wifasoi/PrusaMendel/docs/documentation.pdf

## Prusa Mendel iteration 2 Documentation

ThingDoc

November 16, 2011


Prusa Mendel is simplified version of Mendel form RepRap project. RepRap is open source 3D printer.

## Contents

## 1 Bill of Materials

List of things you need to build the machine divided by categories.

### 1.1 Rods and Bars

- 1x Idler

### 1.2 Nuts&bolts

- 3x 608 skate bearing
- 4x M4 nut
- 3x M3 10mm screw
- 2x M4 25mm screw
- 1x M8 hobbed bolt
- 8x M3 15mm screw with HEX head
- 2x M3 10mm screw with hex head
- 1x M3 25mm screw
- 1x M3 grub screw
- 2x M3 25mm screw with HEX head
- 12x M3 nut
- 73x M8 washer
- 74x M8 nut
- 29x M3 washer
- 1x M3 10mm screw with flat head
- 2x M3 40mm screw

### 1.3 Printed

- 1x Extruder body
- 8x Bar clamp
- 4x Y bushing
- 2x Frame vertex
- 1x Y motor bracket
- 1x Small extruder gear

- 2x Rod clamp
- 4x Frame vertex with foot
- 1x Large extruder gear
- 2x Belt clamp
- 1x Extruder Idler
- 1x Z motor mount
- 1x X carriage

## 2 Things Overview

List of things and their descriptions.

### 2.1 Coupling tube

20mm long piece of PVC tube. 5mm inside diameter, 8mm outside diameter.

### 2.2 Frame triangle

Two triangle parts which will later form a frame.

### 2.3 Frame with axes

Frame with all axes mounted

### 2.4 Frame vertex


### 2.5 Frame

Frame for adding all of the other parts There is a triangle on each side of the Prusa RepRap. You will need to make two of these and then connect them together (in the next steps) to form the Prusa frame. Each side is an equilateral triangle with a frame vertex on each corner. You can use either footed or non-footed vertices to build this. (The footed ones look better, but are not critical.) The instructions assume you are using footed vertices.

### 2.6 Y motor bracket


### 2.7 Belt clamp


### 2.8 M8 hobbed bolt

### 2.9 Extruder Idler

Extruder idler

### 2.10 Frame with Y axis

Frame with Y axis mounted

### 2.11 Y bushing

### 2.12 Bar clamp


### 2.13 XZ axis

Assembled XZ axis

### 2.14 Large extruder gear

### 2.15 Frame vertex with foot


### 2.16 X end motor

### 2.17 Extruder body

Extruder body

### 2.18 Small extruder gear

### 2.19 Extruder spring

Spring used for idler on extruder.

### 2.20 Printable Bushing

### 2.21 X carriage


### 2.22 X end idler

### 2.23 Rod clamp


### 2.24 Z motor mount


### 2.25 Endstop holder

### 2.26 Bushing

### 2.27 Idler

Small M8 rod

### 2.28 Pulley

### 2.29 Coupling

### 2.30 Y axis

Assembled Y axis

### 2.31 Bearing guide

Helps to hold belt aligned on the bearing.

### 2.32 Carriage

X-carriage with mounted extruder

### 2.33 Extruder

Extruder

## 3 Assembly Instructions

### 3.1 Assemble Small extruder gear

Things needed:

- 1x M3 nut
- 1x M3 grub screw

Steps:

1. Insert nut into cavity in printed gear.
2. Tighten the grub screw a bit, just to hold in place.

### 3.2 Assemble M8 hobbed bolt

Steps:

1. Use thread cutting bit in electric screwdriver ...

### 3.3 Assemble Large extruder gear

Things needed:

- 1x M8 hobbed bolt

Steps:

1. Insert hobbed bolt into main hole.
2. Add some M8 washers from other side, later with their count you adjust position of hobbed part in filament path.

### 3.4 Assemble Extruder Idler

Things needed:

- 1x 608 skate bearing
- 1x Idler

Steps:

1. Insert piece of M8 rod into bearing.
2. Insert 608 bearing with rod into printed idler part.

### 3.5 Assemble Extruder

Things needed:

- 2x 608 skate bearing
- 1x Extruder body
- 3x M3 10mm screw
- 2x M4 nut
- 1x Small extruder gear
- 1x M3 25mm screw
- 1x NEMA17 stepper motor
- 1x Large extruder gear
- 8x M3 washer
- 1x M8 washer
- 1x Extruder Idler
- 1x M3 nut
- 2x M3 40mm screw
- 2x Extruder spring
- 2x M8 nut

Steps:

1. Take idler and insert nut into small nut-trap inside the hinge.
2. While holding the nut in place, preprare M3x25 bolt with washer and screw it into the hinge just enough to hold the nut.
3. Now take the extruder body and idler. Place idler on the hinge counterpart and com-pleately screw the M3x25 bolt. This will create secured hinge.
4. Place M4 nuts into their nut traps, secure them with piece of tape. We need them in place, since later they would be harder to access.
5. Prepare your NEMA17 stepper motor and three M3x10 screws with washers.
6. Hold motor on place and lightly tighten the screws. We need to adjust motor position later, no need to tighten it hard.
7. Place two skate bearings on ther position, they should snuggly fit in.
8. Insert prepared large gear into the body with mounted bearings.

9. Check if the alignment of hobbed part with the filament path. Adjust it accordingly with adding or removing M8 washers.
10. After adjusting, we need to fix the bolt in. So we place washer at the end of hobbed bolt and with two M8 nuts we will do locknut by tightening them against each other.
11. Check if large gear turns freely.
12. Prepare two M3x40 screws with sandwitch of washer-spring-washer.
13. Insert two M3 nuts into nut traps on top of drive mechanism.


14. Insert prepared screws into the holes on idler. Close the idler and tighten the screws into the trapped nuts. More you tighten those screws, more pressure will be on fillament.
15. Your extruder is done.


### 3.6 Assemble Frame triangle

Things needed:

- 1x Bar clamp
- 1x Frame vertex
- 2x Frame vertex with foot

Steps:

1. Take one of the 370mm threaded rods, and slip an M8 washer onto the middle of it.
2. Take the RP bar clamp (the U-shaped bit with the two holes) and slide the threaded rod through the two holes until the clamp sits next to the washer.
3. Slide another washer onto the rod from the other side.
4. Thread two M8 nuts onto either side of the clamp, until they are next to the washer, but do not tighten them yet.

5. Thread another two nuts on each side of the rod, followed by washers. See the picture for what it should look like.


6. The bar clamp on the threaded rod.
7. Slide the rod through the wider bottom (footed) side of two vertices. Make sure the feet point in the same direction, and the bulge on the non-footed sides of the vertices point outwards.
8. Measure the distance. The distance between the two vertices should be 290mm (along the rod, equivalent is 11-13/32”). Get it approximately right now, we will check this again later. If you have a frame jig, place it between the two vertices and adjust the nuts until you can just barely fit the jig J1 between them.
9. Place another washer and nut on the other side of the vertex. Tighten, but not too much. We’ll need a bit of flexibility here still.
10. Take another 370mm M8 threaded rod and place a nut followed by a washer at each end.
11. Place one end of the threaded rod into the one of the two footed frame vertices. It should be in the same plane as the first threaded rod. Fix it in place with a washer and nut. You should now have two sides of the equilateral triangle.
12. Take the third piece of threaded rod and put a nut and washer on each end. Place it in the other footed vertex and fix it in place with a washer and nut. You should now have a triangle of threaded rods with two footed vertices on two of the corners, nothing in the third corner, and a bar clamp between the two vertices.
13. Take the third vertex (non-footed) and slide it onto the threaded rods in the final corner of the triangle. Measure the lengths of the three sides to make sure they are all 290mm long (along the rod from plastic part to plastic part, equivalent is 11-13/32”). Adjust the nuts to make sure this is so. Use the frame jig J1 if you have one. Once done, place a washer and nut on each of the two rods at the top of the vertex. Tighten all the outer nuts.
14. The finished frame triangle
15. You should now have a sturdy triangle with equal-length sides, two feet on the bottom, and a bar clamp between the feet. Adjust the nuts around the bar clamp (but do not crush the bar clamp together yet) until it’s approximately in the middle of the rod. Leave the nuts there loose. See the photo for what you should have at this point.

16. That’s it, that’s one of the triangles done. Repeat the entire procedure for the second triangle. It is identical to the first.


### 3.7 Assemble Prusa Mendel iteration 2

Things needed:

- 1x Carriage
- 1x Frame with axes

Steps:

1. Assembly info
