wifasoi/PrusaMendel/Stampante3D conversion/Export/Images/image1.png

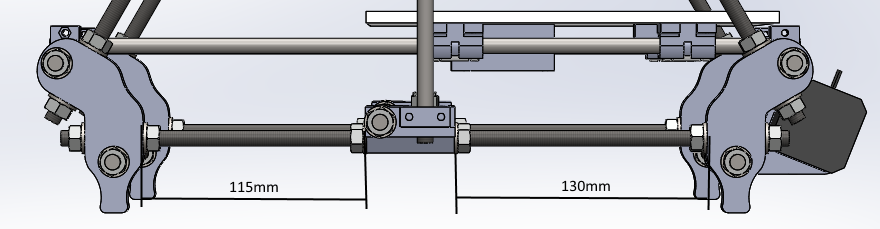
Stampante3D conversion/Export/Images/image1.png
