wifasoi/PrusaMendel/Stampante3D conversion/Export/Images/image2.png

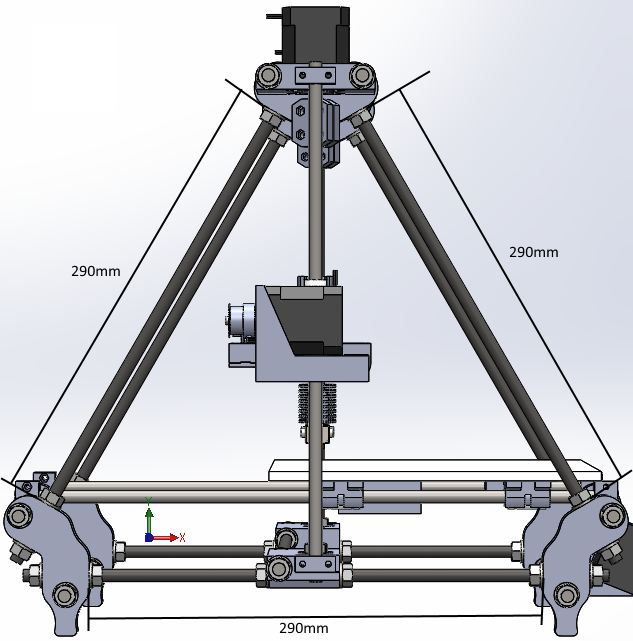
Stampante3D conversion/Export/Images/image2.png
