wifasoi/PrusaMendel/Stampante3D conversion/Export/Images/image3.png

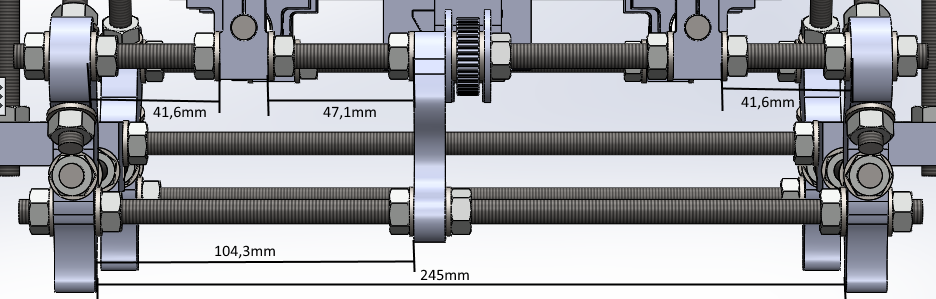
Stampante3D conversion/Export/Images/image3.png
