wifasoi/PrusaMendel/Stampante3D conversion/Export/Images/image4.png

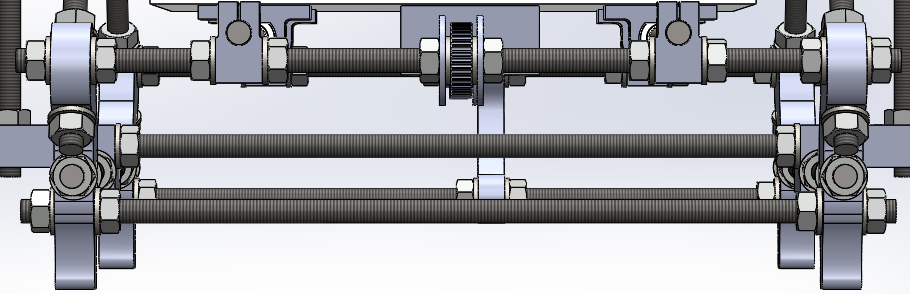
Stampante3D conversion/Export/Images/image4.png
