wifasoi/PrusaMendel/SolidWorks/Vitamins/flat washer, DIN 125.xlsx

flat washer, DIN 125 Data aken from McMaster-Carr catalog |  |  | MMC
 | ID@Sketch1 | OD@Sketch1 | thickness@Boss-Extrude1 | $prp@Size | $prp@Finish | $prp@Class | $prp@Material
M01.0 Zinc Plated Class 4 Steel | 1.1 | 3.2 | 0.35 | 1 | Zinc Plated | 4 | Steel
M01.2 Zinc Plated Class 4 Steel | 1.3 | 3.8 | 0.35 | 1.2 | Zinc Plated | 4 | Steel
M01.4 Zinc Plated Class 4 Steel | 1.5 | 3.8 | 0.35 | 1.4 | Zinc Plated | 4 | Steel
M01.6 Zinc Plated Class 4 Steel | 1.7 | 4 | 0.35 | 1.6 | Zinc Plated | 4 | Steel
M02.0 Zinc Plated Class 4 Steel | 2.2 | 5 | 0.35 | 2 | Zinc Plated | 4 | Steel
M02.5 Zinc Plated Class 4 Steel | 2.7 | 6 | 0.55 | 2.5 | Zinc Plated | 4 | Steel
M03.0 Zinc Plated Class 4 Steel | 3.2 | 7 | 0.55 | 3 | Zinc Plated | 4 | Steel
M03.5 Zinc Plated Class 4 Steel | 3.7 | 8 | 0.55 | 3.5 | Zinc Plated | 4 | Steel
M04.0 Zinc Plated Class 4 Steel | 4.3 | 9 | 0.9 | 4 | Zinc Plated | 4 | Steel
M05.0 Zinc Plated Class 4 Steel | 5.3 | 10 | 1.1 | 5 | Zinc Plated | 4 | Steel
M06.0 Zinc Plated Class 4 Steel | 6.4 | 12 | 1.8 | 6 | Zinc Plated | 4 | Steel
M07.0 Zinc Plated Class 4 Steel | 7.4 | 14 | 1.8 | 7 | Zinc Plated | 4 | Steel
M08.0 Zinc Plated Class 4 Steel | 8.4 | 16 | 1.8 | 8 | Zinc Plated | 4 | Steel
M10.0 Zinc Plated Class 4 Steel | 10.5 | 20 | 2.2 | 10 | Zinc Plated | 4 | Steel
M12.0 Zinc Plated Class 4 Steel | 13 | 24 | 2.7 | 12 | Zinc Plated | 4 | Steel
M14.0 Zinc Plated Class 4 Steel | 15 | 28 | 2.7 | 14 | Zinc Plated | 4 | Steel
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
M05.0 18-8 Stainless Steel | 5.3 | 10 | 1.1 | 5 |  |  | 18-8 Stainless Steel
M06.0 18-8 Stainless Steel | 6.4 | 12 | 1.8 | 6 |  |  | 18-8 Stainless Steel
M07.0 18-8 Stainless Steel | 7.4 | 14 | 1.8 | 7 |  |  | 18-8 Stainless Steel
M08.0 18-8 Stainless Steel | 8.4 | 16 | 1.8 | 8 |  |  | 18-8 Stainless Steel
M10.0 18-8 Stainless Steel | 10.5 | 20 | 2.2 | 10 |  |  | 18-8 Stainless Steel
M12.0 18-8 Stainless Steel | 13 | 24 | 2.7 | 12 |  |  | 18-8 Stainless Steel
M14.0 18-8 Stainless Steel | 15 | 28 | 2.7 | 14 |  |  | 18-8 Stainless Steel
M16.0 18-8 Stainless Steel | 17 | 30 | 3.3 | 16 |  |  | 18-8 Stainless Steel
M18.0 18-8 Stainless Steel | 19 | 34 | 3.3 | 18 |  |  | 18-8 Stainless Steel
M20.0 18-8 Stainless Steel | 21 | 37 | 3.3 | 20 |  |  | 18-8 Stainless Steel
M24.0 18-8 Stainless Steel | 25 | 44 | 4.3 | 24 |  |  | 18-8 Stainless Steel
M30.0 18-8 Stainless Steel | 31 | 56 | 4.3 | 30 |  |  | 18-8 Stainless Steel
M36.0 18-8 Stainless Steel | 37 | 66 | 5.6 | 36 |  |  | 18-8 Stainless Steel
M39.0 18-8 Stainless Steel | 40 | 72 | 6.6 | 39 |  |  | 18-8 Stainless Steel
M42.0 18-8 Stainless Steel | 43 | 78 | 8 | 42 |  |  | 18-8 Stainless Steel
