wifasoi/PrusaMendel/SolidWorks/Vitamins/hex nut, DIN 934.xlsx

hex nut, DIN 934 from McMaster-Carr
 | Size@Sketch1 | Width@Sketch1 | Thickness@Boss-Extrude1 | $prp@Size | $prp@Pitch | $prp@Finish | $prp@Class | $prp@Material
M01.6x0.35 | 1.6 | 3.2 | 1.3 | M1.6 | 0.35 | Zinc Plated | 6 | Steel
M02.0x0.4 | 2 | 4 | 1.6 | M2 | 0.4 | Zinc Plated | 6 | Steel
M02.5x0.45 | 2.5 | 5 | 2 | M2.5 | 0.45 | Zinc Plated | 6 | Steel
M02.6x0.45 | 2.6 | 6 | 2 | M2.6 | 0.45 | Zinc Plated | 6 | Steel
M03x0.5 | 3 | 5.5 | 2.4 | M3 | 0.5 | Zinc Plated | 6 | Steel
M04x0.6 | 3.5 | 6 | 2.8 | M3.5 | 0.6 | Zinc Plated | 6 | Steel
M04x0.7 | 4 | 7 | 3.2 | M4 | 0.7 | Zinc Plated | 6 | Steel
M05x0.8 | 5 | 8 | 4 | M5 | 0.8 | Zinc Plated | 6 | Steel
M06x1 | 6 | 10 | 5 | M6 | 1 | Zinc Plated | 6 | Steel
M07x1 | 7 | 11 | 5.5 | M7 | 1 | Zinc Plated | 6 | Steel
M08x1.25 | 8 | 13 | 6.5 | M8 | 1.25 | Zinc Plated | 6 | Steel
M10x1.5 | 10 | 17 | 8 | M10 | 1.5 | Zinc Plated | 6 | Steel
M12x1.75 | 12 | 19 | 10 | M12 | 1.75 | Zinc Plated | 6 | Steel
M14x2 | 14 | 22 | 11 | M14 | 2 | Zinc Plated | 6 | Steel
M16x2 | 16 | 24 | 13 | M16 | 2 | Zinc Plated | 6 | Steel
M18x2.5 | 18 | 27 | 15 | M18 | 2.5 | Zinc Plated | 6 | Steel
M20x2.5 | 20 | 30 | 16 | M20 | 2.5 | Zinc Plated | 6 | Steel
M24x3 | 24 | 36 | 19 | M24 | 3 | Zinc Plated | 6 | Steel
M30x3.5 | 30 | 46 | 24 | M30 | 3.5 | Zinc Plated | 6 | Steel
M36x4 | 36 | 55 | 29 | M36 | 4 | Zinc Plated | 6 | Steel
