wifasoi/PrusaMendel/Stampante3D conversion/organized/Miscelenea parts/microswitch/Renderings/MicroSwitch_asm.JPG

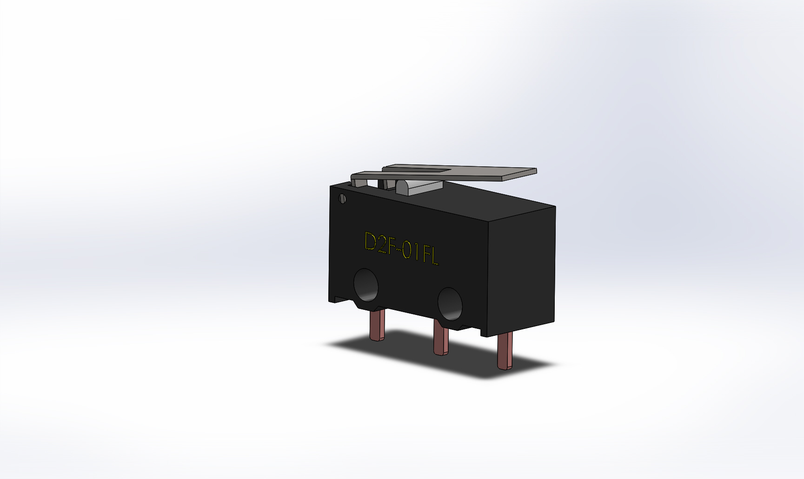
Stampante3D conversion/organized/Miscelenea parts/microswitch/Renderings/MicroSwitch_asm.JPG
