wifasoi/PrusaMendel/Stampante3D conversion/organized/Extruder/Extruder.SLDASM

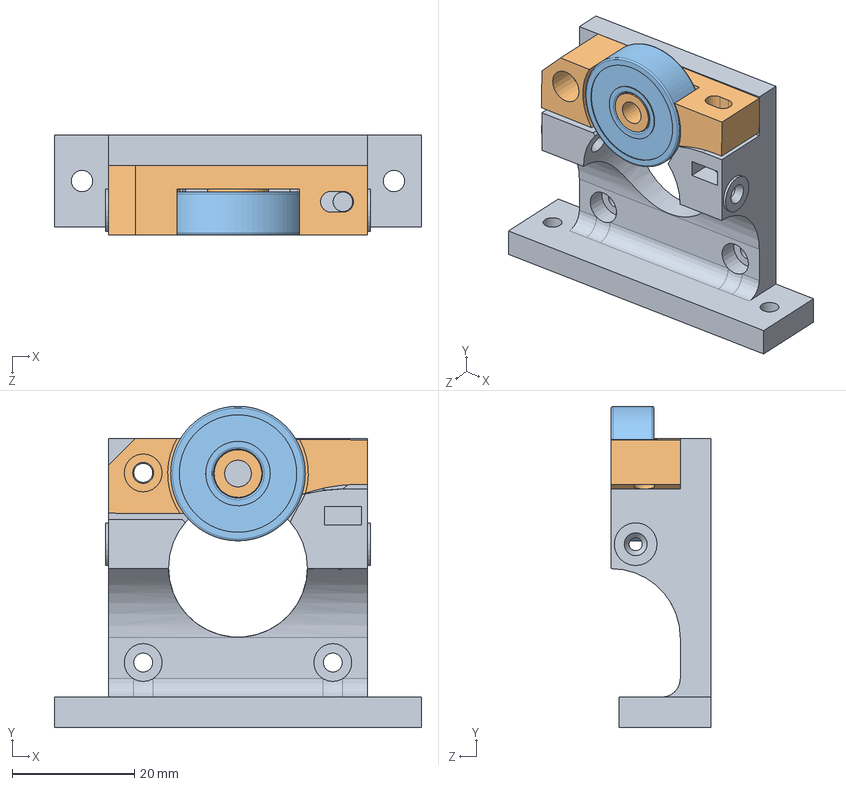
[picture p35: CAD file, 2015-09-14]
Stampante3D conversion/organized/Extruder/Extruder.SLDASM
60.0 x 52.5 x 16.3 mm
Cold-end-Base
Cold-end-Tensioner
608 SKF
