wifasoi/PrusaMendel/Stampante3D conversion/organized/Miscelenea parts/microswitch/MicroSwitch_asm.SLDASM

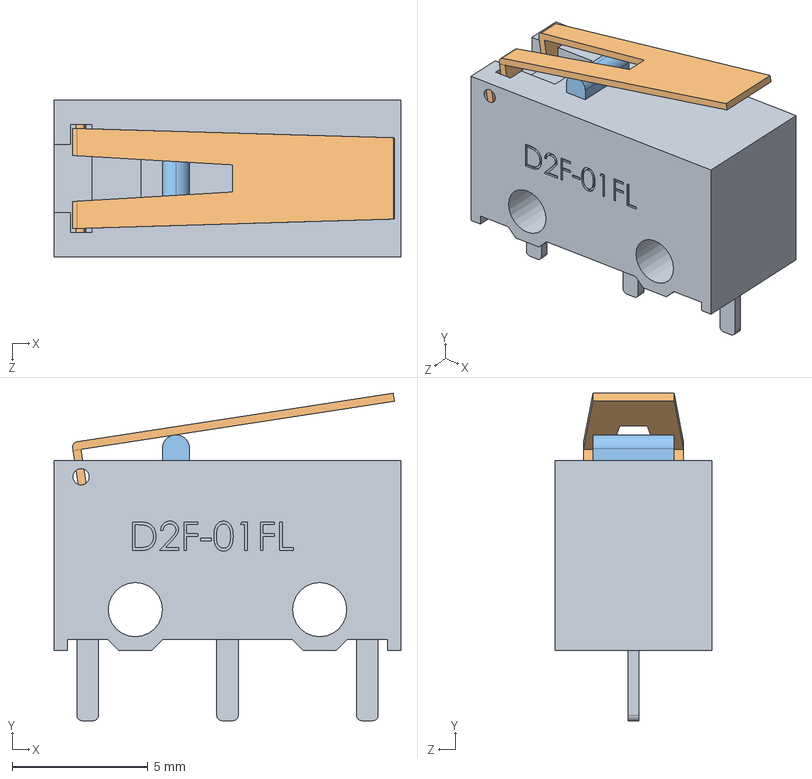
[picture p36: CAD file, 2015-07-27]
Stampante3D conversion/organized/Miscelenea parts/microswitch/MicroSwitch_asm.SLDASM
12.8 x 12.1 x 5.80 mm
MicroSwitchBody
MicroSwichLever
MicroSwichKnob
