wifasoi/PrusaMendel/Stampante3D conversion/organized/Prusa 2 assembled.SLDASM

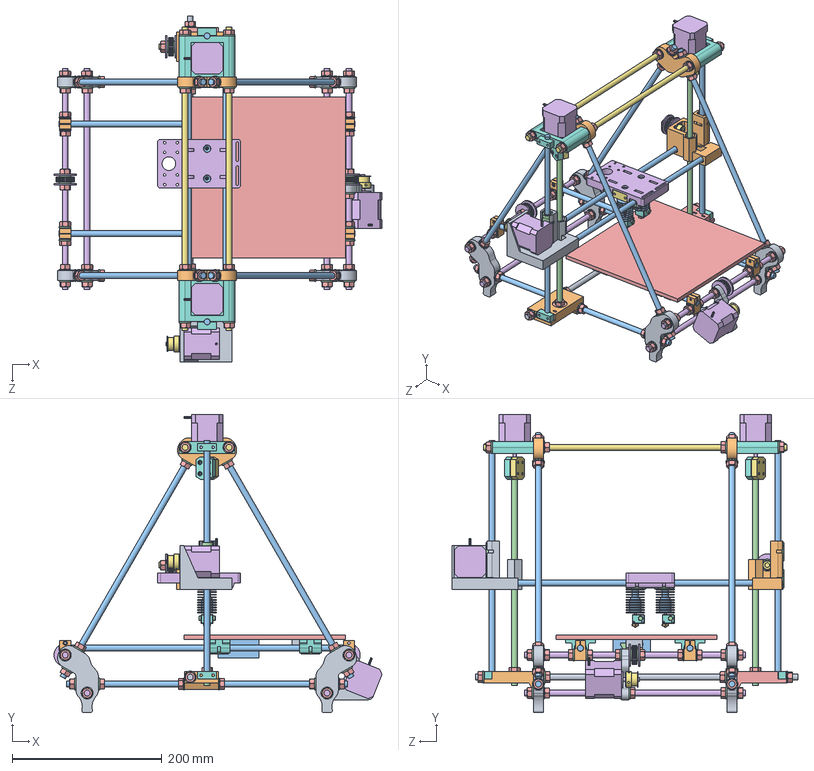
[picture p37: CAD file, 2016-06-02]
Stampante3D conversion/organized/Prusa 2 assembled.SLDASM
437.5 x 398.2 x 461.3 mm
Frame-feet x 4
Frame-vertex x 2
threaded rod, frame triangle x 6
flat washer, DIN 125 x 74
hex nut, DIN 934 x 79
threaded rod, frame horizontal x 4
threaded rod, Z frame horizontal x 2
Z-Motor-clamp x 2
Y-Motor-clamp
wifa_clamp x 4
smooth rod, Y axis x 2
Linear Bearing, LM8UU x 12
Y Carriage Plate
stepper motor, NEMA 17 x 4
Coupling x 2
Coupling-hex_recess x 2
X-motor
X-idle
smooth rod, X axis x 2
Spring x 2
Bearing, 608-2RS x 5
M8 fender washer x 6
GT2 pulley 6mm x 2
lm8uu-mount x 4
Belt_mount-Bottom
Belt_mount-Top
Belt_tensioner-Base
Belt_tensioner-Slider-Bot
Belt_tensioner-Slider-Top
X-head_carriage
X-head_carriage-Hot_end-Clamp x 2
E3D Heat Block x 2
E3D Heatbreak x 2
E3D Nozzle x 2
E3D Heatsink x 2
cartridge heater x 2
thermistor x 2
Bearing cover x 3
Socket Head Cap Screw DIN 912, ISO 4762
Z-bar-clamp x 4
threaded rod, Z lower horizontal
Middle_clamp-Left
smooth rod, Z axis x 2
threaded rod, Z screw x 2
Middle_clamp-Right
