wifasoi/PrusaMendel/Stampante3D conversion/organized/X axis/X-carriage/X-carriage.SLDASM

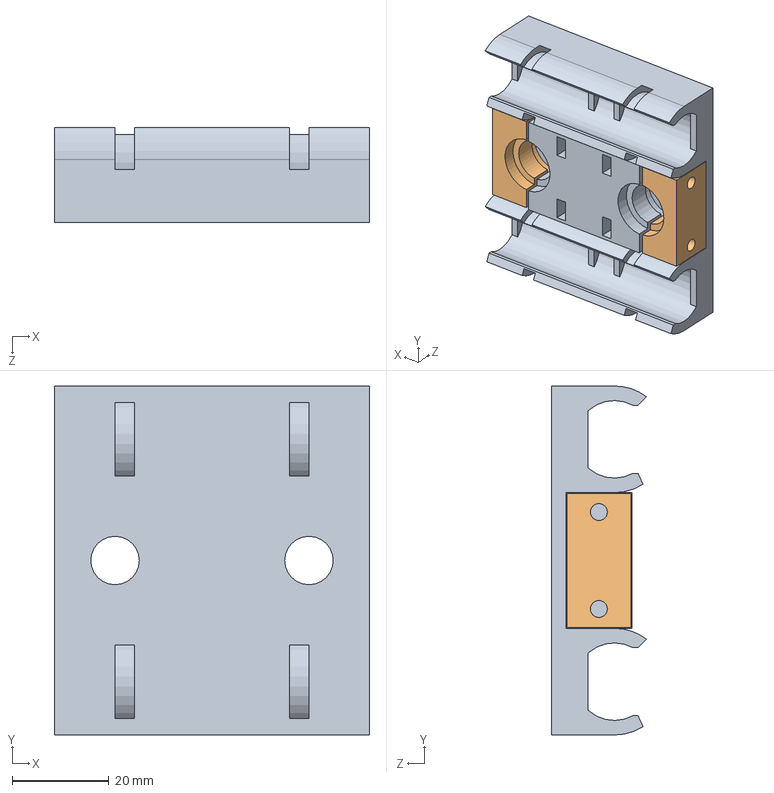
[picture p38: CAD file, 2016-06-02]
Stampante3D conversion/organized/X axis/X-carriage/X-carriage.SLDASM
65.0 x 72.0 x 19.6 mm
X-head_carriage
X-head_carriage-Hot_end-Clamp x 2
