wifasoi/PrusaMendel/Stampante3D conversion/organized/Y axis/Belt mount/Belt mount/Belt_mount.SLDASM

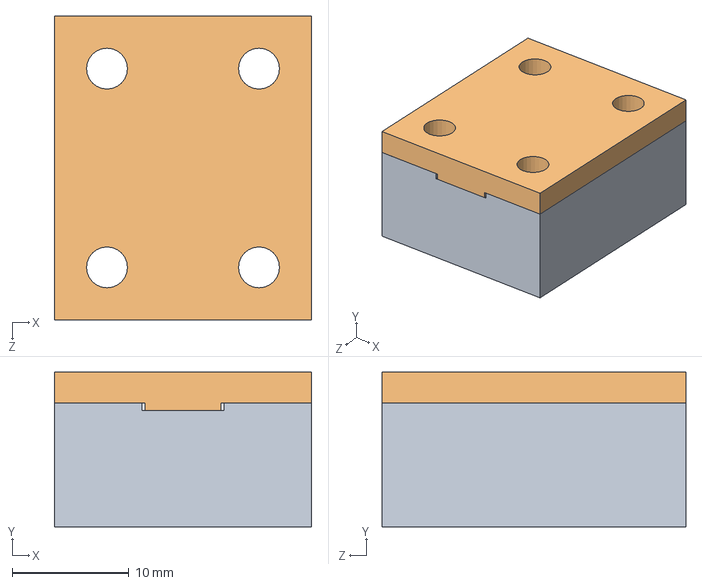
[picture p39: CAD file, 2015-09-13]
Stampante3D conversion/organized/Y axis/Belt mount/Belt mount/Belt_mount.SLDASM
22.0 x 13.2 x 26.0 mm
Belt_mount-Bottom
Belt_mount-Top
