wifasoi/PrusaMendel/Stampante3D conversion/organized/Y axis/Belt mount/Belt tensioner/Belt-tensioner.SLDASM

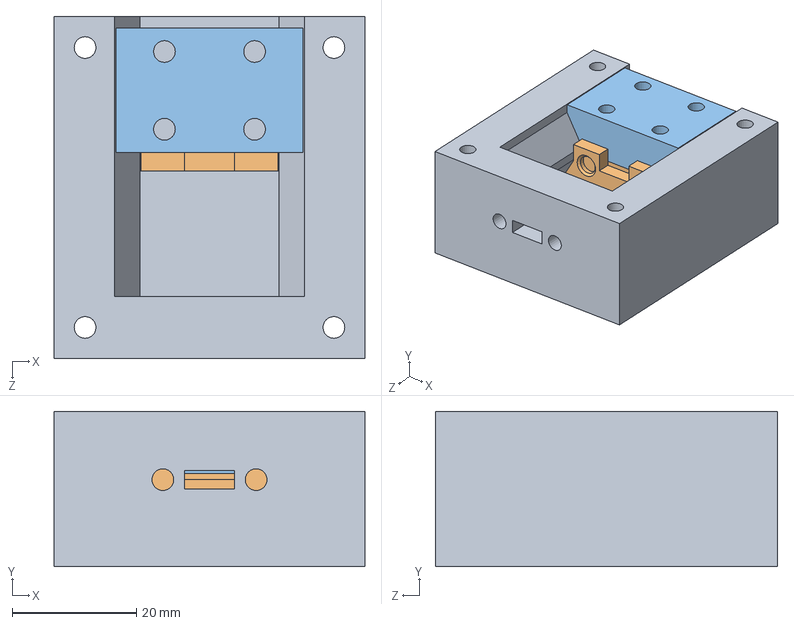
[picture p40: CAD file, 2015-09-05]
Stampante3D conversion/organized/Y axis/Belt mount/Belt tensioner/Belt-tensioner.SLDASM
50.0 x 25.0 x 55.0 mm
Belt_tensioner-Base
Belt_tensioner-Slider-Bot
Belt_tensioner-Slider-Top
