wifasoi/PrusaMendel/SolidWorks/Prusa 2 Frame.SLDASM

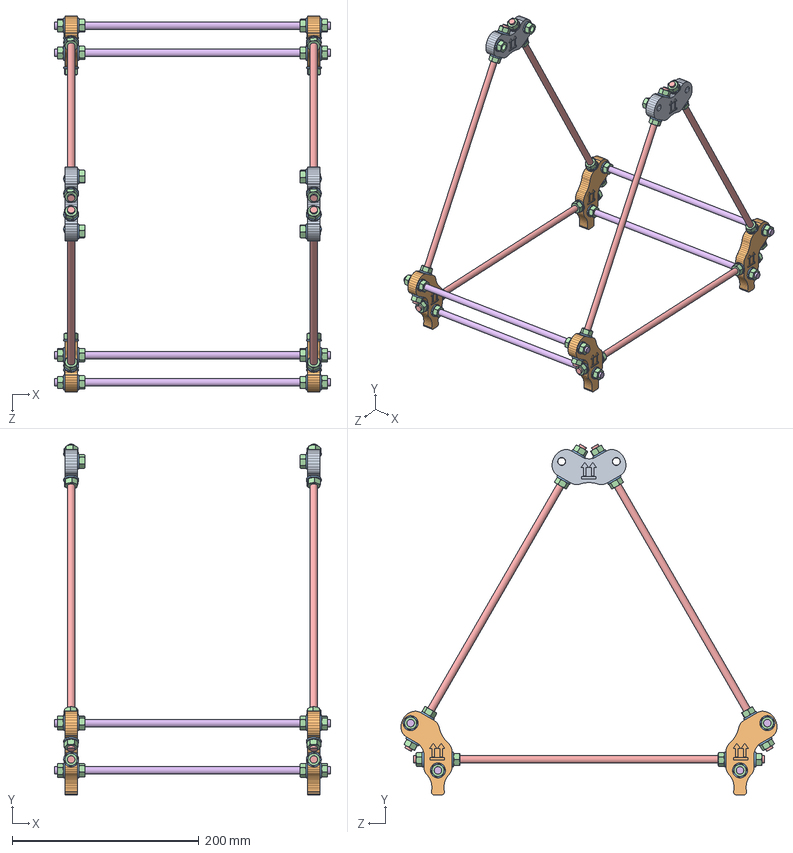
[picture p41: CAD file, 2015-07-08]
SolidWorks/Prusa 2 Frame.SLDASM
295.8 x 375.9 x 402.9 mm
frame-vertex x 2
frame-vertex-foot x 4
flat washer, DIN 125 x 44
hex nut, DIN 934 x 44
threaded rod, frame triangle x 6
threaded rod, frame horizontal x 4
