wifasoi/PrusaMendel/SolidWorks/Prusa 2 Y Carriage - LM8UU.SLDASM

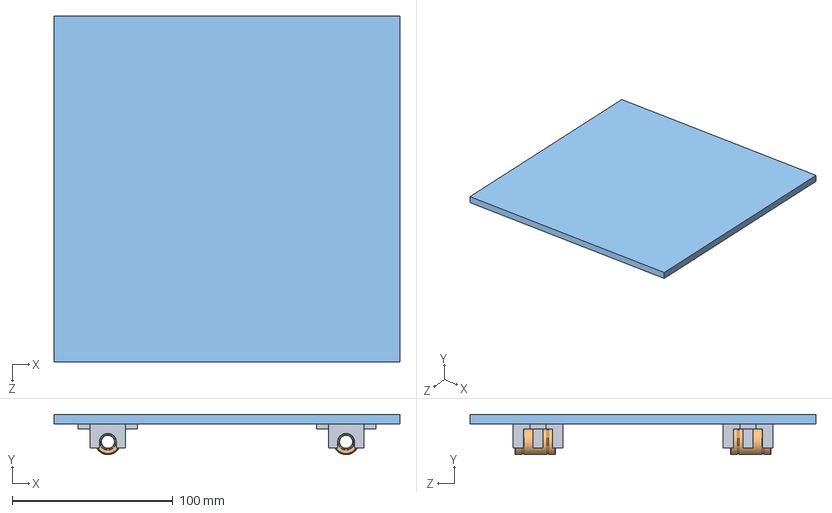
[picture p42: CAD file, 2015-07-08]
SolidWorks/Prusa 2 Y Carriage - LM8UU.SLDASM
215.0 x 25.0 x 215.0 mm
y-bushing lm8uu x 4
Linear Bearing, LM8UU x 4
Y Carriage Plate
