wifasoi/PrusaMendel/SolidWorks/Prusa 2 Idler pulley.sldasm

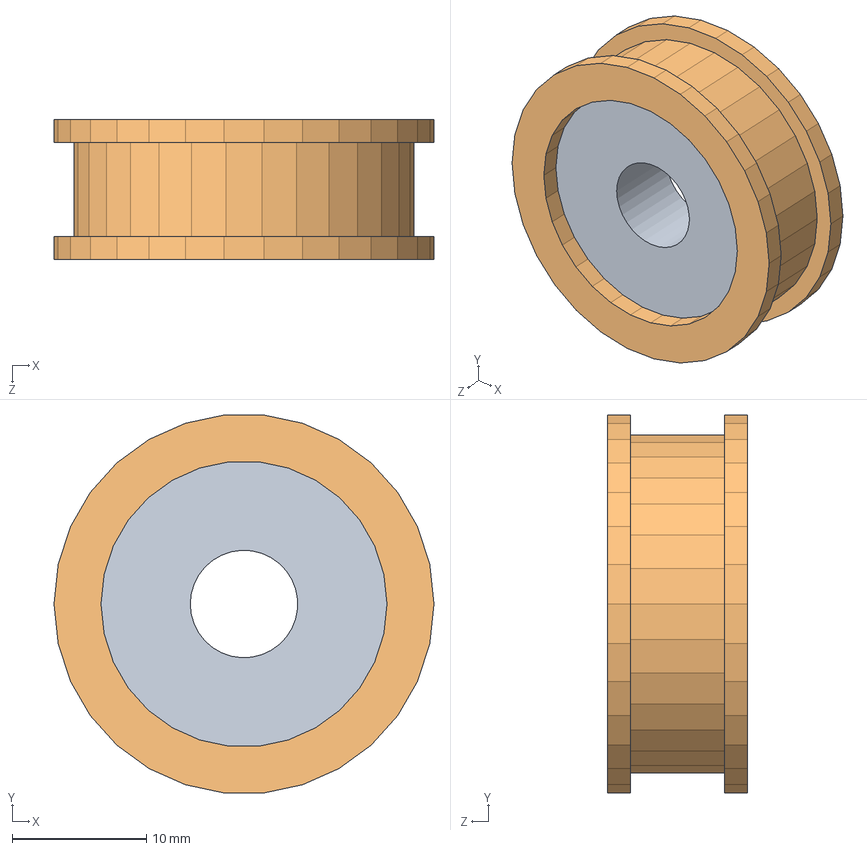
[picture p43: CAD file, 2015-07-08]
SolidWorks/Prusa 2 Idler pulley.sldasm
28.3 x 28.1 x 10.4 mm
Bearing, 608-2RS
bearing-guide
