wifasoi/PrusaMendel/SolidWorks/Prusa 2 X Carriage - LM8UU.SLDASM

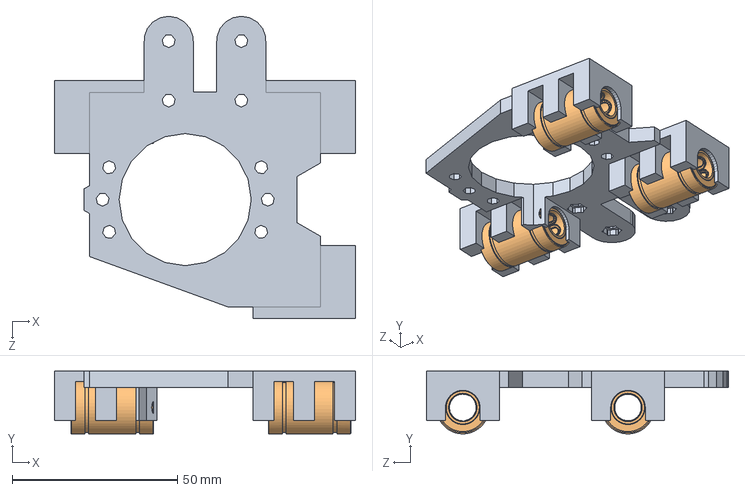
[picture p44: CAD file, 2015-07-08]
SolidWorks/Prusa 2 X Carriage - LM8UU.SLDASM
91.1 x 19.0 x 91.6 mm
x-carriage lm8uu
Linear Bearing, LM8UU x 3
