wifasoi/PrusaMendel/SolidWorks/Prusa 2 Y Axis.SLDASM

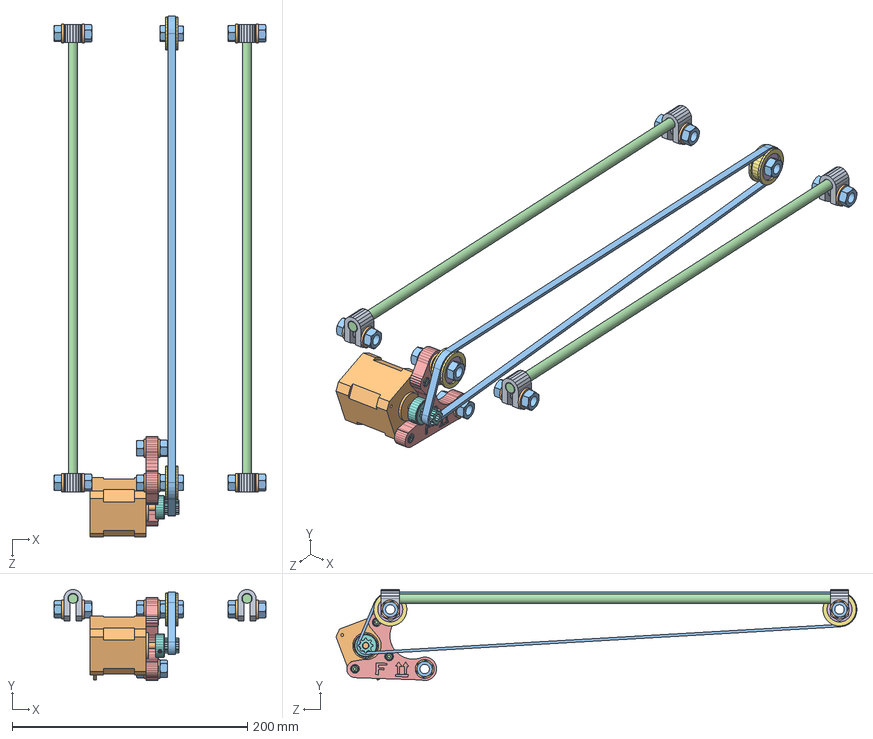
[picture p45: CAD file, 2015-07-08]
SolidWorks/Prusa 2 Y Axis.SLDASM
180.2 x 77.5 x 443.2 mm
bar-clamp x 4
flat washer, DIN 125 x 15
hex nut, DIN 934 x 16
smooth rod, Y axis x 2
ybrac-t
Bearing, 608-2RS x 2
bearing-guide x 2
pulley
set screw, cup point, M4x6
stepper motor, NEMA 17
Belt, Y Axis, T5
Socket Head Cap Screw DIN 912, ISO 4762 x 3
