wifasoi/PrusaMendel/SolidWorks/Prusa 2 Z Axis.SLDASM

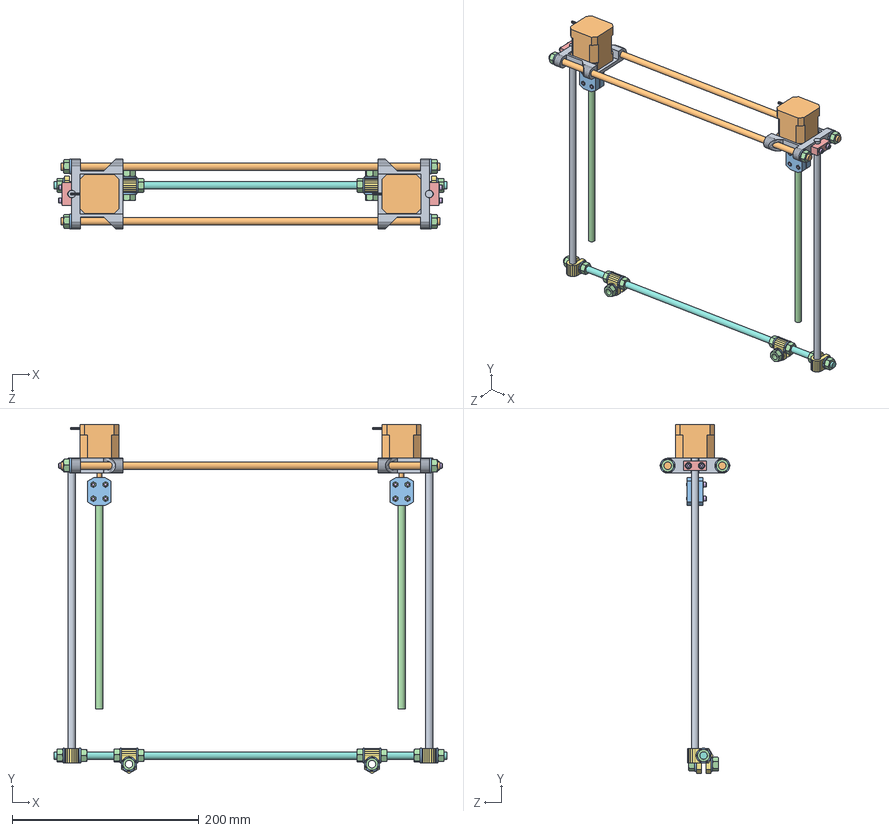
[picture p46: CAD file, 2015-07-08]
SolidWorks/Prusa 2 Z Axis.SLDASM
420.4 x 373.4 x 74.5 mm
z-motor-mount x 2
threaded rod, Z frame horizontal x 2
flat washer, DIN 125 x 28
hex nut, DIN 934 x 28
rod-clamp x 2
Socket Head Cap Screw DIN 912, ISO 4762 x 12
bar-clamp x 4
threaded rod, Z lower horizontal
smooth rod, Z axis x 2
stepper motor, NEMA 17 x 2
coupling x 2
threaded rod, Z screw x 2
