wifasoi/PrusaMendel/SolidWorks/Prusa 2 Pulley.sldasm

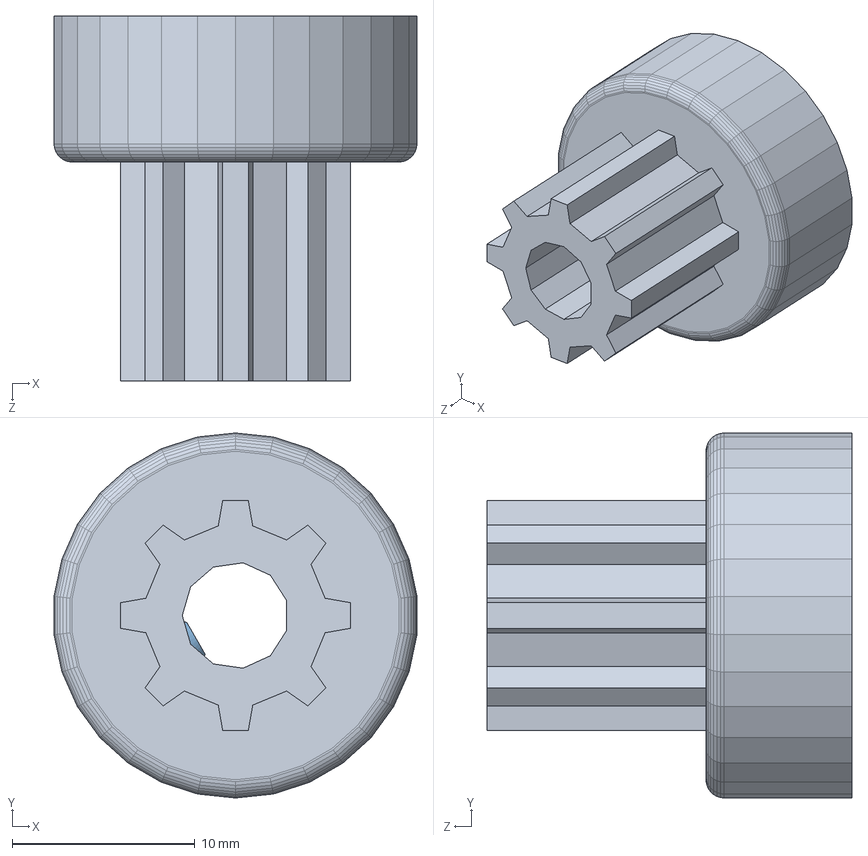
[picture p47: CAD file, 2015-07-08]
SolidWorks/Prusa 2 Pulley.sldasm
19.9 x 20.0 x 20.0 mm
pulley
hex nut, DIN 934
set screw, cup point, M4x6
