wifasoi/PrusaMendel/SolidWorks/Prusa 2 X Axis LM8UU.SLDASM

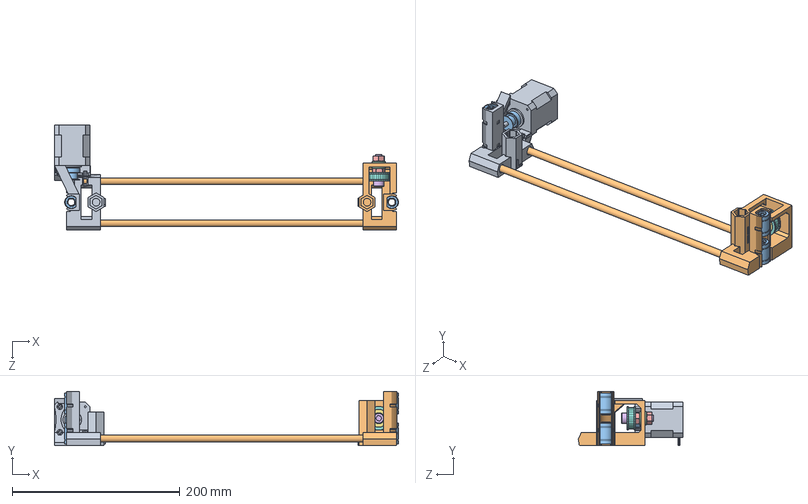
[picture p48: CAD file, 2015-07-08]
SolidWorks/Prusa 2 X Axis LM8UU.SLDASM
410.3 x 65.0 x 124.7 mm
x-end-motor lm8uu
x-end-idler lm8uu
Linear Bearing, LM8UU x 4
flat washer, DIN 125 x 2
hex nut, DIN 934 x 2
Socket Head Cap Screw DIN 912, ISO 4762
Bearing, 608-2RS
bearing-guide
stepper motor, NEMA 17
smooth rod, X axis x 2
my_pulley
