wifasoi/PrusaMendel/SolidWorks/Prusa 2.SLDASM

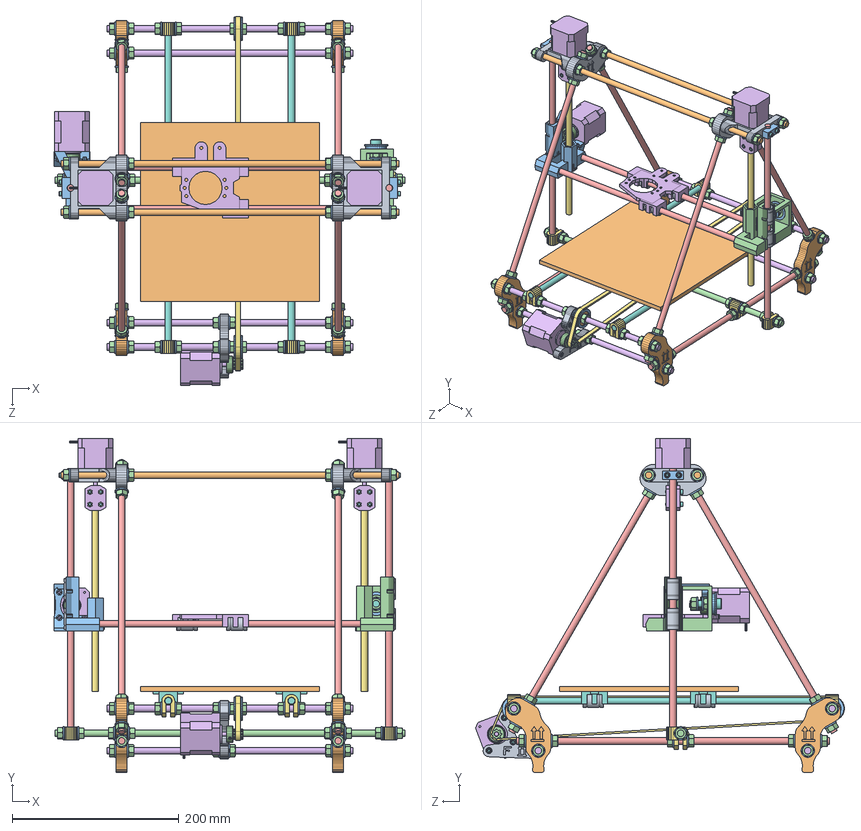
[picture p49: CAD file, 2015-07-08]
SolidWorks/Prusa 2.SLDASM
421.4 x 401.3 x 443.2 mm
frame-vertex x 2
frame-vertex-foot x 4
flat washer, DIN 125 x 89
hex nut, DIN 934 x 91
threaded rod, frame triangle x 6
threaded rod, frame horizontal x 4
bar-clamp x 8
smooth rod, Y axis x 2
ybrac-t
Bearing, 608-2RS x 3
bearing-guide x 3
pulley x 2
set screw, cup point, M4x6 x 2
stepper motor, NEMA 17 x 4
Belt, Y Axis, T5
Socket Head Cap Screw DIN 912, ISO 4762 x 16
z-motor-mount x 2
threaded rod, Z frame horizontal x 2
rod-clamp x 2
threaded rod, Z lower horizontal
smooth rod, Z axis x 2
coupling x 2
threaded rod, Z screw x 2
y-bushing lm8uu x 4
Linear Bearing, LM8UU x 11
Y Carriage Plate
x-end-motor lm8uu
x-end-idler lm8uu
smooth rod, X axis x 2
x-carriage lm8uu
