wifasoi/PrusaMendel/metric-prusa-lm8uu/sanguinololu-holder.stl

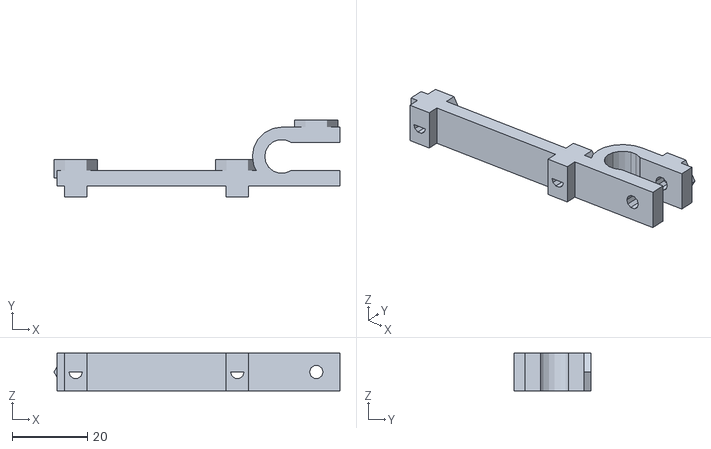
[picture p50: CAD file, 2011-11-21]
metric-prusa-lm8uu/sanguinololu-holder.stl
76.1 x 20.5 x 10.0
