wifasoi/PrusaMendel/SolidWorks/Imported/frame-vertex-foot.stl.SLDPRT

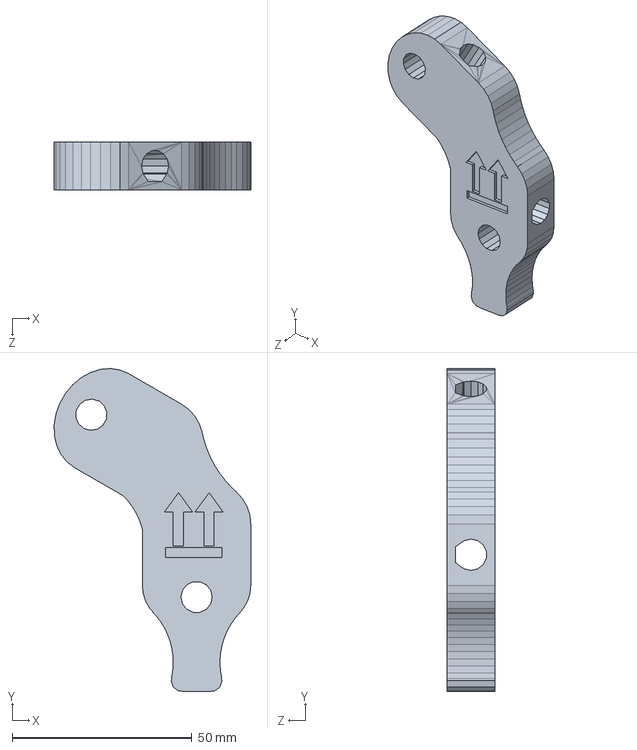
[picture p52: CAD file, 2012-01-01]
SolidWorks/Imported/frame-vertex-foot.stl.SLDPRT
54.7 x 89.8 x 13.2 mm
