wifasoi/PrusaMendel/SolidWorks/wifa_clamp.SLDPRT

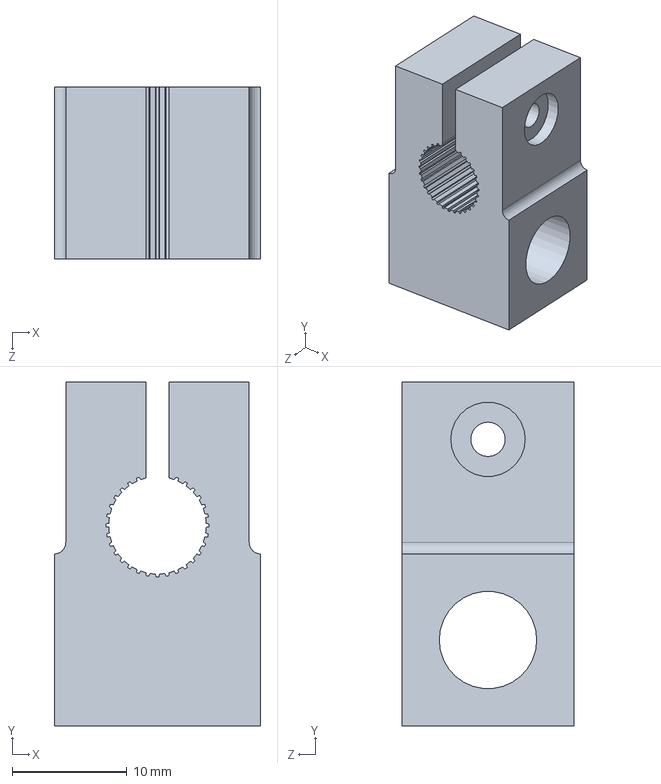
[picture p53: CAD file, 2015-07-08]
SolidWorks/wifa_clamp.SLDPRT
18.0 x 30.0 x 15.0 mm
