wifasoi/PrusaMendel/source/this-way-up.dxf

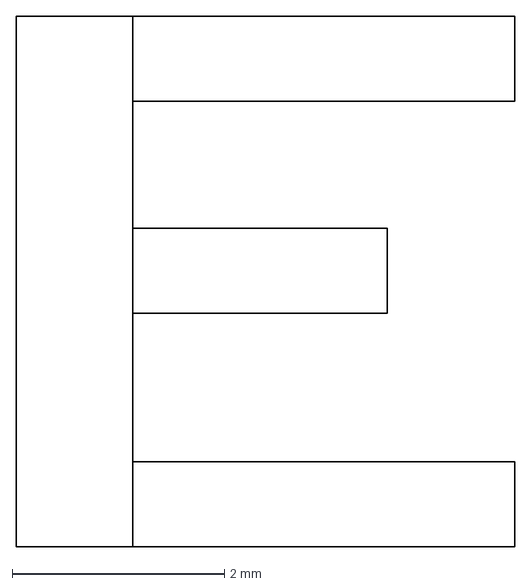
[picture p54: CAD file, 2011-11-21]
source/this-way-up.dxf
4.70 x 5.00 mm
