wifasoi/PrusaMendel/Stampante3D conversion/Export/Steps/Frame-vertex.STEP

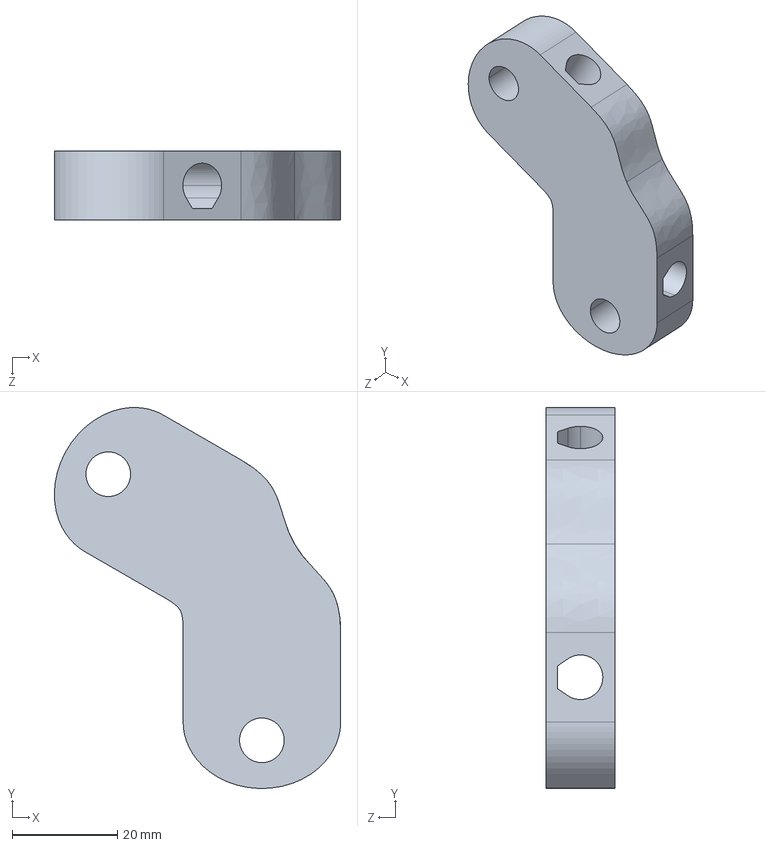
[picture p55: CAD file, 2016-06-02]
Stampante3D conversion/Export/Steps/Frame-vertex.STEP
54.5 x 72.5 x 13.2 mm
