wifasoi/PrusaMendel/Stampante3D conversion/organized/Frame/Frame-vertex.SLDPRT

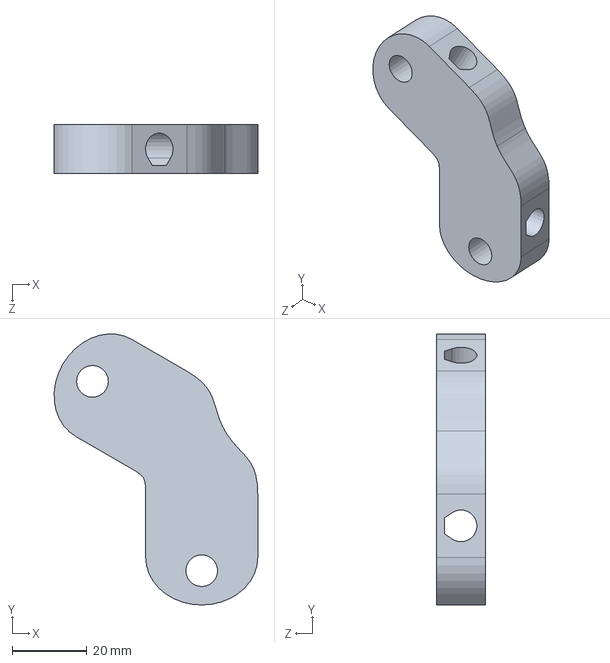
[picture p56: CAD file, 2015-09-05]
Stampante3D conversion/organized/Frame/Frame-vertex.SLDPRT
54.5 x 72.5 x 13.2 mm
