wifasoi/PrusaMendel/Stampante3D conversion/organized/Miscelenea plastic parts/Coupling/Coupling.SLDPRT

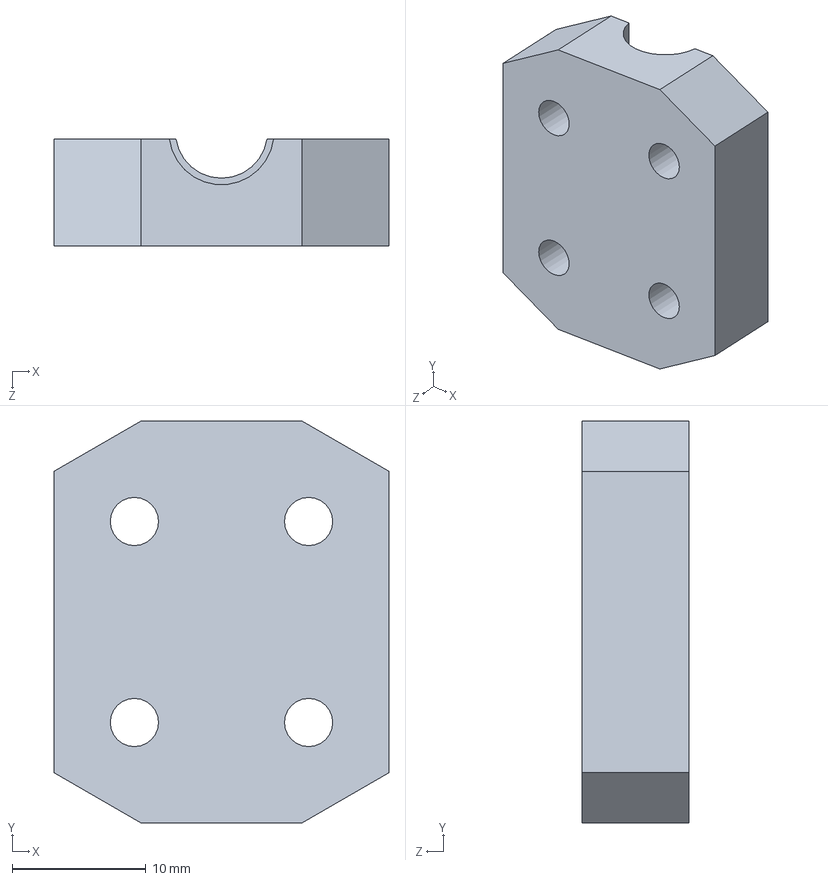
[picture p57: CAD file, 2015-07-25]
Stampante3D conversion/organized/Miscelenea plastic parts/Coupling/Coupling.SLDPRT
25.0 x 30.0 x 8.00 mm
