wifasoi/PrusaMendel/Stampante3D conversion/organized/Miscelenea plastic parts/Middle_clamp-Right.SLDPRT

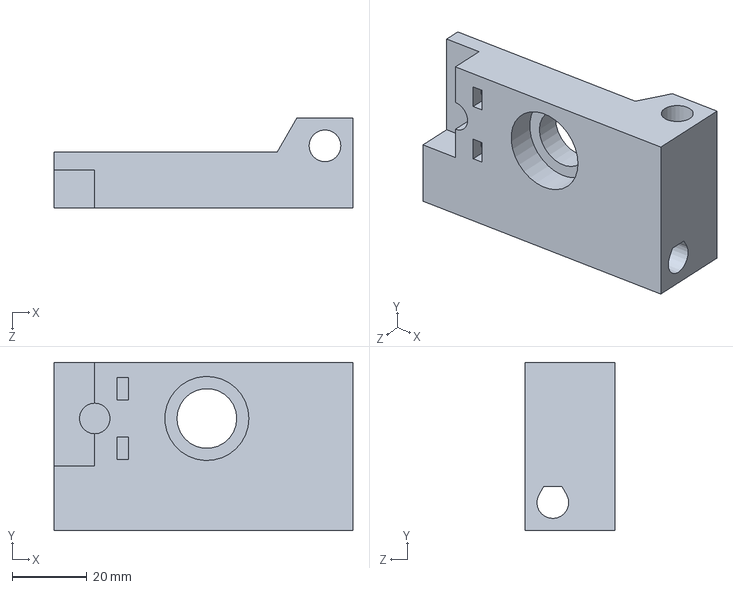
[picture p58: CAD file, 2015-09-09]
Stampante3D conversion/organized/Miscelenea plastic parts/Middle_clamp-Right.SLDPRT
80.0 x 45.0 x 24.2 mm
