wifasoi/PrusaMendel/Stampante3D conversion/organized/X axis/Common/X-common.SLDPRT

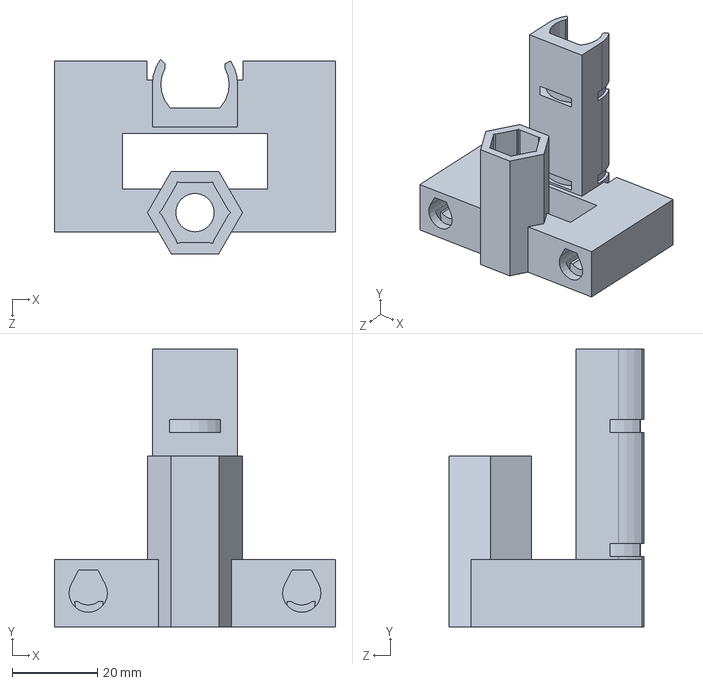
[picture p59: CAD file, 2015-07-25]
Stampante3D conversion/organized/X axis/Common/X-common.SLDPRT
65.8 x 65.0 x 45.6 mm
