wifasoi/PrusaMendel/Stampante3D conversion/organized/X axis/Common/x-lm8uu-clamp/x-lm8uu-clamp.SLDPRT

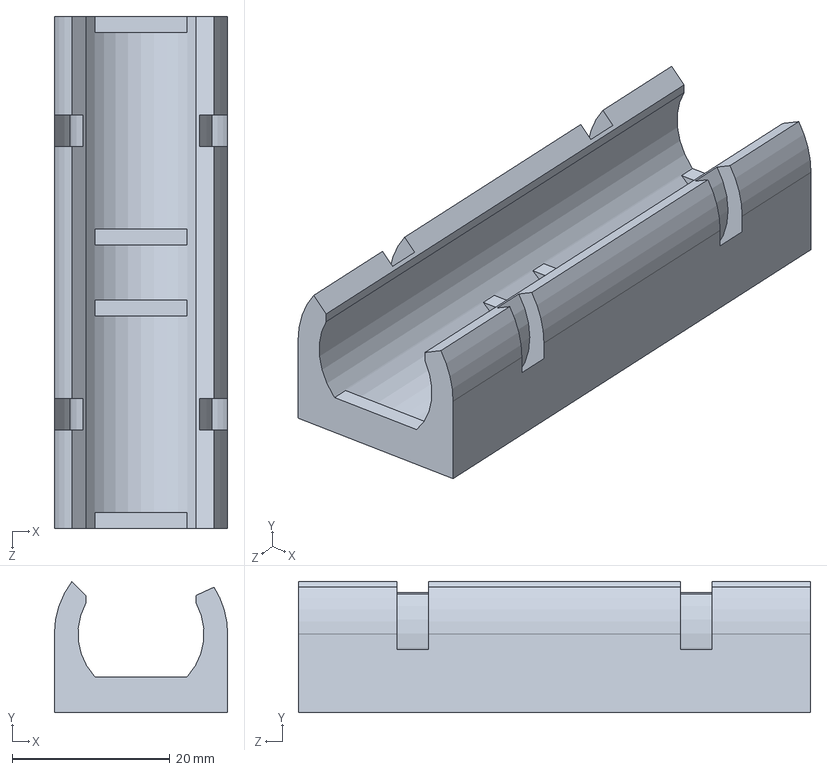
[picture p60: CAD file, 2015-09-06]
Stampante3D conversion/organized/X axis/Common/x-lm8uu-clamp/x-lm8uu-clamp.SLDPRT
22.0 x 16.6 x 65.0 mm
