wifasoi/PrusaMendel/Stampante3D conversion/organized/X axis/X-idle.SLDPRT

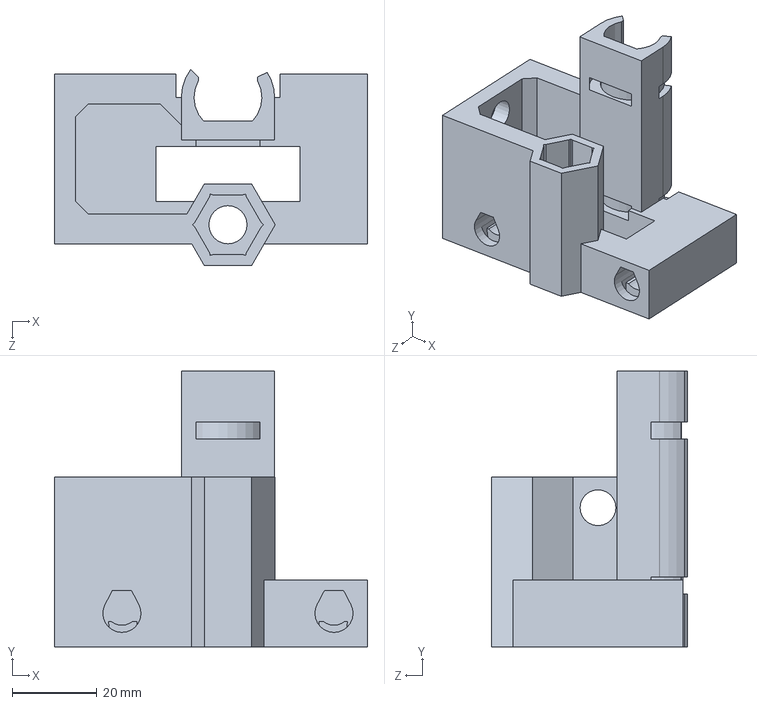
[picture p61: CAD file, 2015-09-09]
Stampante3D conversion/organized/X axis/X-idle.SLDPRT
73.8 x 65.0 x 46.3 mm
