wifasoi/PrusaMendel/Stampante3D conversion/organized/Y axis/Belt mount/Belt tensioner/Belt_tensioner-Slider-Top.SLDPRT

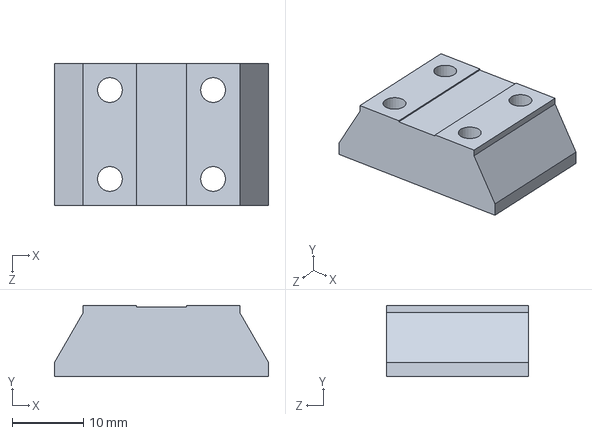
[picture p62: CAD file, 2015-09-05]
Stampante3D conversion/organized/Y axis/Belt mount/Belt tensioner/Belt_tensioner-Slider-Top.SLDPRT
30.1 x 10.0 x 20.0 mm
