wifasoi/PrusaMendel/Stampante3D conversion/organized/Y axis/Belt mount/Belt_mount-tensioner.SLDPRT

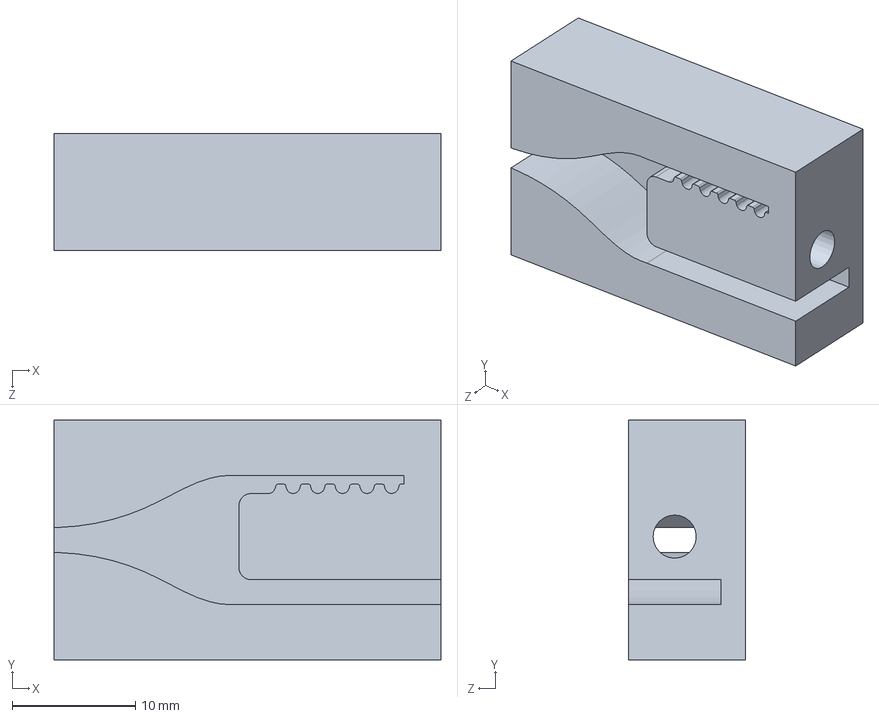
[picture p63: CAD file, 2015-09-02]
Stampante3D conversion/organized/Y axis/Belt mount/Belt_mount-tensioner.SLDPRT
31.4 x 19.4 x 9.50 mm
