wifasoi/PrusaMendel/Stampante3D conversion/organized/Y axis/Y-Motor-clamp.SLDPRT

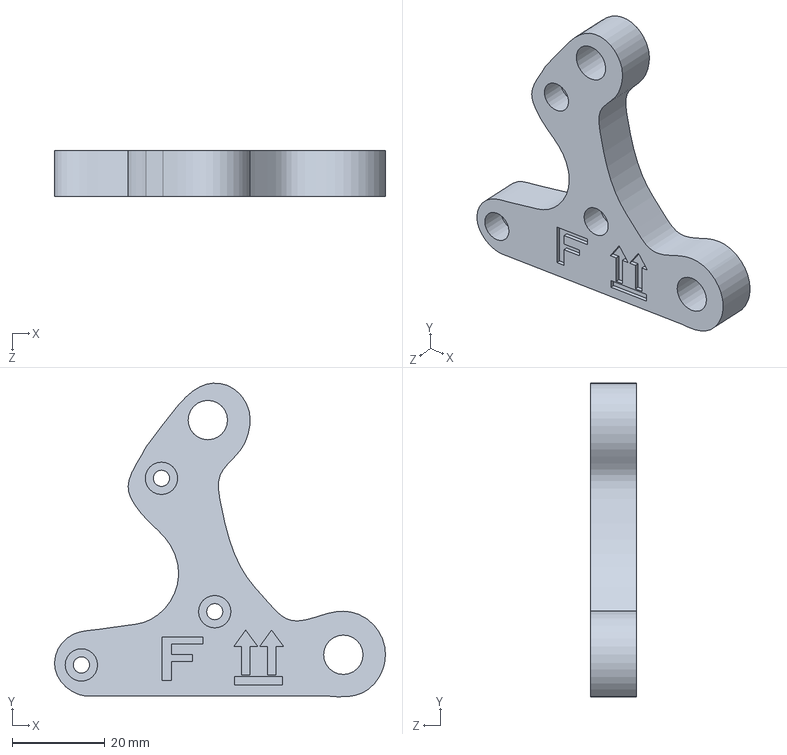
[picture p64: CAD file, 2015-09-13]
Stampante3D conversion/organized/Y axis/Y-Motor-clamp.SLDPRT
71.5 x 67.7 x 10.0 mm
