wifasoi/PrusaMendel/Stampante3D conversion/organized/Z axis/Z-bar-clamp.SLDPRT

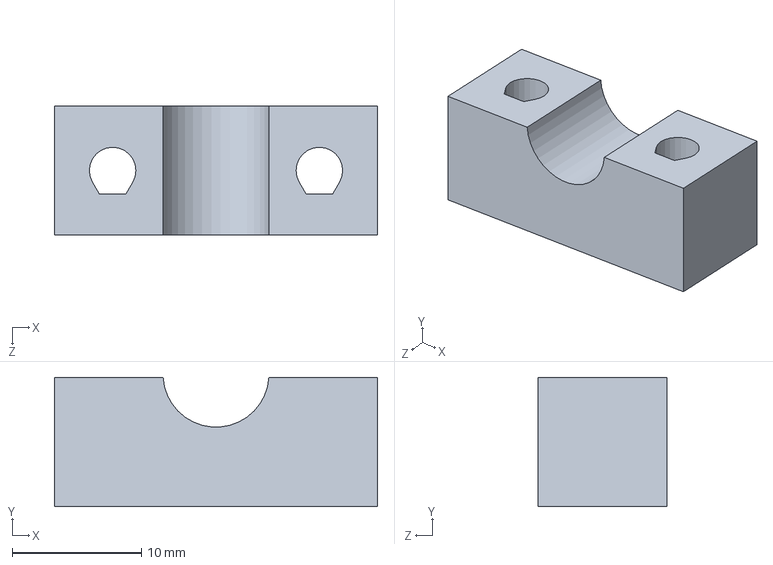
[picture p65: CAD file, 2015-09-09]
Stampante3D conversion/organized/Z axis/Z-bar-clamp.SLDPRT
25.0 x 10.0 x 10.0 mm
