wifasoi/PrusaMendel/metric-prusa-lm8uu/mendel-plate-4.stl

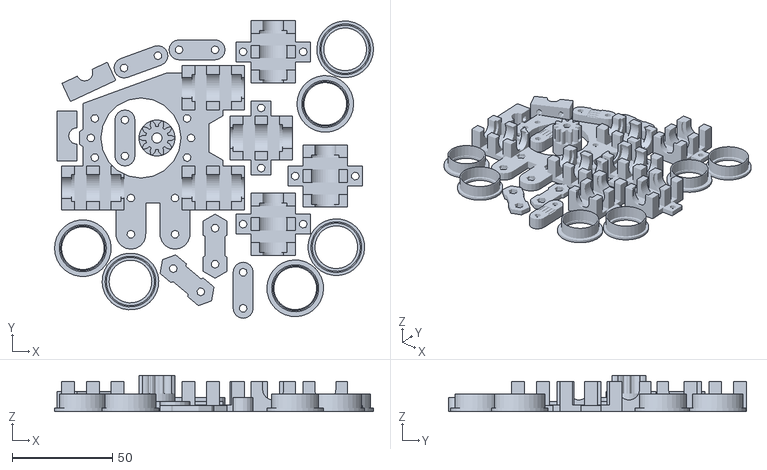
[picture p66: CAD file, 2011-11-21]
metric-prusa-lm8uu/mendel-plate-4.stl
159.2 x 148.6 x 18.0
