wifasoi/PrusaMendel/metric-prusa/mendel-plate-2.stl

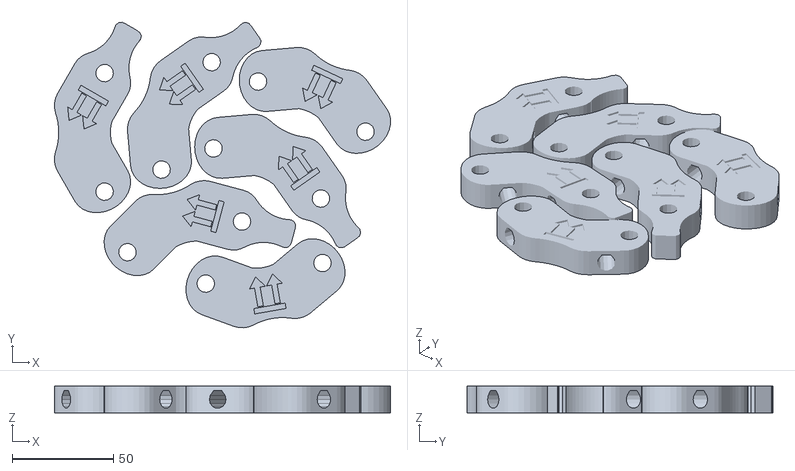
[picture p67: CAD file, 2011-11-21]
metric-prusa/mendel-plate-2.stl
165.8 x 150.8 x 13.2
