wifasoi/PrusaMendel/SolidWorks/bearing-guide.SLDPRT

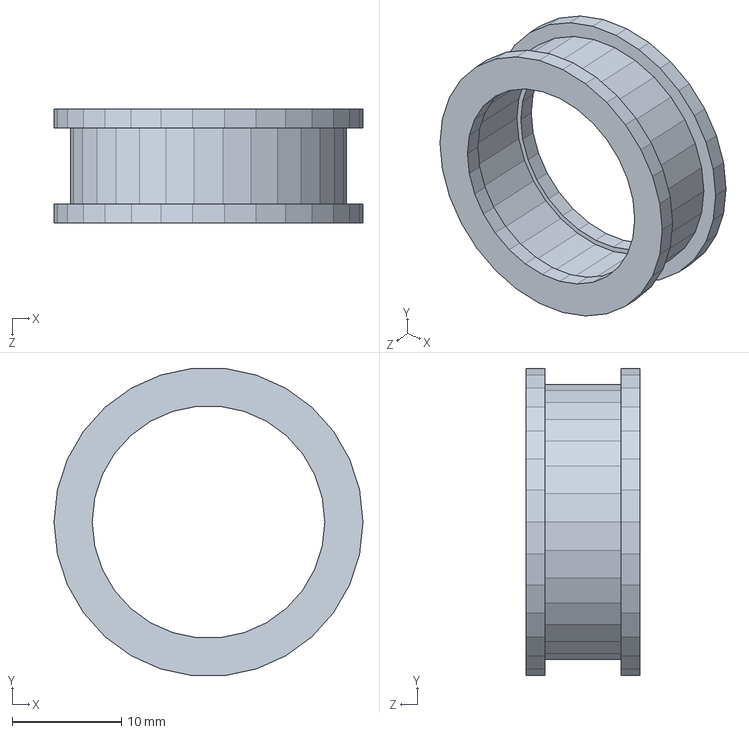
[picture p68: CAD file, 2015-07-08]
SolidWorks/bearing-guide.SLDPRT
28.3 x 28.1 x 10.4 mm
