wifasoi/PrusaMendel/SolidWorks/Imported/x-end-motor lm8uu.stl.SLDPRT

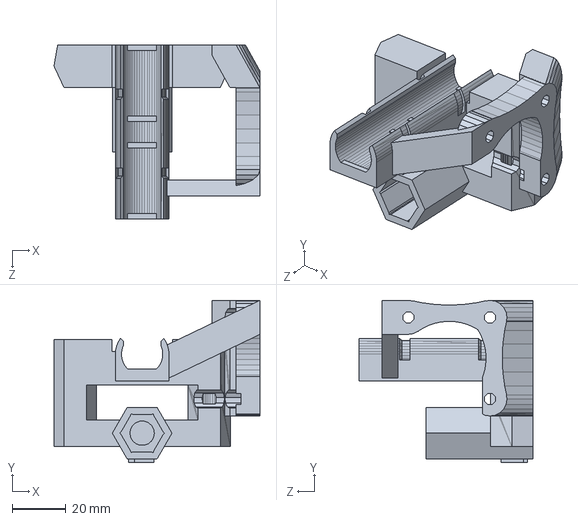
[picture p69: CAD file, 2012-01-01]
SolidWorks/Imported/x-end-motor lm8uu.stl.SLDPRT
76.9 x 60.6 x 65.0 mm
