wifasoi/PrusaMendel/SolidWorks/Vitamins/Belt, Y Axis, T5.SLDPRT

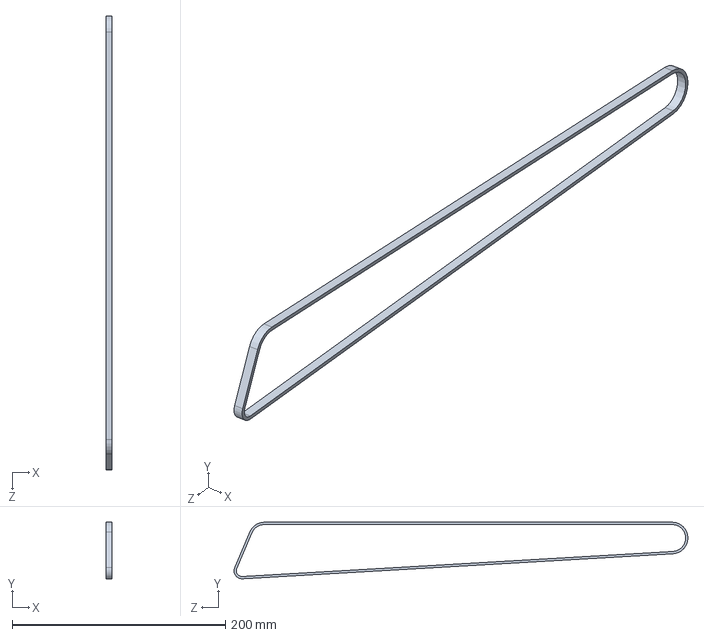
[picture p70: CAD file, 2015-07-08]
SolidWorks/Vitamins/Belt, Y Axis, T5.SLDPRT
6.00 x 53.1 x 425.5 mm
