wifasoi/PrusaMendel/Stampante3D conversion/Export/Steps/Belt_mount-Top.STEP

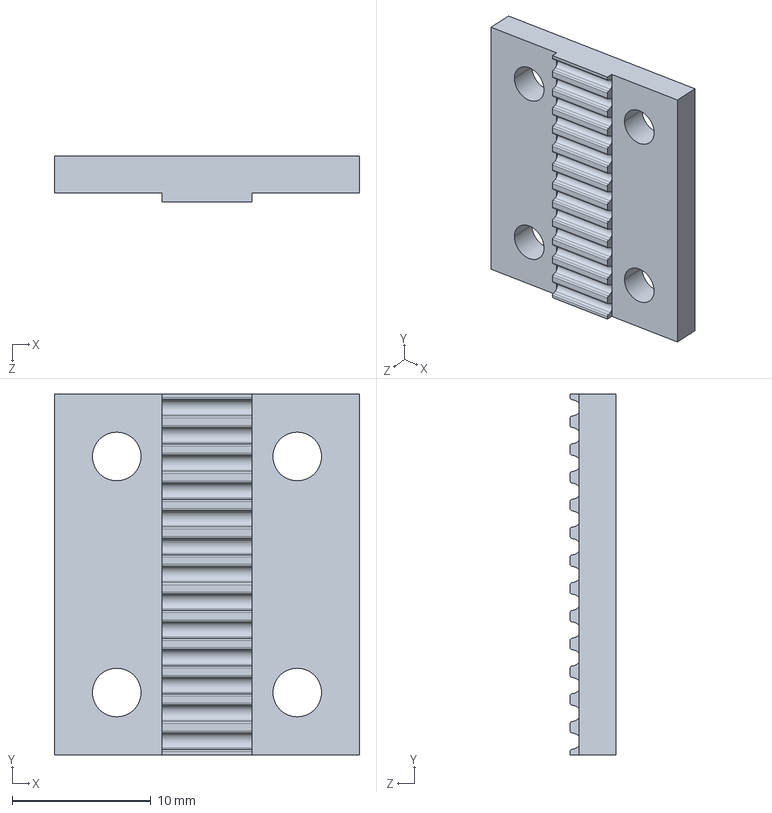
[picture p71: CAD file, 2016-06-02]
Stampante3D conversion/Export/Steps/Belt_mount-Top.STEP
22.0 x 26.0 x 3.30 mm
