wifasoi/PrusaMendel/Stampante3D conversion/organized/Extruder/Cold-end-Tensioner.SLDPRT

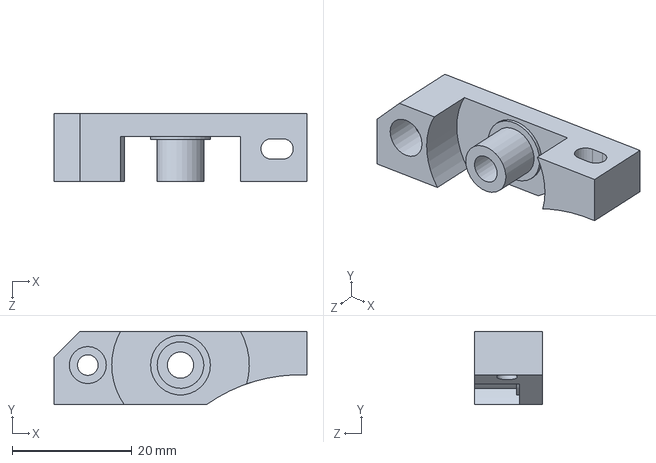
[picture p72: CAD file, 2015-09-14]
Stampante3D conversion/organized/Extruder/Cold-end-Tensioner.SLDPRT
42.3 x 12.3 x 11.3 mm
