wifasoi/PrusaMendel/Stampante3D conversion/organized/Miscelenea parts/microswitch/MicroSwitchBody.SLDPRT

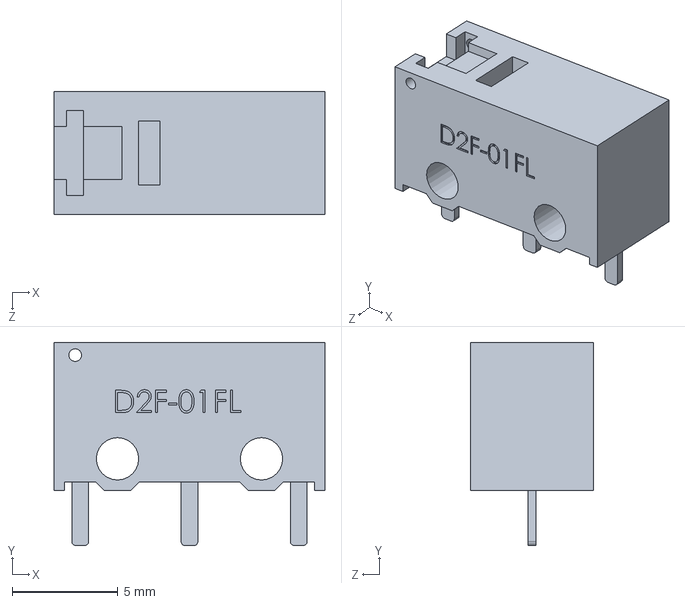
[picture p73: CAD file, 2015-07-27]
Stampante3D conversion/organized/Miscelenea parts/microswitch/MicroSwitchBody.SLDPRT
12.8 x 9.60 x 5.80 mm
