wifasoi/PrusaMendel/Stampante3D conversion/organized/Miscelenea parts/smooth rod, Y axis.sldprt

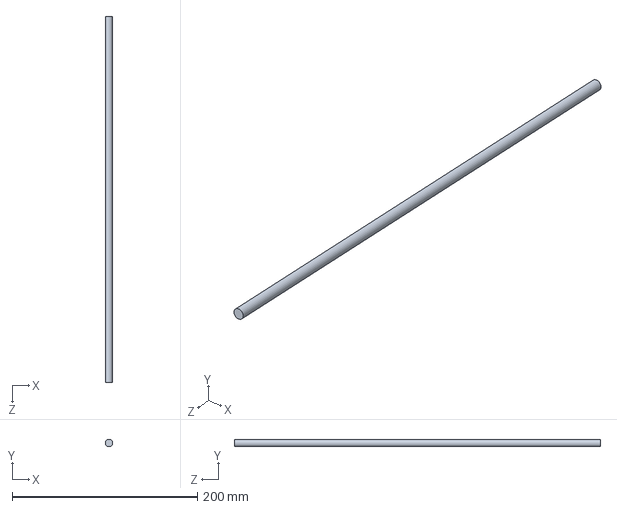
[picture p74: CAD file, 2015-09-10]
Stampante3D conversion/organized/Miscelenea parts/smooth rod, Y axis.sldprt
8.00 x 8.00 x 395.0 mm
