wifasoi/PrusaMendel/Stampante3D conversion/organized/Miscelenea plastic parts/Bearing cover.SLDPRT

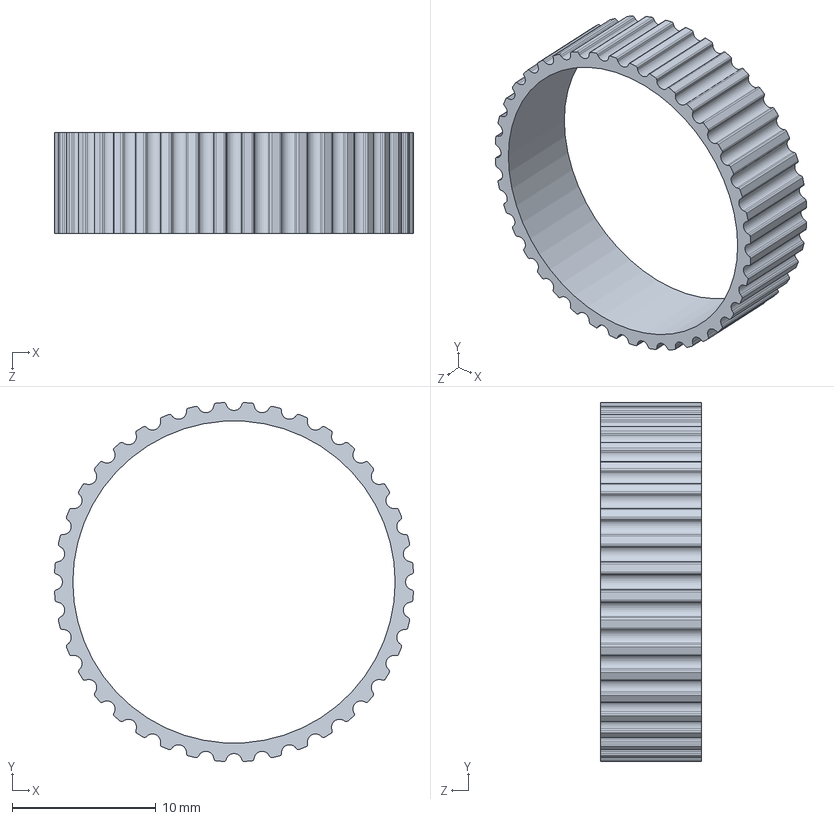
[picture p75: CAD file, 2015-09-09]
Stampante3D conversion/organized/Miscelenea plastic parts/Bearing cover.SLDPRT
24.9 x 24.9 x 7.00 mm
