wifasoi/PrusaMendel/Stampante3D conversion/organized/Miscelenea plastic parts/Coupling/Coupling-hex_recess.SLDPRT

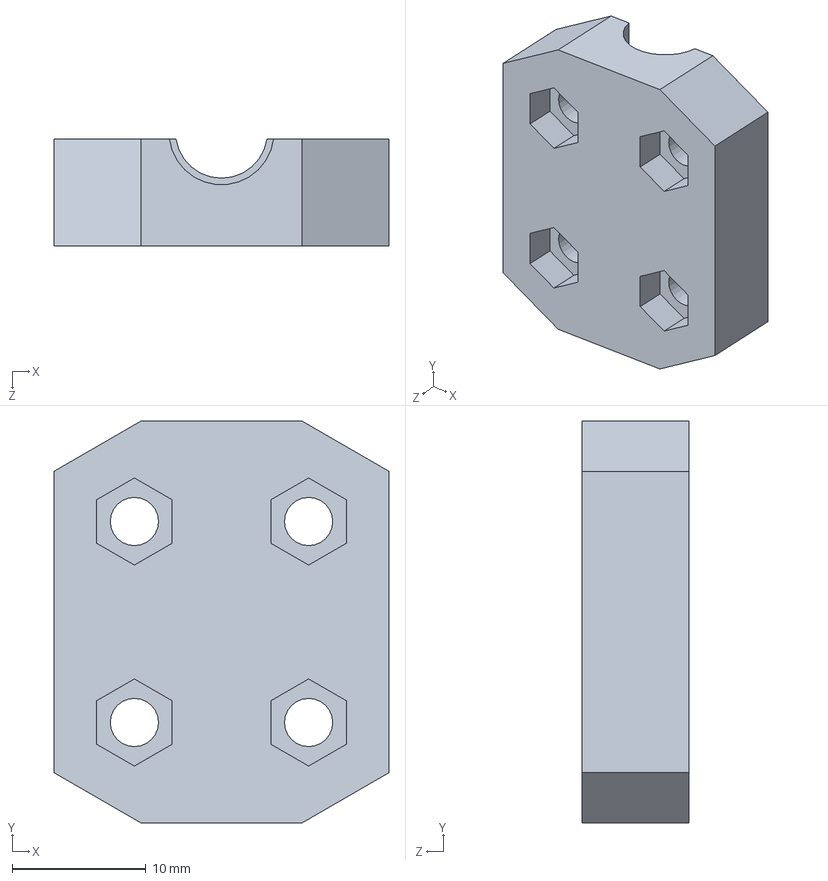
[picture p76: CAD file, 2015-07-25]
Stampante3D conversion/organized/Miscelenea plastic parts/Coupling/Coupling-hex_recess.SLDPRT
25.0 x 30.0 x 8.00 mm
