wifasoi/PrusaMendel/Stampante3D conversion/organized/mittelab.dxf

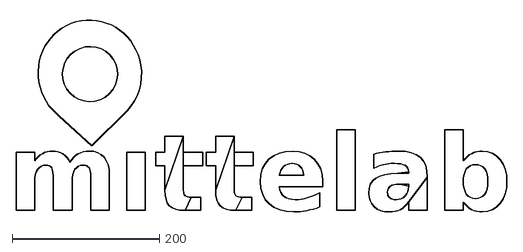
[picture p77: CAD file, 2015-09-05]
Stampante3D conversion/organized/mittelab.dxf
666.6 x 266.1
