wifasoi/PrusaMendel/Stampante3D conversion/organized/X axis/Common/X-hex-shaft.SLDPRT

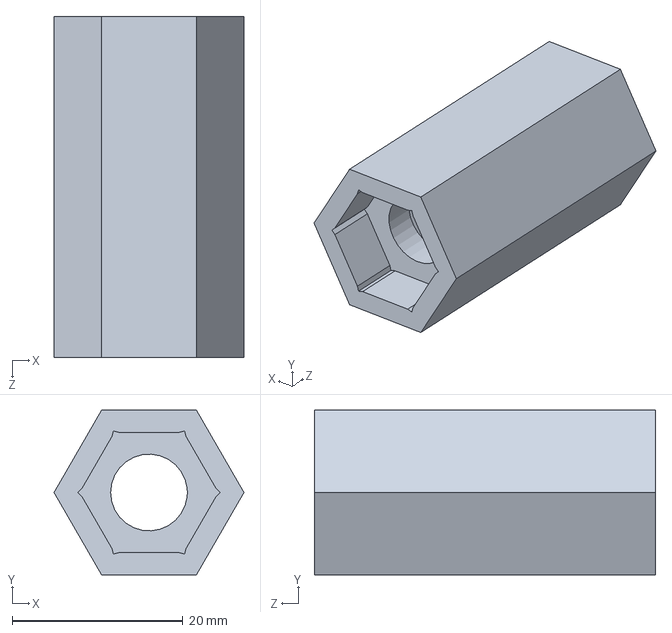
[picture p78: CAD file, 2015-07-13]
Stampante3D conversion/organized/X axis/Common/X-hex-shaft.SLDPRT
22.3 x 19.3 x 40.0 mm
