wifasoi/PrusaMendel/Stampante3D conversion/organized/X axis/Common/x-lm8uu-clamp/ziptie-ring.SLDPRT

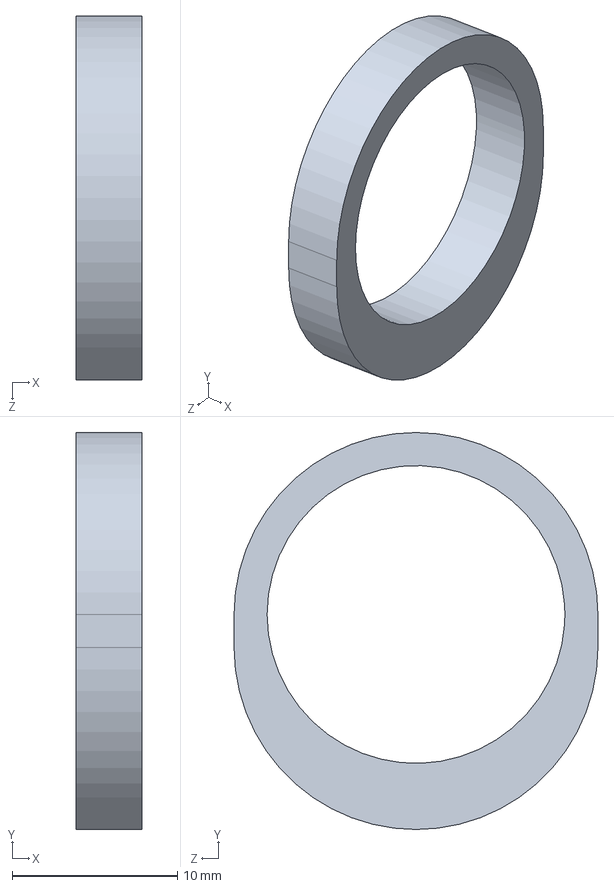
[picture p79: CAD file, 2015-08-06]
Stampante3D conversion/organized/X axis/Common/x-lm8uu-clamp/ziptie-ring.SLDPRT
4.00 x 24.0 x 22.0 mm
