wifasoi/PrusaMendel/Stampante3D conversion/organized/X axis/X-carriage/X-head_carriage.SLDPRT

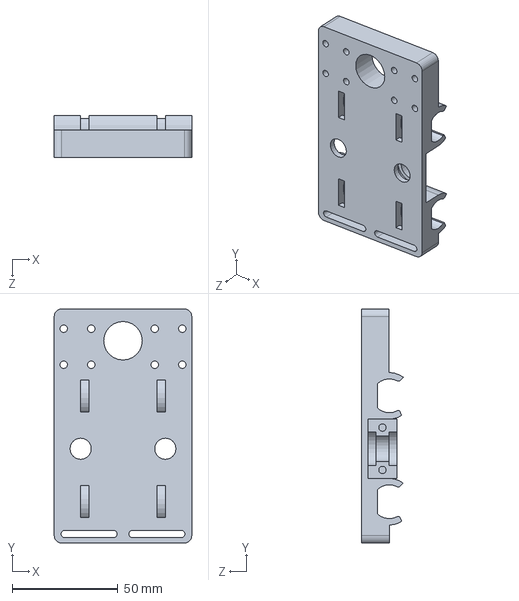
[picture p80: CAD file, 2016-06-02]
Stampante3D conversion/organized/X axis/X-carriage/X-head_carriage.SLDPRT
65.0 x 110.5 x 19.6 mm
