wifasoi/PrusaMendel/Stampante3D conversion/organized/X axis/X-motor.SLDPRT

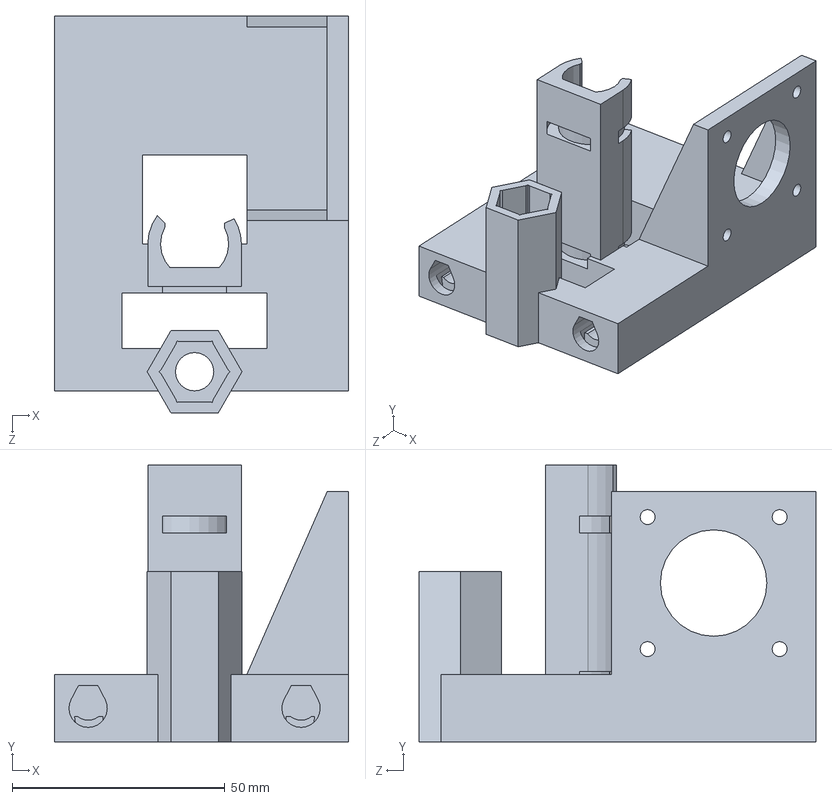
[picture p81: CAD file, 2015-09-09]
Stampante3D conversion/organized/X axis/X-motor.SLDPRT
69.0 x 65.0 x 93.1 mm
