wifasoi/PrusaMendel/Stampante3D conversion/organized/Y axis/lm8uu-mount.SLDPRT

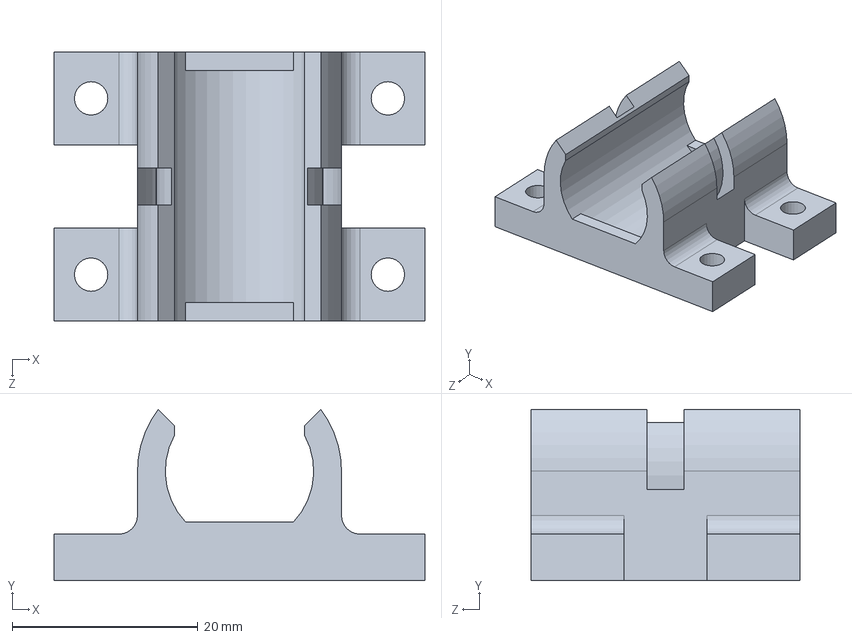
[picture p82: CAD file, 2015-08-06]
Stampante3D conversion/organized/Y axis/lm8uu-mount.SLDPRT
40.0 x 18.4 x 29.0 mm
