wifasoi/PrusaMendel/Stampante3D conversion/organized/Z axis/Z-Motor-clamp.SLDPRT

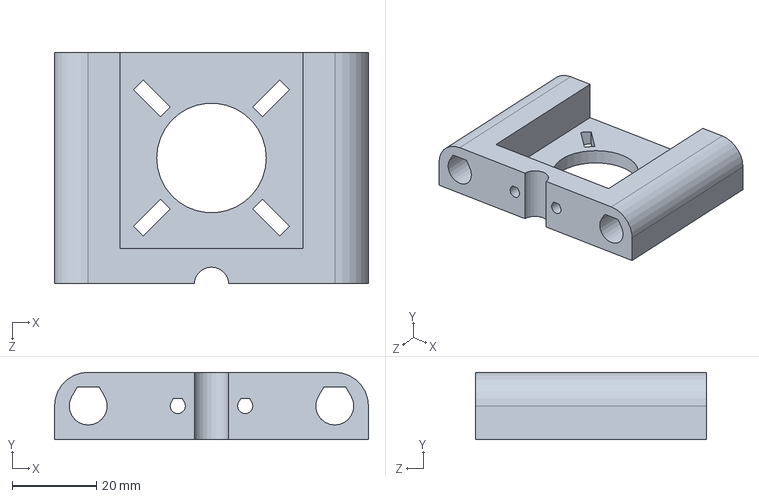
[picture p83: CAD file, 2015-09-09]
Stampante3D conversion/organized/Z axis/Z-Motor-clamp.SLDPRT
74.5 x 16.0 x 54.8 mm
