wifasoi/PrusaMendel/metric-prusa-lm8uu/bearing-guide.stl

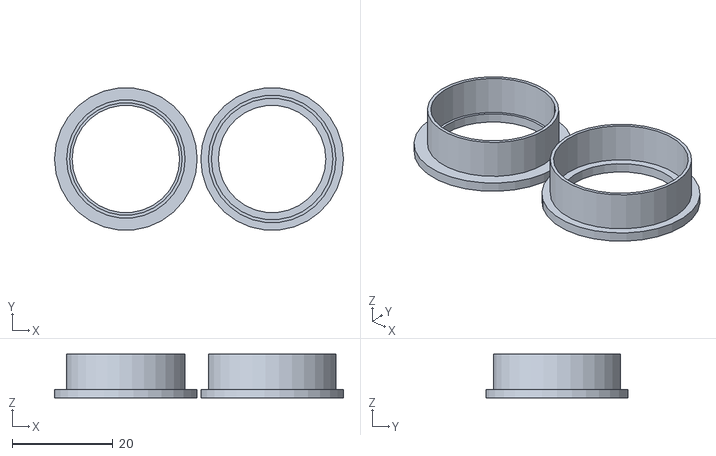
[picture p84: CAD file, 2011-11-21]
metric-prusa-lm8uu/bearing-guide.stl
57.3 x 28.1 x 8.70
