wifasoi/PrusaMendel/metric-prusa/mendel-plate-1.stl

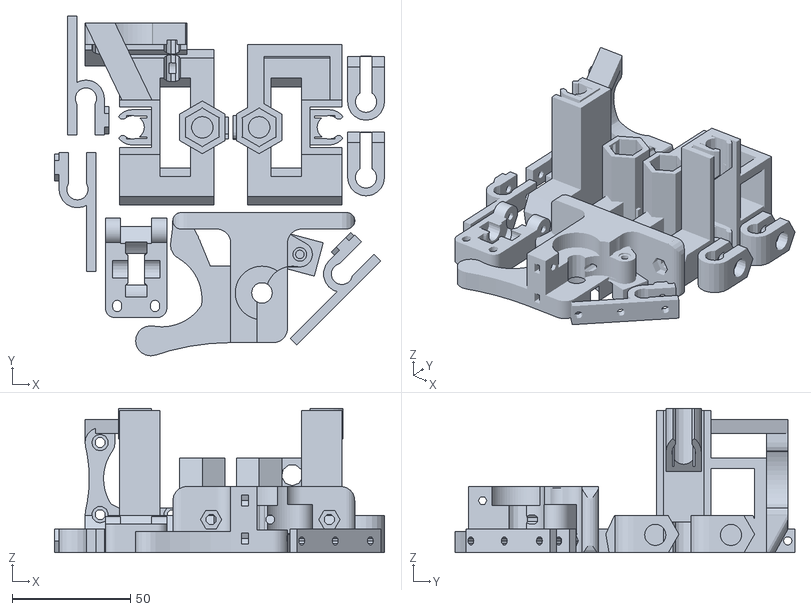
[picture p85: CAD file, 2011-11-21]
metric-prusa/mendel-plate-1.stl
139.5 x 143.6 x 61.0
