wifasoi/PrusaMendel/SolidWorks/Vitamins/stepper motor, NEMA 17.STEP

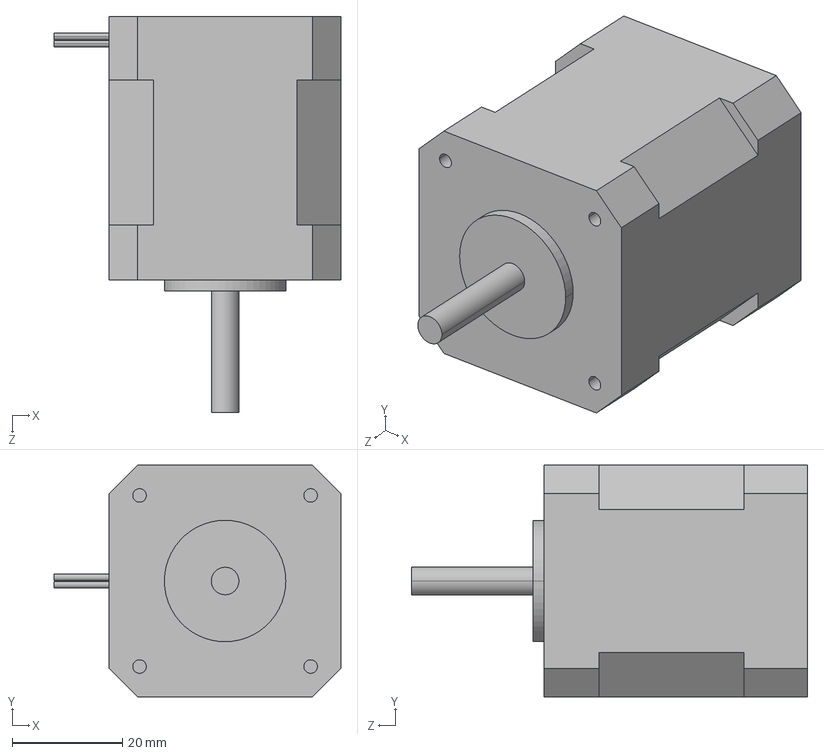
[picture p86: CAD file, 2012-01-01]
SolidWorks/Vitamins/stepper motor, NEMA 17.STEP
52.0 x 42.0 x 71.8 mm
