wifasoi/PrusaMendel/Stampante3D conversion/Export/Steps/X-head_carriage-Hot_end-Clamp.STEP

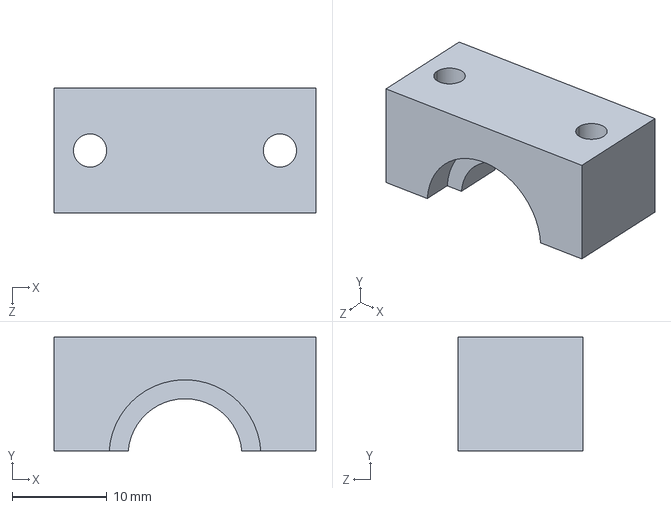
[picture p87: CAD file, 2016-06-02]
Stampante3D conversion/Export/Steps/X-head_carriage-Hot_end-Clamp.STEP
27.6 x 12.0 x 13.2 mm
