wifasoi/PrusaMendel/Stampante3D conversion/organized/Extruder/Cold-end-Base.SLDPRT

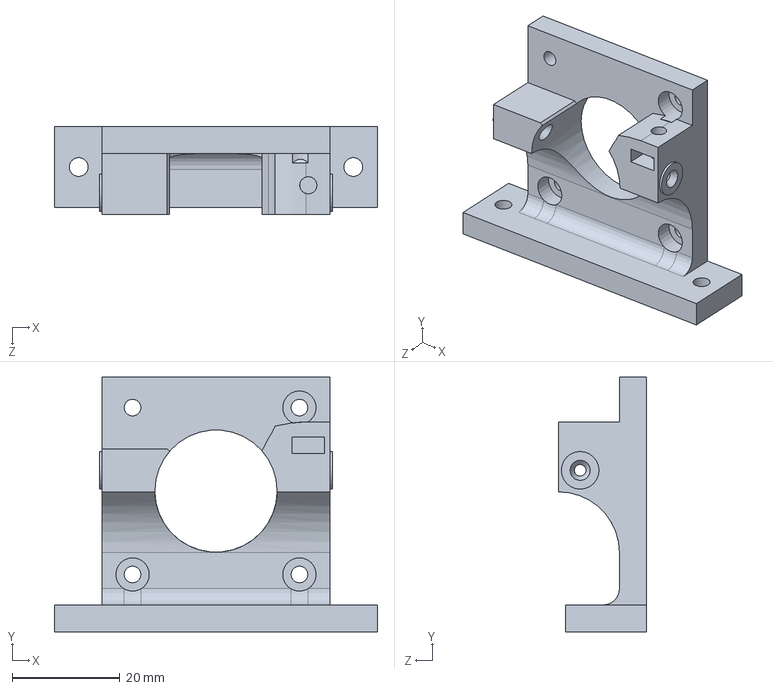
[picture p88: CAD file, 2015-09-14]
Stampante3D conversion/organized/Extruder/Cold-end-Base.SLDPRT
60.0 x 47.3 x 16.3 mm
