wifasoi/PrusaMendel/Stampante3D conversion/organized/Miscelenea parts/microswitch/MicroSwichLever.SLDPRT

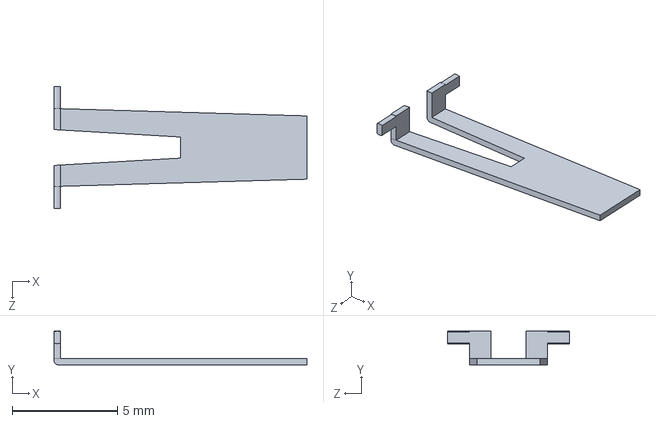
[picture p89: CAD file, 2015-07-27]
Stampante3D conversion/organized/Miscelenea parts/microswitch/MicroSwichLever.SLDPRT
12.0 x 1.60 x 5.80 mm
