wifasoi/PrusaMendel/Stampante3D conversion/organized/Miscelenea plastic parts/wifa_clamp.SLDPRT

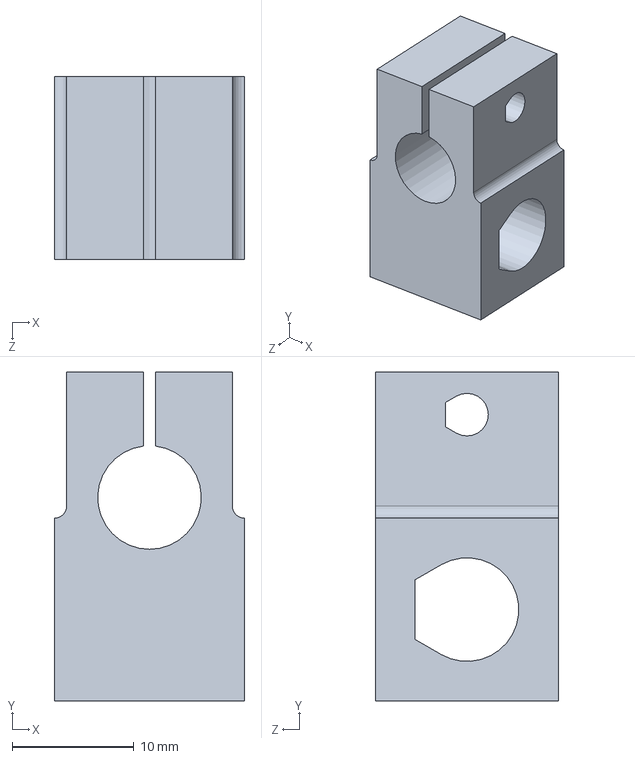
[picture p90: CAD file, 2015-09-09]
Stampante3D conversion/organized/Miscelenea plastic parts/wifa_clamp.SLDPRT
15.6 x 27.0 x 15.0 mm
