wifasoi/PrusaMendel/Stampante3D conversion/organized/X axis/Common/X-rod_mount.SLDPRT

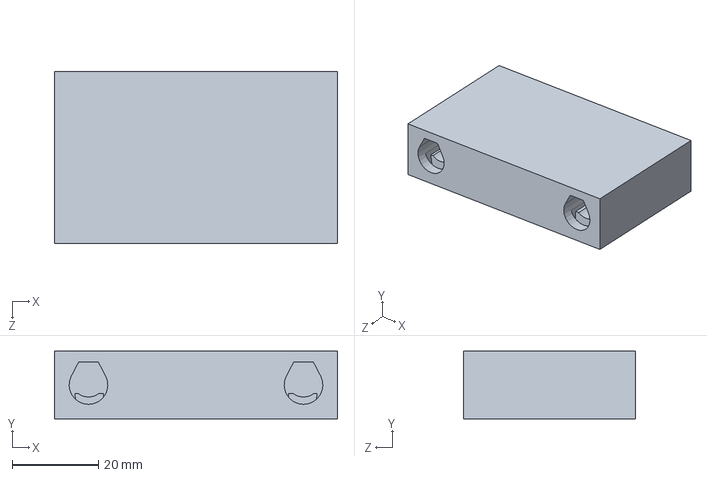
[picture p91: CAD file, 2015-07-13]
Stampante3D conversion/organized/X axis/Common/X-rod_mount.SLDPRT
65.8 x 15.8 x 40.0 mm
