wifasoi/PrusaMendel/Stampante3D conversion/organized/Y axis/Belt mount/Belt mount/Belt_mount-Bottom.SLDPRT

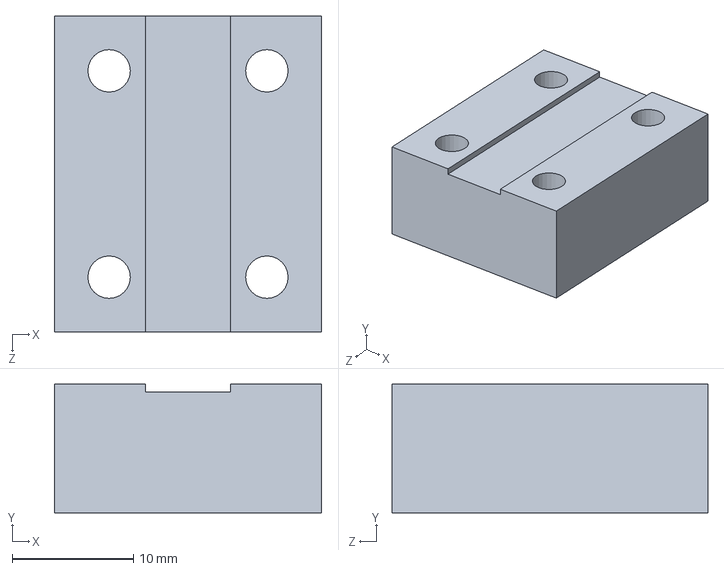
[picture p92: CAD file, 2015-09-02]
Stampante3D conversion/organized/Y axis/Belt mount/Belt mount/Belt_mount-Bottom.SLDPRT
22.0 x 10.6 x 26.0 mm
