wifasoi/PrusaMendel/Stampante3D conversion/organized/Y axis/Belt mount/Belt tensioner/Belt_tensioner-Base.SLDPRT

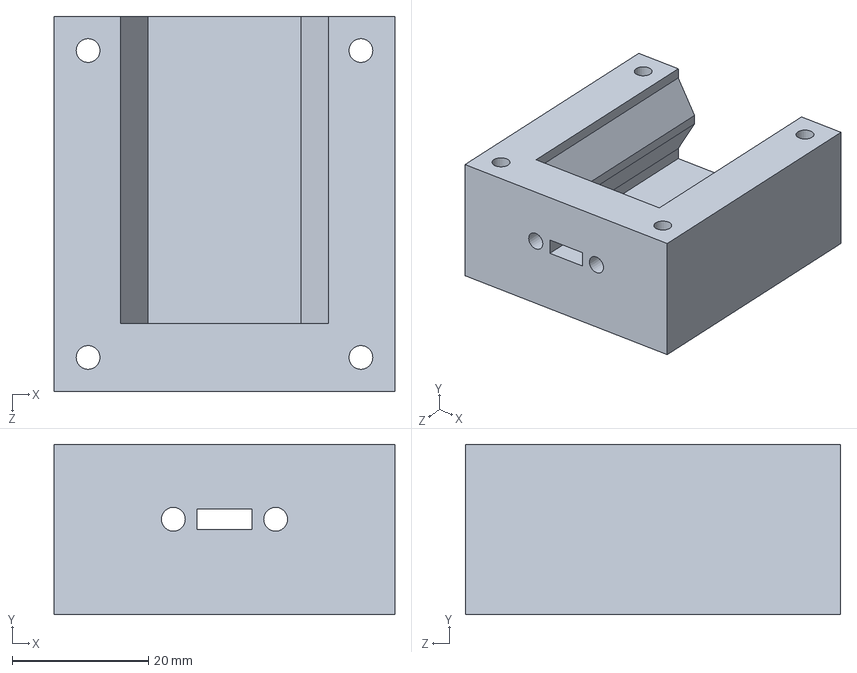
[picture p93: CAD file, 2015-09-02]
Stampante3D conversion/organized/Y axis/Belt mount/Belt tensioner/Belt_tensioner-Base.SLDPRT
50.0 x 25.0 x 55.0 mm
