wifasoi/PrusaMendel/STEP/printable-bushing-lm8uu.stp

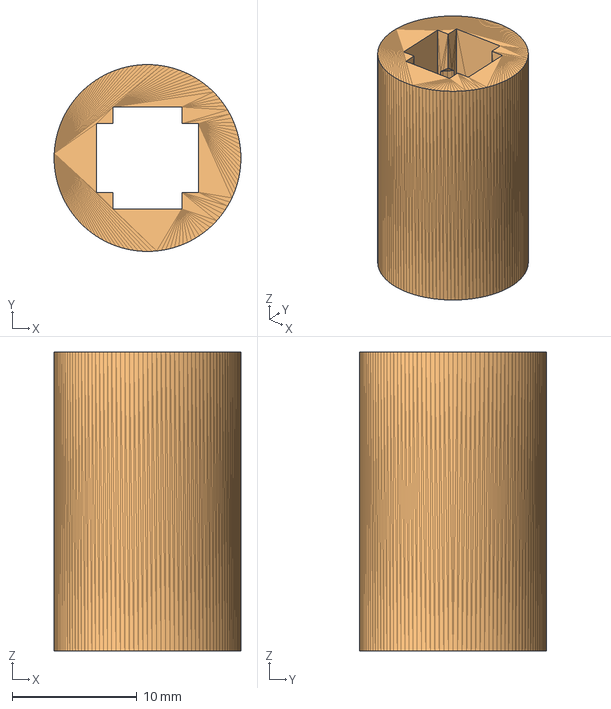
[picture p94: CAD file, 2011-11-22]
STEP/printable-bushing-lm8uu.stp
15.0 x 15.0 x 24.0 mm
