wifasoi/PrusaMendel/metric-prusa-lm8uu/x-carriage.stl

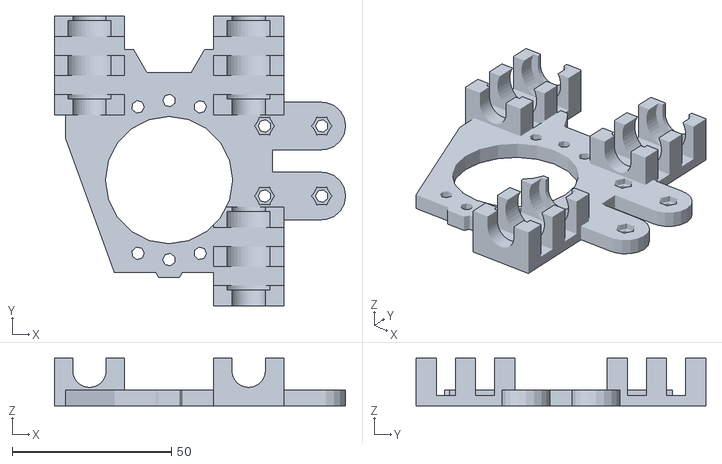
[picture p95: CAD file, 2011-11-21]
metric-prusa-lm8uu/x-carriage.stl
91.6 x 91.1 x 15.0
