wifasoi/PrusaMendel/SolidWorks/Imported/wade frame.stl.SLDPRT

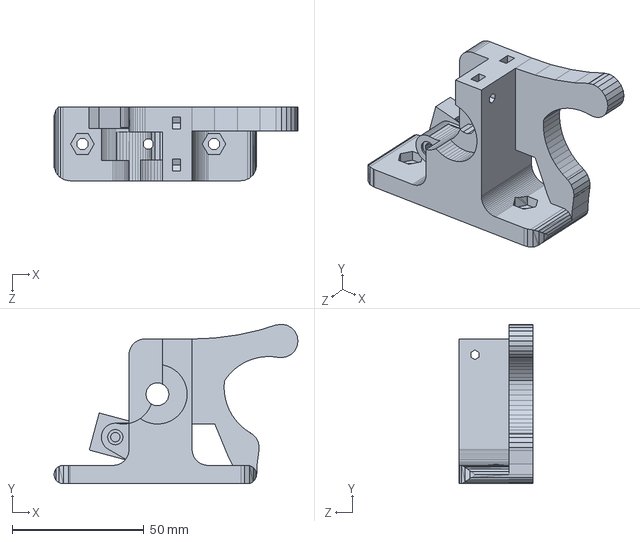
[picture p96: CAD file, 2011-11-22]
SolidWorks/Imported/wade frame.stl.SLDPRT
92.7 x 60.6 x 28.0 mm
