wifasoi/PrusaMendel/SolidWorks/Vitamins/LM8UU.STEP

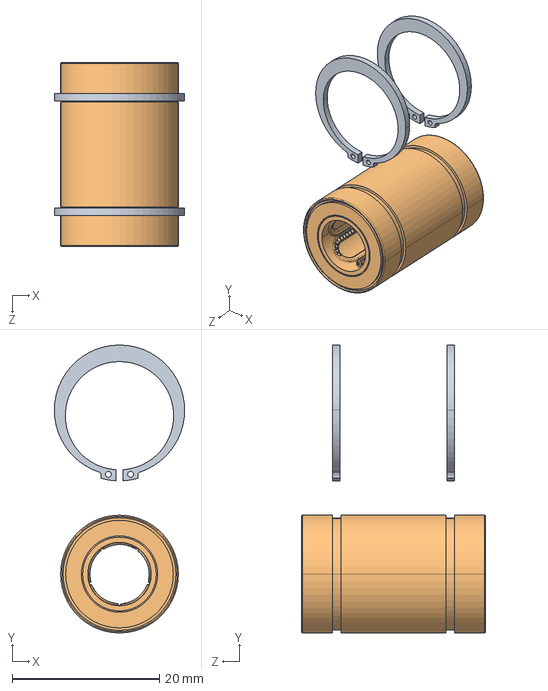
[picture p97: CAD file, 2012-01-01]
SolidWorks/Vitamins/LM8UU.STEP
17.7 x 39.1 x 25.0 mm
