wifasoi/PrusaMendel/Stampante3D conversion/Export/Steps/Z-Motor-clamp.STEP

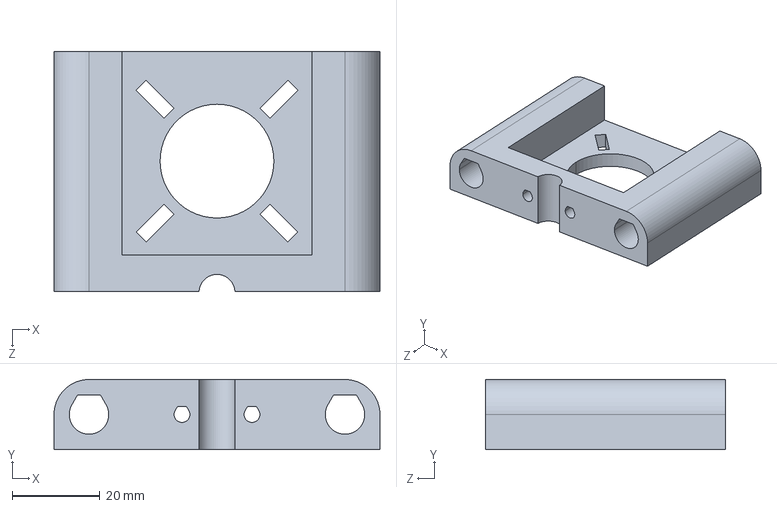
[picture p98: CAD file, 2016-06-02]
Stampante3D conversion/Export/Steps/Z-Motor-clamp.STEP
74.5 x 16.0 x 54.8 mm
