wifasoi/PrusaMendel/Stampante3D conversion/organized/Miscelenea parts/extruder/E3D Heat Block.SLDPRT

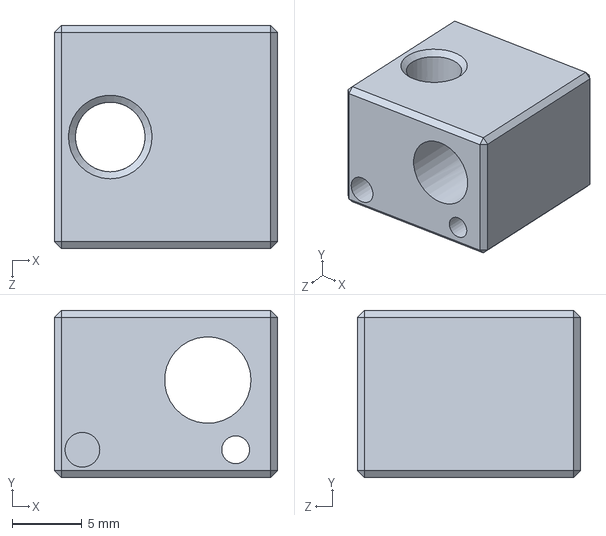
[picture p99: CAD file, 2015-09-02]
Stampante3D conversion/organized/Miscelenea parts/extruder/E3D Heat Block.SLDPRT
16.0 x 12.0 x 16.0 mm
