wifasoi/PrusaMendel/Stampante3D conversion/organized/Miscelenea parts/microswitch/MicroSwichKnob.SLDPRT

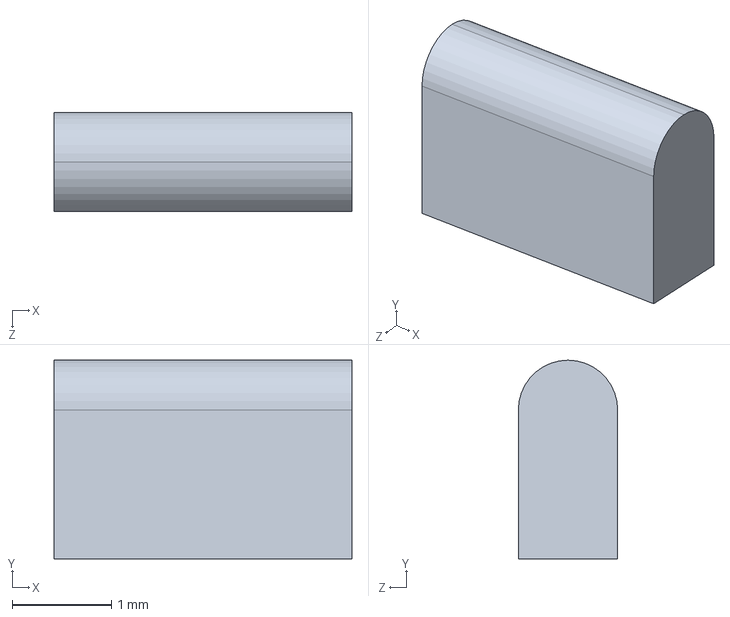
[picture p100: CAD file, 2015-07-27]
Stampante3D conversion/organized/Miscelenea parts/microswitch/MicroSwichKnob.SLDPRT
3.00 x 2.00 x 1.00 mm
