wifasoi/PrusaMendel/Stampante3D conversion/organized/Miscelenea parts/threaded rod, frame horizontal.SLDPRT

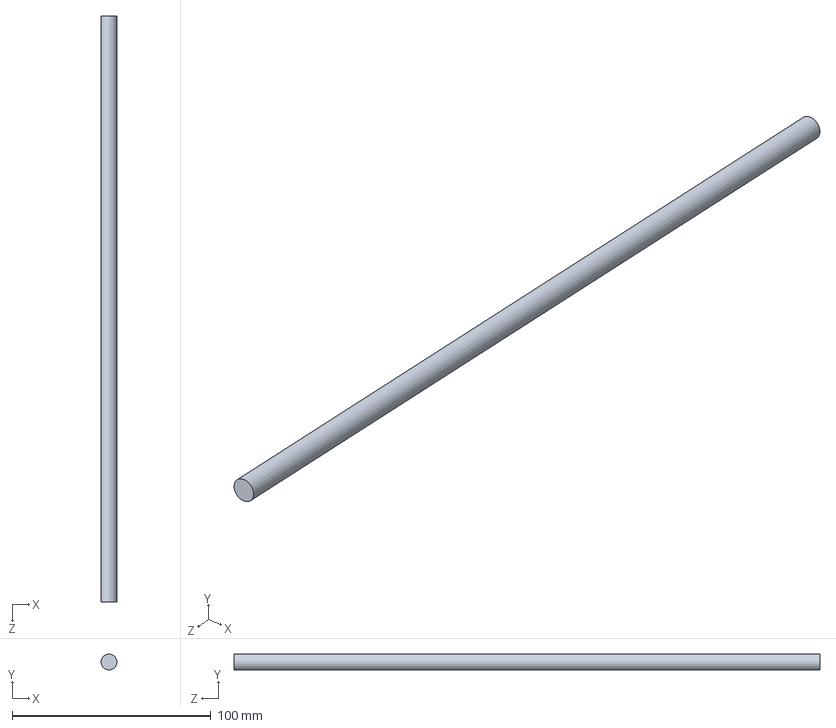
[picture p101: CAD file, 2015-09-10]
Stampante3D conversion/organized/Miscelenea parts/threaded rod, frame horizontal.SLDPRT
8.00 x 8.00 x 295.0 mm
