wifasoi/PrusaMendel/Stampante3D conversion/organized/Y axis/Belt mount/Belt tensioner/Belt_tensioner-Slider-Bot.SLDPRT

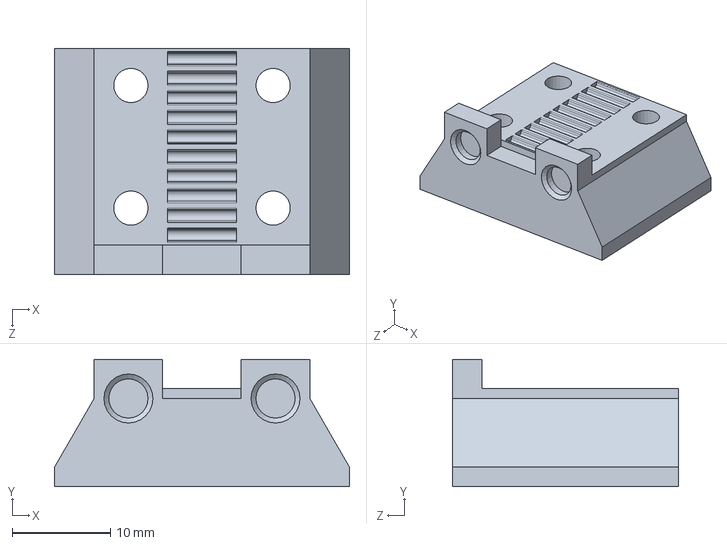
[picture p102: CAD file, 2015-09-02]
Stampante3D conversion/organized/Y axis/Belt mount/Belt tensioner/Belt_tensioner-Slider-Bot.SLDPRT
30.1 x 13.0 x 23.0 mm
