wifasoi/PrusaMendel/metric-prusa-lm8uu/mendel-plate-2.stl

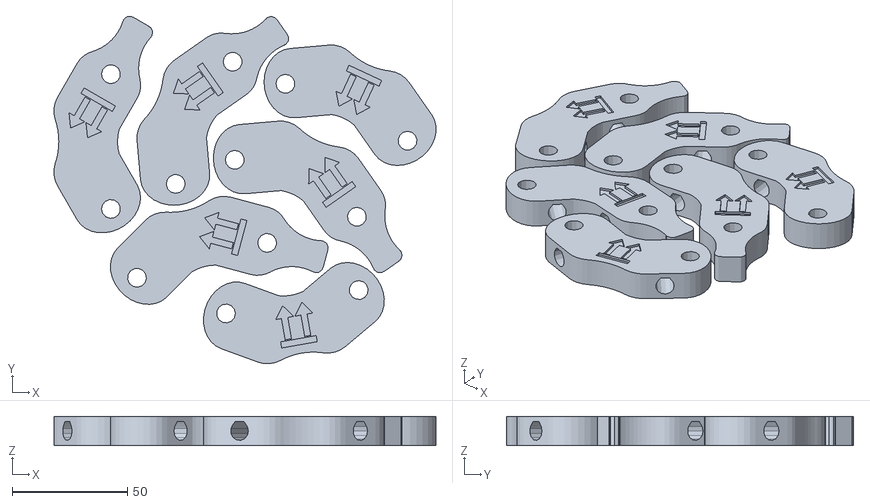
[picture p103: CAD file, 2011-11-21]
metric-prusa-lm8uu/mendel-plate-2.stl
165.8 x 150.8 x 12.7
