wifasoi/PrusaMendel/metric-prusa/belt-clamp.stl

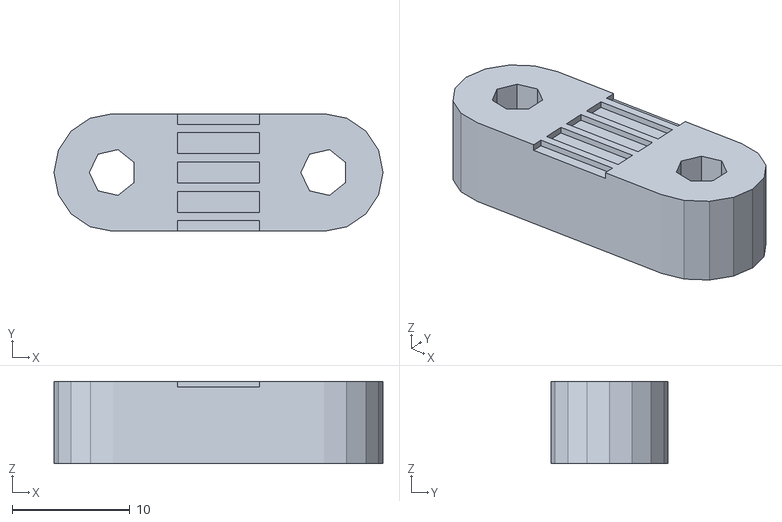
[picture p104: CAD file, 2011-11-21]
metric-prusa/belt-clamp.stl
28.0 x 10.0 x 7.00
