wifasoi/PrusaMendel/SolidWorks/Imported/endstop-holder.stl.SLDPRT

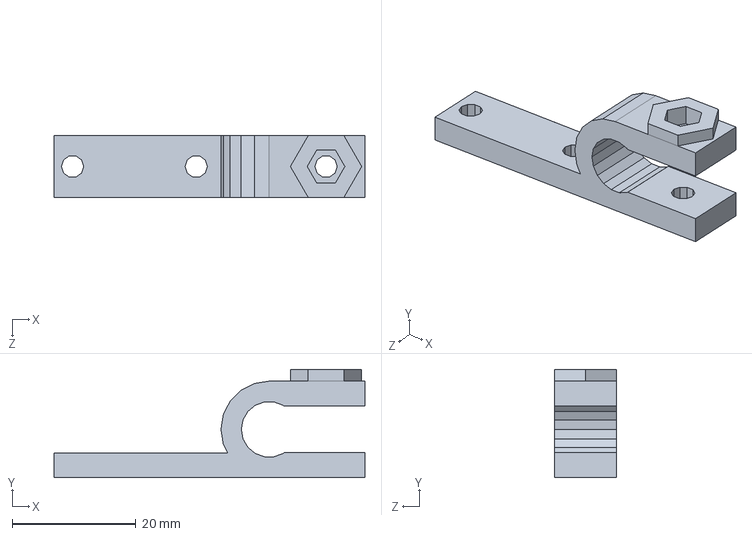
[picture p105: CAD file, 2011-11-22]
SolidWorks/Imported/endstop-holder.stl.SLDPRT
50.3 x 17.5 x 10.0 mm
