wifasoi/PrusaMendel/Stampante3D conversion/organized/Miscelenea parts/smooth rod, X axis.sldprt

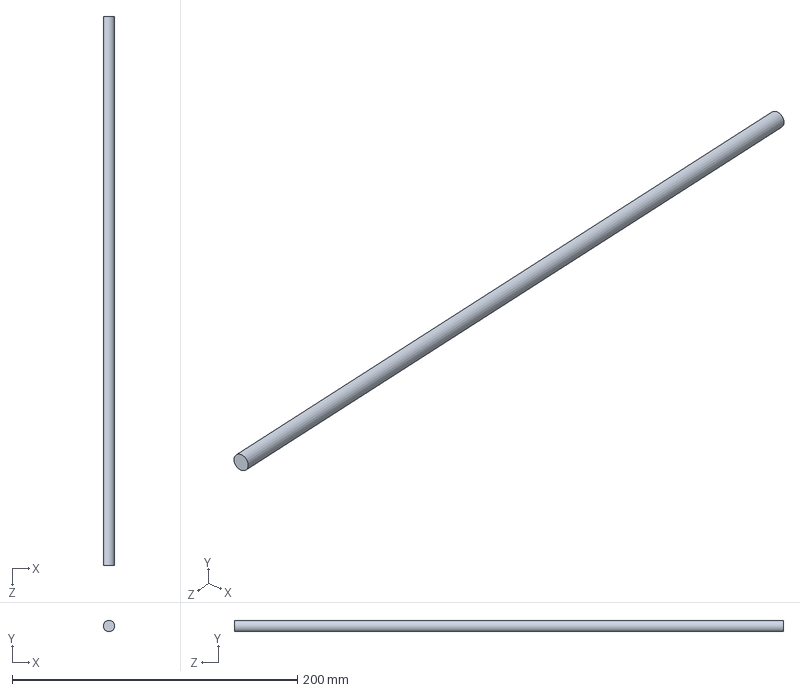
[picture p106: CAD file, 2015-09-10]
Stampante3D conversion/organized/Miscelenea parts/smooth rod, X axis.sldprt
8.00 x 8.00 x 385.0 mm
