wifasoi/PrusaMendel/Stampante3D conversion/organized/Miscelenea plastic parts/Z-axis-Microswitch_holder.SLDPRT

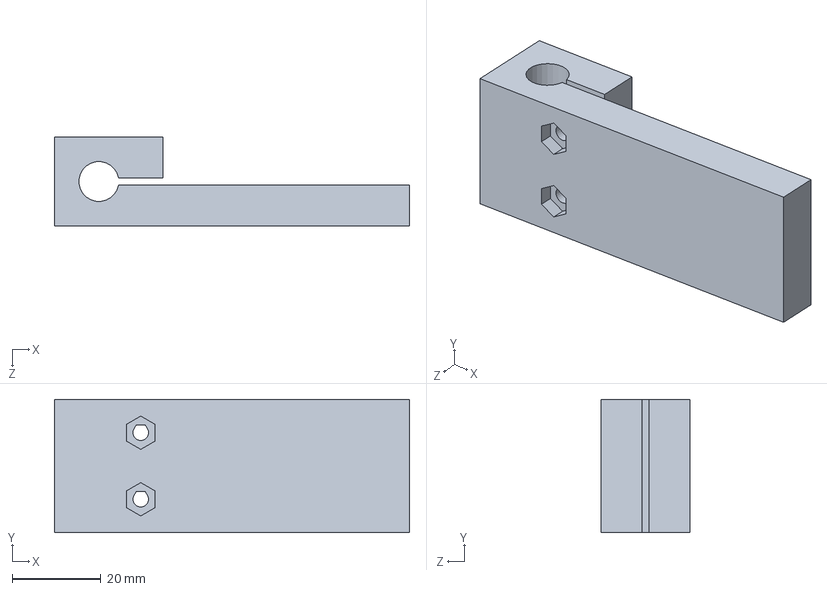
[picture p107: CAD file, 2015-08-07]
Stampante3D conversion/organized/Miscelenea plastic parts/Z-axis-Microswitch_holder.SLDPRT
80.0 x 30.0 x 20.0 mm
