wifasoi/PrusaMendel/metric-prusa/wade-big.stl

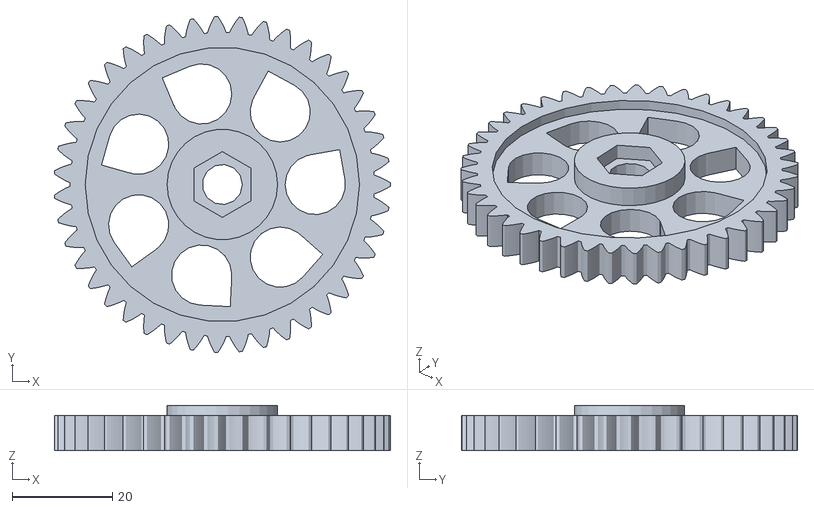
[picture p108: CAD file, 2011-11-21]
metric-prusa/wade-big.stl
66.9 x 67.0 x 9.00
