wifasoi/PrusaMendel/SolidWorks/Imported/coupling.stl.SLDPRT

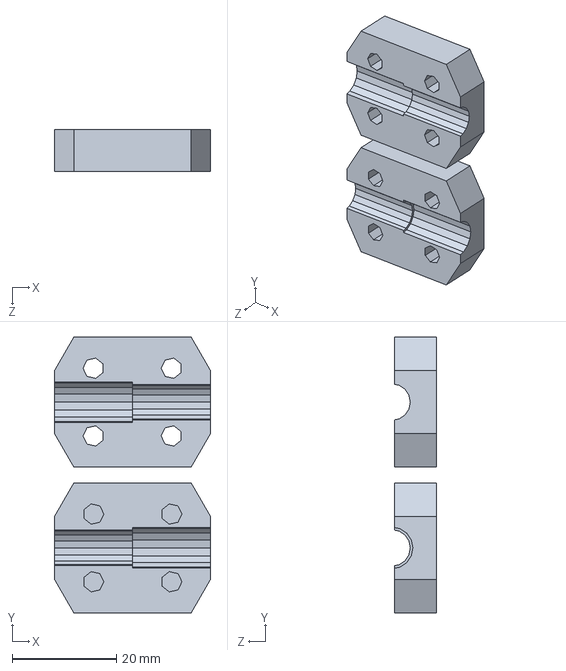
[picture p109: CAD file, 2011-11-22]
SolidWorks/Imported/coupling.stl.SLDPRT
30.0 x 53.0 x 8.00 mm
