wifasoi/PrusaMendel/Stampante3D conversion/organized/Miscelenea parts/extruder/E3D Heatbreak.SLDPRT

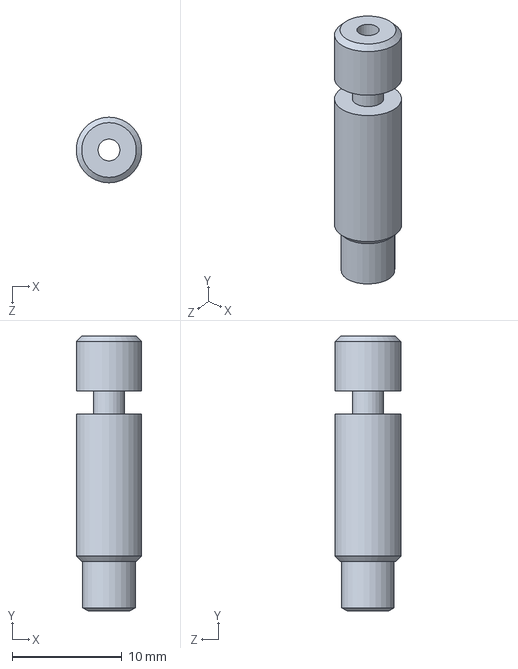
[picture p110: CAD file, 2015-09-02]
Stampante3D conversion/organized/Miscelenea parts/extruder/E3D Heatbreak.SLDPRT
5.97 x 25.1 x 6.00 mm
