wifasoi/PrusaMendel/Stampante3D conversion/organized/Miscelenea parts/smooth rod, Z axis.sldprt

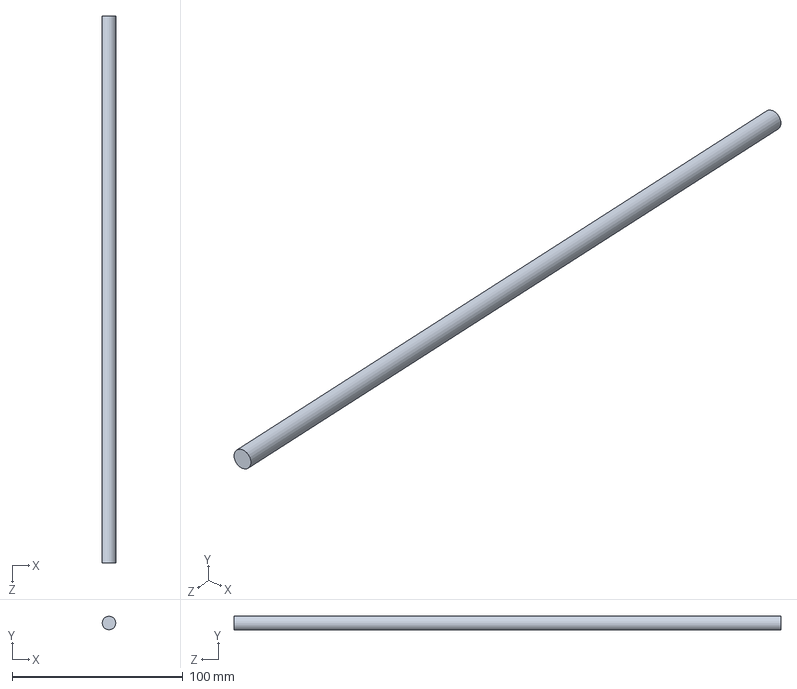
[picture p111: CAD file, 2015-09-10]
Stampante3D conversion/organized/Miscelenea parts/smooth rod, Z axis.sldprt
8.00 x 8.00 x 320.0 mm
