wifasoi/PrusaMendel/Stampante3D conversion/organized/Miscelenea plastic parts/middle_frame_clamp.SLDPRT

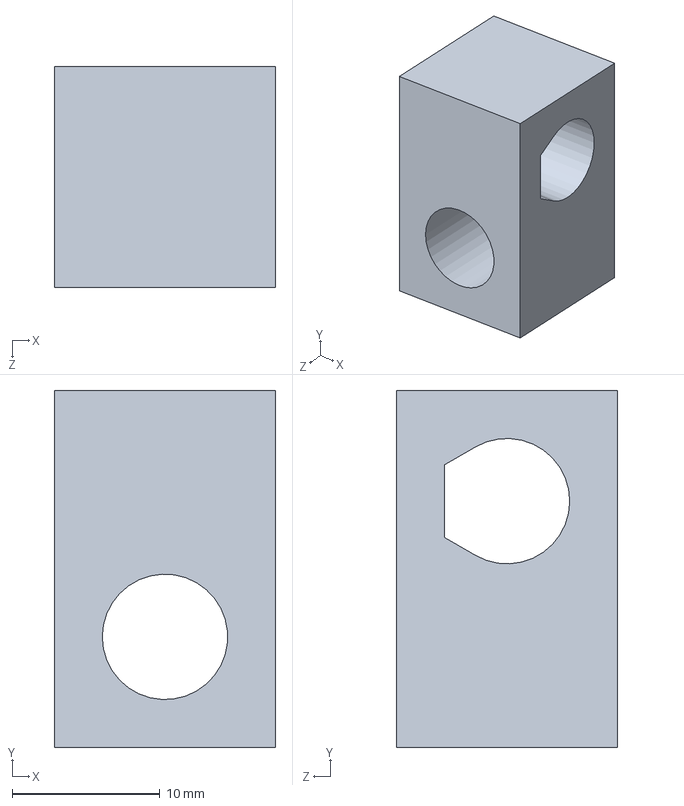
[picture p112: CAD file, 2015-07-27]
Stampante3D conversion/organized/Miscelenea plastic parts/middle_frame_clamp.SLDPRT
15.0 x 24.2 x 15.0 mm
