wifasoi/PrusaMendel/STEP/wade-small.stp

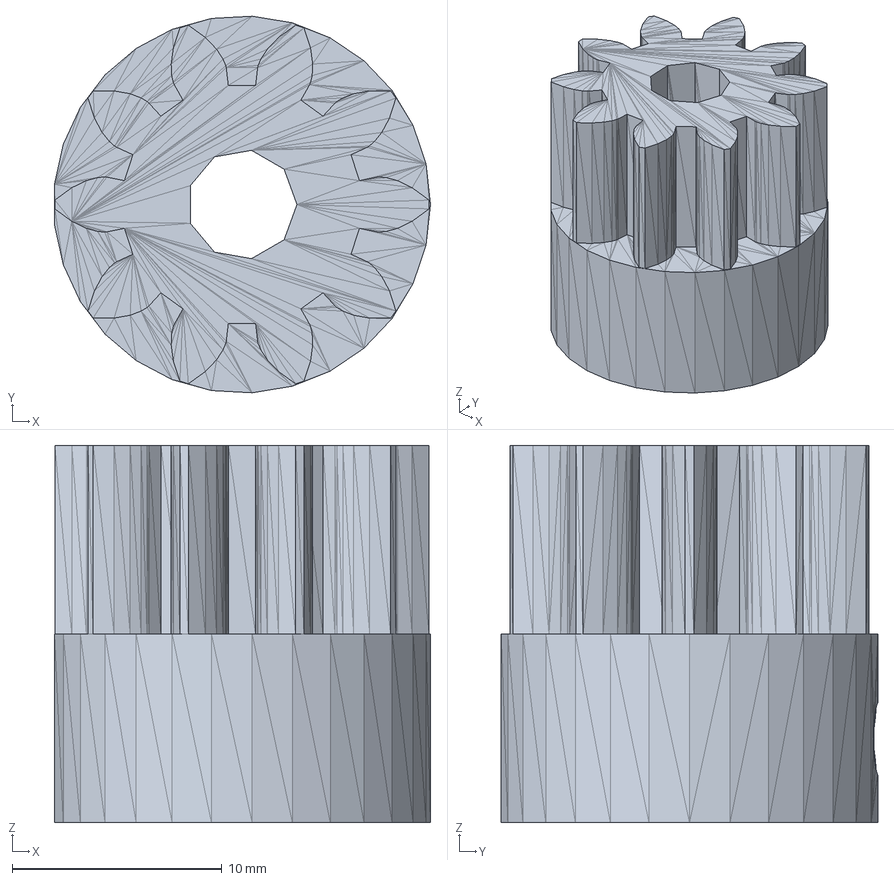
[picture p113: CAD file, 2011-11-22]
STEP/wade-small.stp
17.9 x 18.0 x 18.0 mm
