wifasoi/PrusaMendel/metric-prusa-lm8uu/z-motor-mount.stl

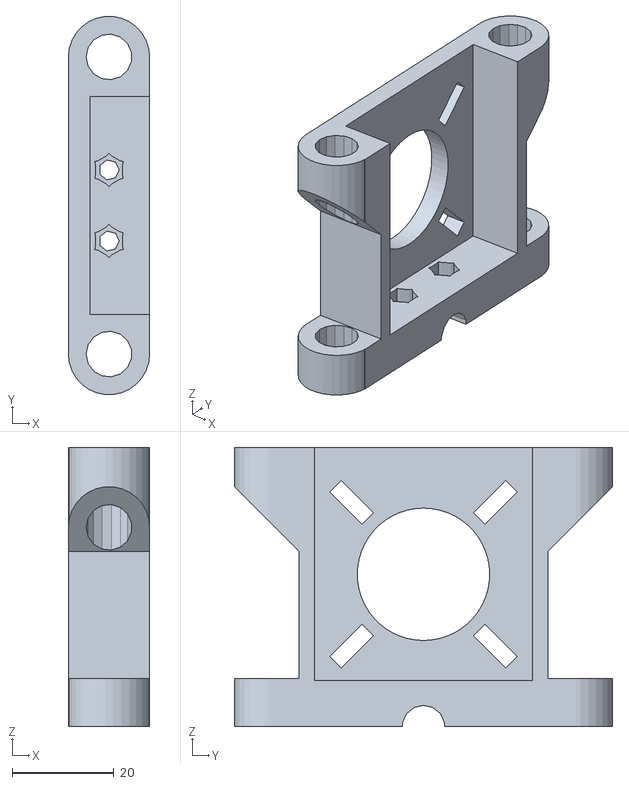
[picture p114: CAD file, 2011-11-21]
metric-prusa-lm8uu/z-motor-mount.stl
16.0 x 74.4 x 55.0
