wifasoi/PrusaMendel/metric-prusa/printable-bushing-lm8uu.stl

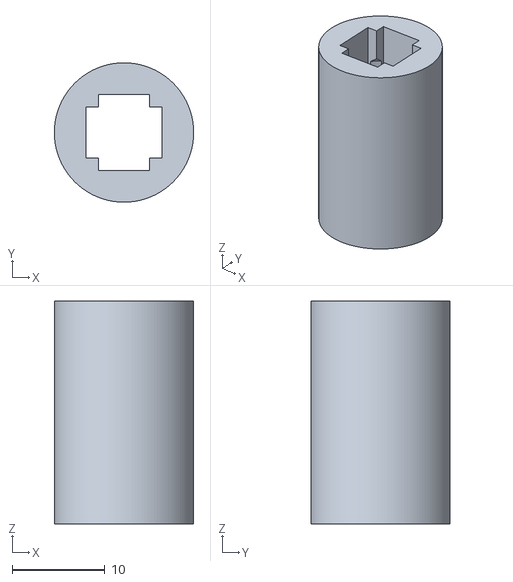
[picture p115: CAD file, 2011-11-21]
metric-prusa/printable-bushing-lm8uu.stl
15.0 x 15.0 x 24.0
