wifasoi/PrusaMendel/Stampante3D conversion/organized/Miscelenea parts/extruder/cartridge heater.SLDPRT

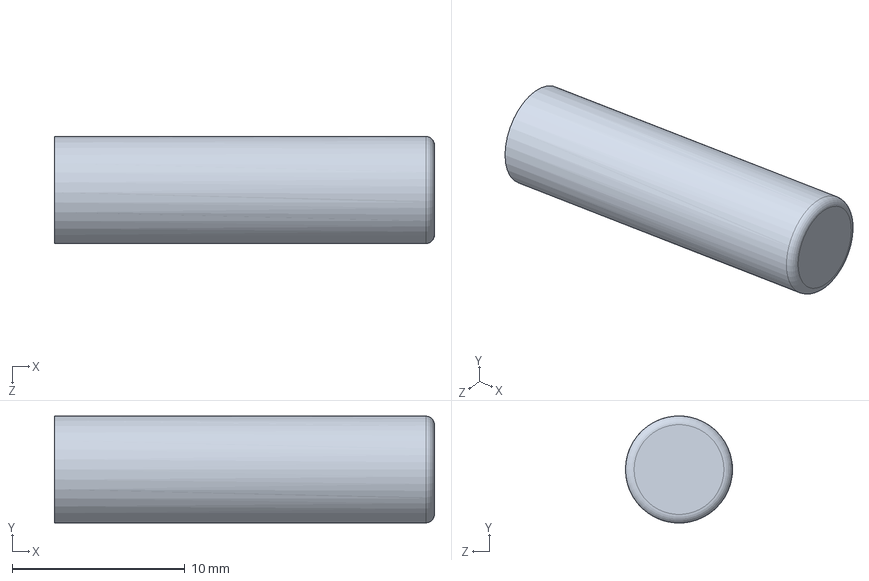
[picture p116: CAD file, 2015-09-02]
Stampante3D conversion/organized/Miscelenea parts/extruder/cartridge heater.SLDPRT
22.0 x 6.19 x 6.20 mm
