wifasoi/PrusaMendel/Stampante3D conversion/organized/Miscelenea parts/threaded rod, Z lower horizontal.SLDPRT

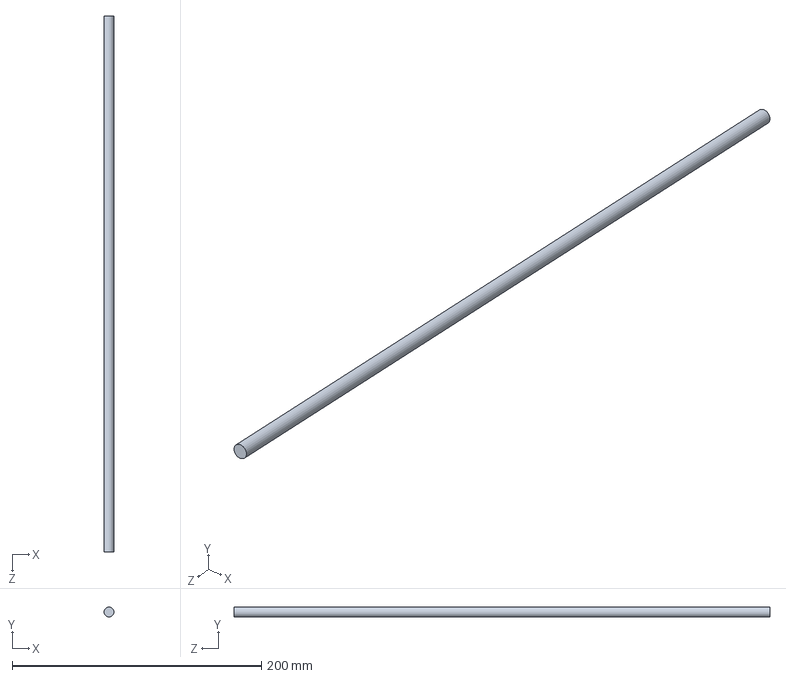
[picture p117: CAD file, 2015-09-10]
Stampante3D conversion/organized/Miscelenea parts/threaded rod, Z lower horizontal.SLDPRT
8.00 x 8.00 x 430.0 mm
