wifasoi/PrusaMendel/Stampante3D conversion/organized/Miscelenea plastic parts/lm8uu-bearing_mount.SLDPRT

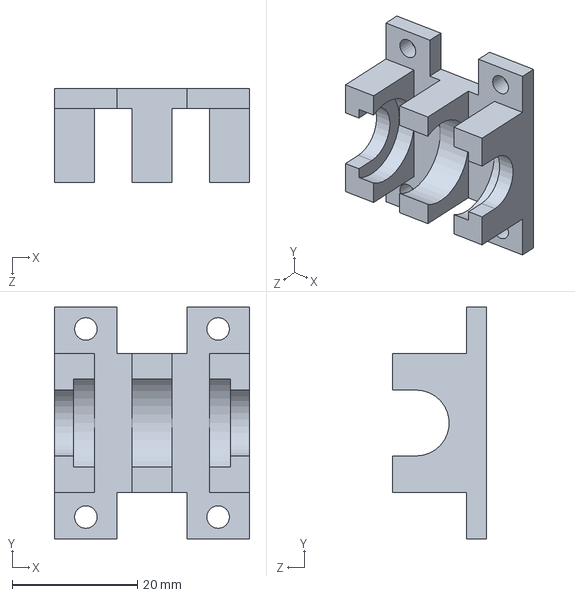
[picture p118: CAD file, 2015-07-19]
Stampante3D conversion/organized/Miscelenea plastic parts/lm8uu-bearing_mount.SLDPRT
31.1 x 37.0 x 15.0 mm
