wifasoi/PrusaMendel/STEP/x-carriage.stp

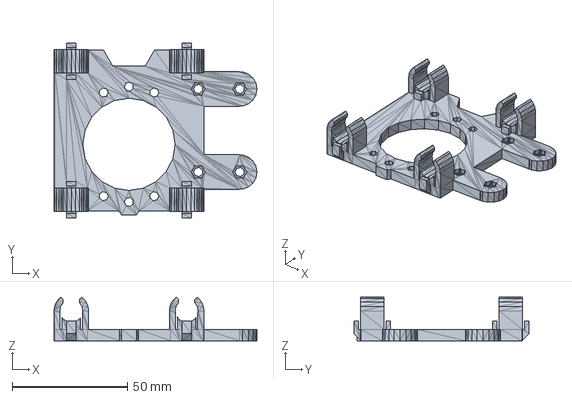
[picture p119: CAD file, 2011-11-22]
STEP/x-carriage.stp
88.0 x 76.0 x 18.9 mm
