wifasoi/PrusaMendel/SolidWorks/Imported/x-end-idler.stl.SLDPRT

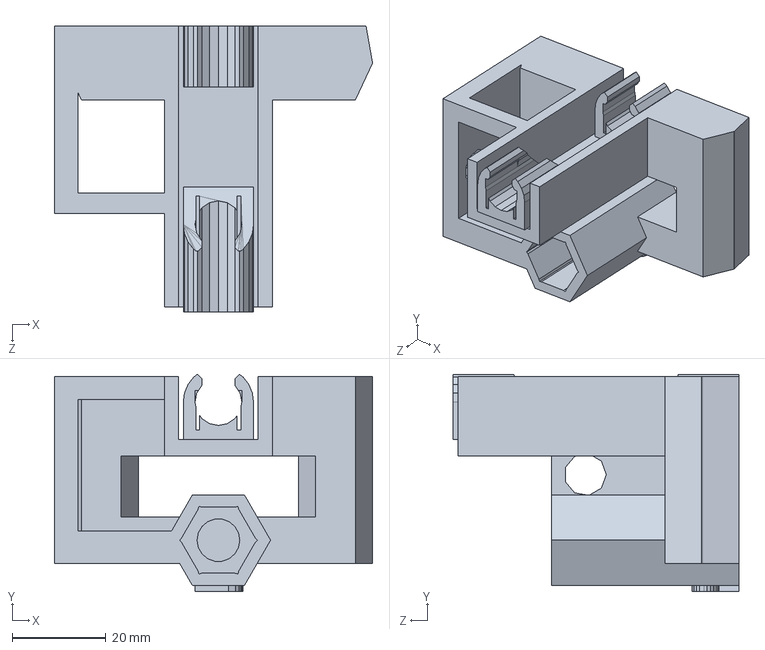
[picture p120: CAD file, 2011-11-22]
SolidWorks/Imported/x-end-idler.stl.SLDPRT
67.9 x 46.4 x 61.0 mm
