wifasoi/PrusaMendel/Stampante3D conversion/organized/Miscelenea parts/extruder/thermistor.SLDPRT

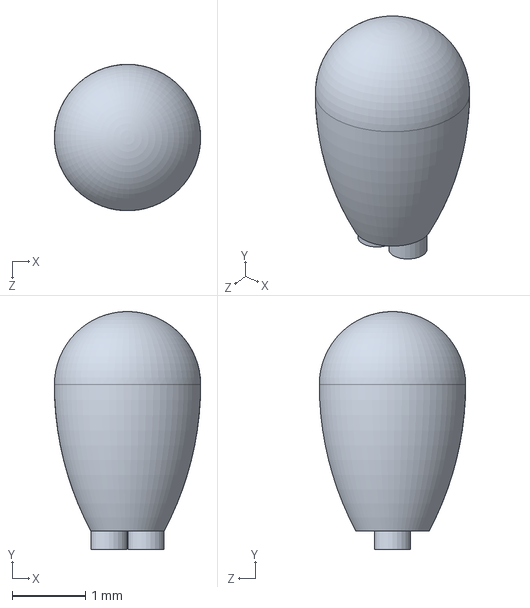
[picture p121: CAD file, 2015-09-02]
Stampante3D conversion/organized/Miscelenea parts/extruder/thermistor.SLDPRT
2.00 x 3.25 x 2.00 mm
