wifasoi/PrusaMendel/Stampante3D conversion/organized/Miscelenea parts/threaded rod, frame triangle.SLDPRT

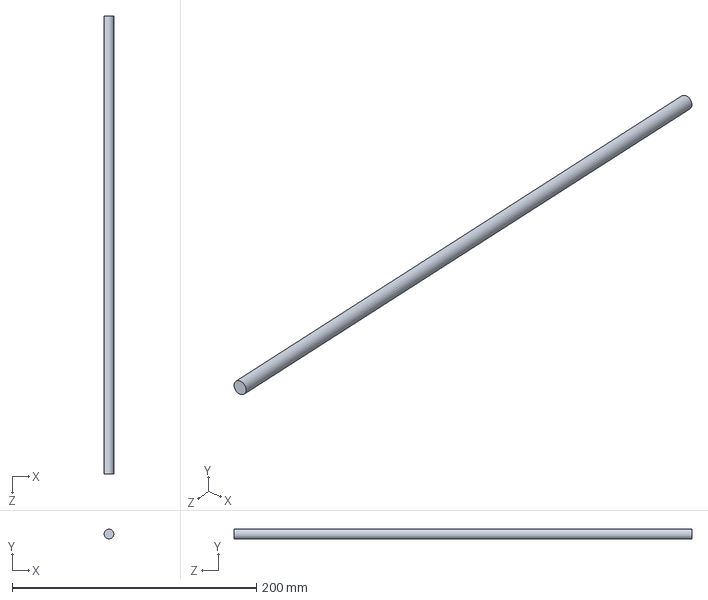
[picture p122: CAD file, 2015-09-10]
Stampante3D conversion/organized/Miscelenea parts/threaded rod, frame triangle.SLDPRT
8.00 x 8.00 x 375.0 mm
