wifasoi/PrusaMendel/STEP/printable-bushing.stp

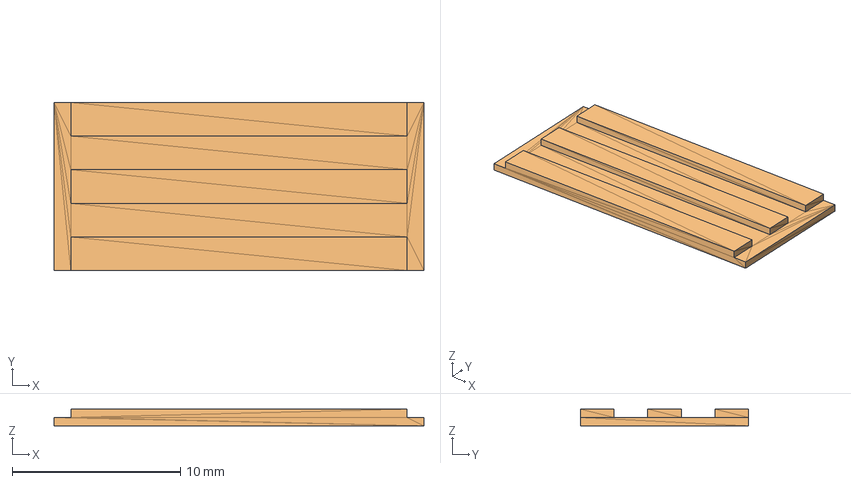
[picture p123: CAD file, 2011-11-22]
STEP/printable-bushing.stp
22.0 x 10.0 x 1.00 mm
