wifasoi/PrusaMendel/metric-prusa-lm8uu/wade.stl

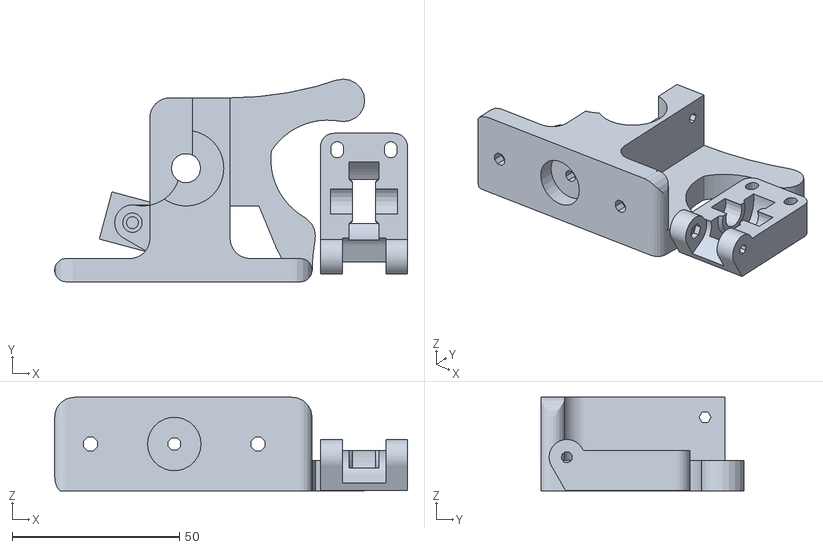
[picture p124: CAD file, 2011-11-21]
metric-prusa-lm8uu/wade.stl
105.5 x 60.6 x 28.0
