wifasoi/PrusaMendel/Stampante3D conversion/organized/Miscelenea parts/extruder/E3D Nozzle.SLDPRT

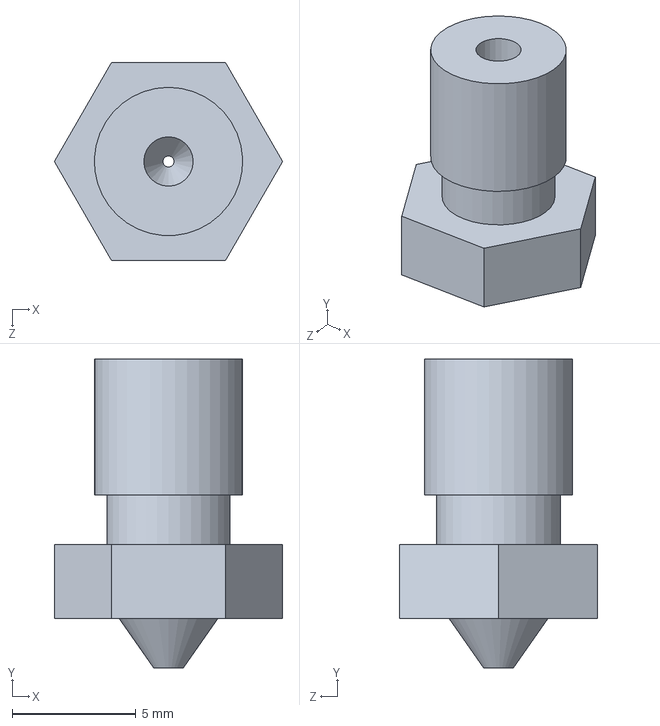
[picture p125: CAD file, 2015-09-02]
Stampante3D conversion/organized/Miscelenea parts/extruder/E3D Nozzle.SLDPRT
9.24 x 12.5 x 8.00 mm
