wifasoi/PrusaMendel/STEP/y-bushing lm8uu.stp

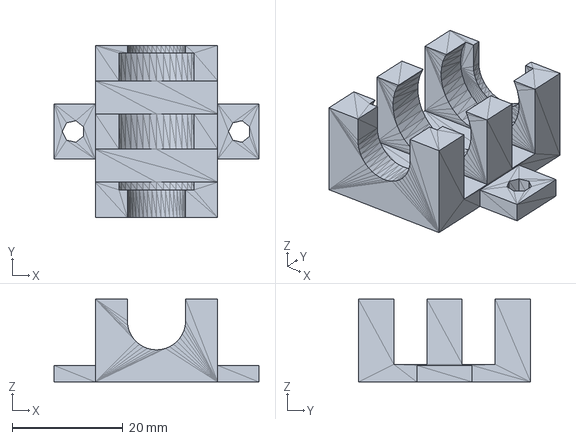
[picture p126: CAD file, 2011-11-22]
STEP/y-bushing lm8uu.stp
37.0 x 31.1 x 15.0 mm
