wifasoi/PrusaMendel/metric-prusa/x-end-motor.stl

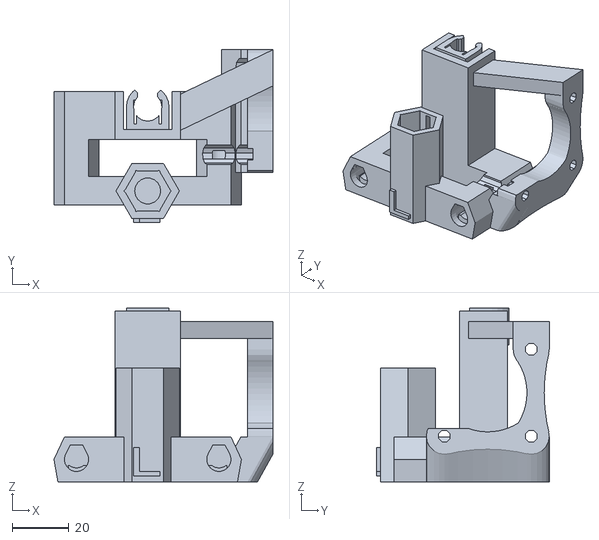
[picture p127: CAD file, 2011-11-21]
metric-prusa/x-end-motor.stl
76.9 x 60.6 x 61.0
