wifasoi/PrusaMendel/Stampante3D conversion/organized/Miscelenea parts/GT2 tooth.SLDPRT

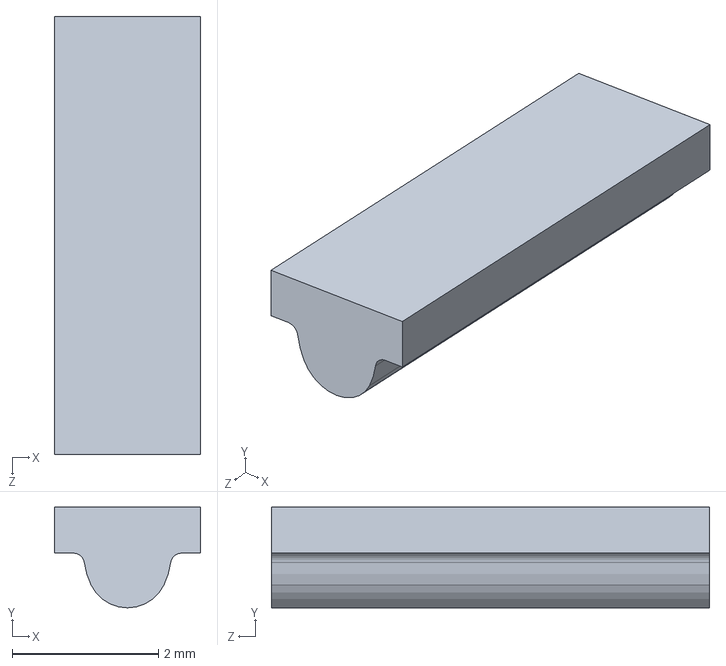
[picture p128: CAD file, 2015-09-02]
Stampante3D conversion/organized/Miscelenea parts/GT2 tooth.SLDPRT
2.00 x 1.38 x 6.00 mm
