wifasoi/PrusaMendel/STEP/ybrac-t.stp

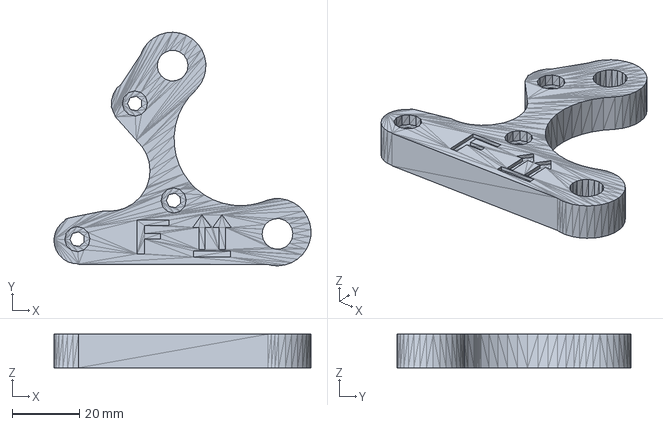
[picture p129: CAD file, 2011-11-22]
STEP/ybrac-t.stp
76.4 x 69.4 x 10.0 mm
