wifasoi/PrusaMendel/Stampante3D conversion/organized/Miscelenea parts/608 SKF.SLDPRT

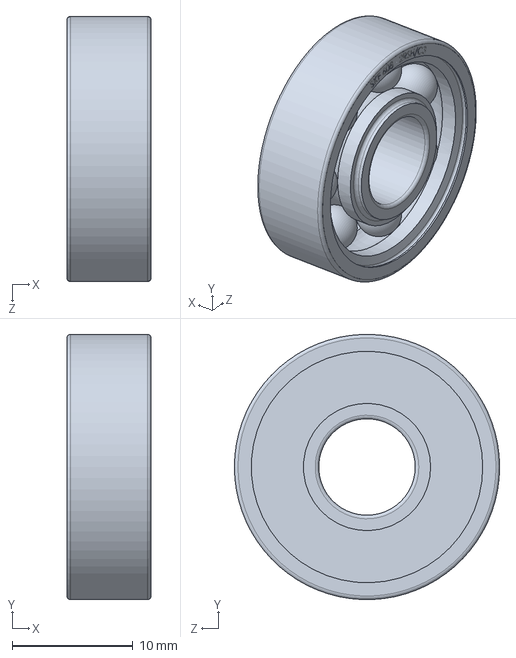
[picture p130: CAD file, 2015-07-27]
Stampante3D conversion/organized/Miscelenea parts/608 SKF.SLDPRT
7.00 x 22.0 x 22.0 mm
