wifasoi/PrusaMendel/Stampante3D conversion/organized/Miscelenea parts/extruder/E3D Heatsink.SLDPRT

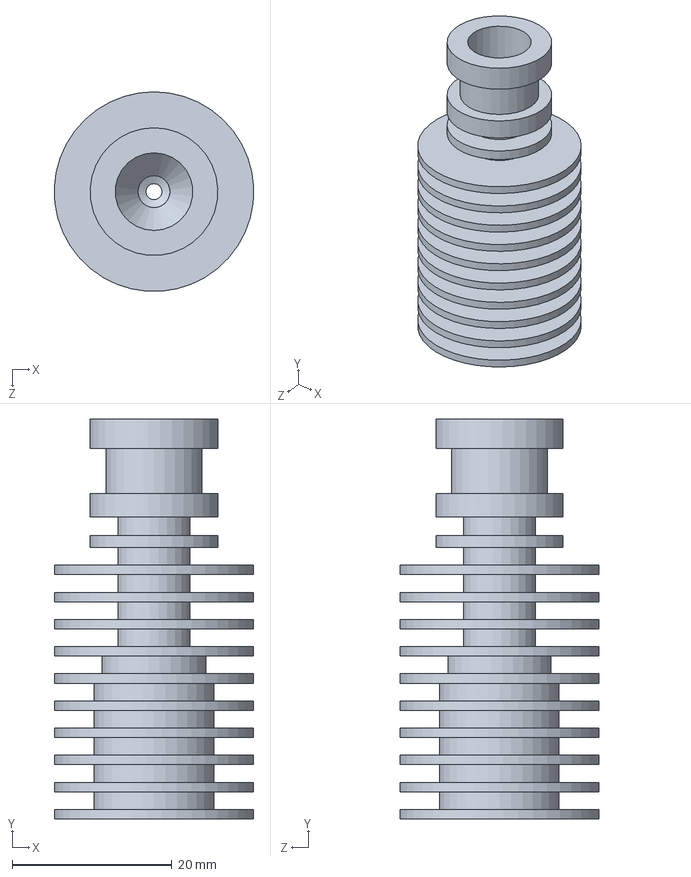
[picture p131: CAD file, 2015-09-02]
Stampante3D conversion/organized/Miscelenea parts/extruder/E3D Heatsink.SLDPRT
25.0 x 50.1 x 25.0 mm
