wifasoi/PrusaMendel/metric-prusa-lm8uu/pulley.stl

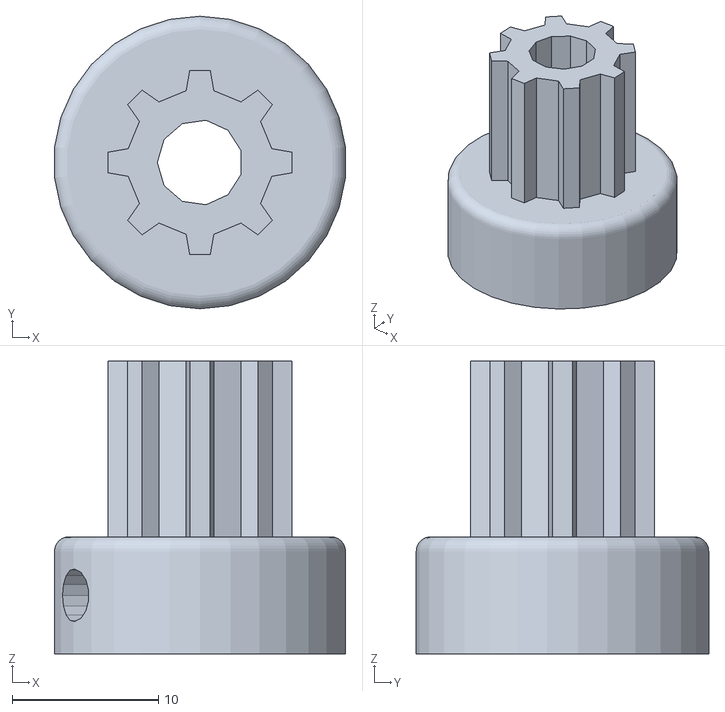
[picture p132: CAD file, 2011-11-21]
metric-prusa-lm8uu/pulley.stl
19.9 x 20.0 x 20.0
