wifasoi/PrusaMendel/metric-prusa/side test.stl

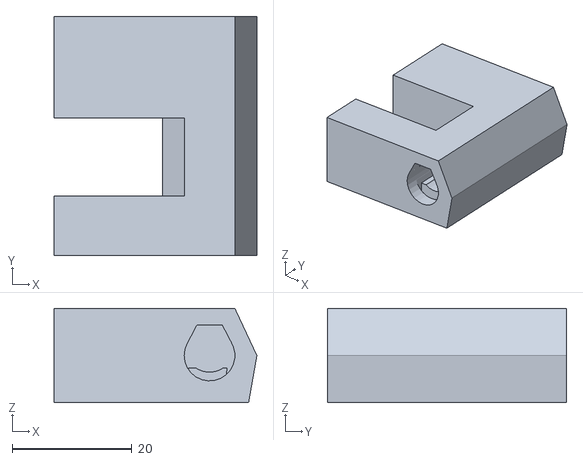
[picture p133: CAD file, 2011-11-21]
metric-prusa/side test.stl
33.9 x 40.0 x 15.8
