wifasoi/PrusaMendel/Stampante3D conversion/organized/Miscelenea parts/extruder/E3D.STEP

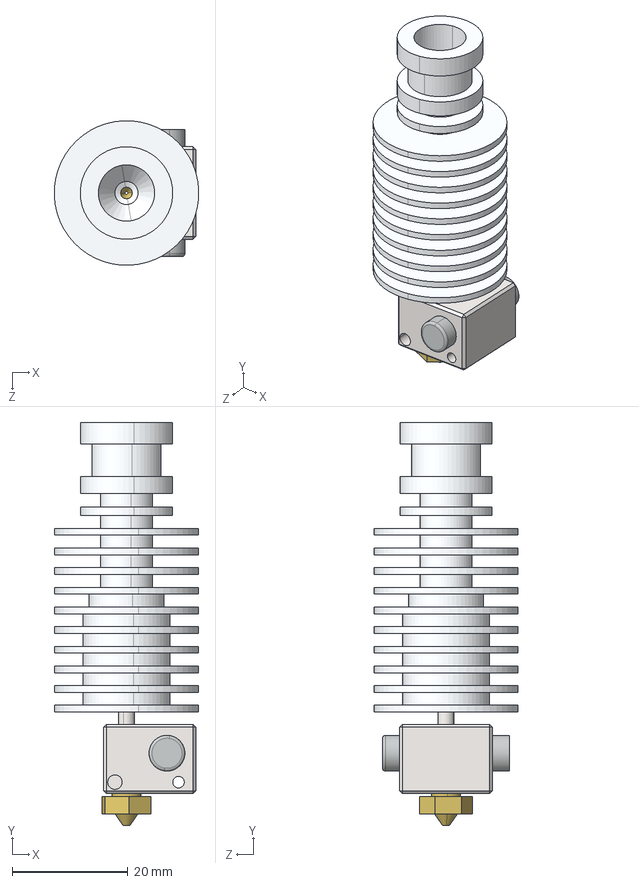
[picture p134: CAD file, 2015-09-02]
Stampante3D conversion/organized/Miscelenea parts/extruder/E3D.STEP
25.0 x 69.7 x 25.0 mm
E3D Heat Block
E3D Heatbreak
E3D Nozzle
E3D Heatsink_1.75 Bowden
cartridge heater
