wifasoi/PrusaMendel/Stampante3D conversion/organized/Miscelenea parts/GT2 pulley 6mm.SLDPRT

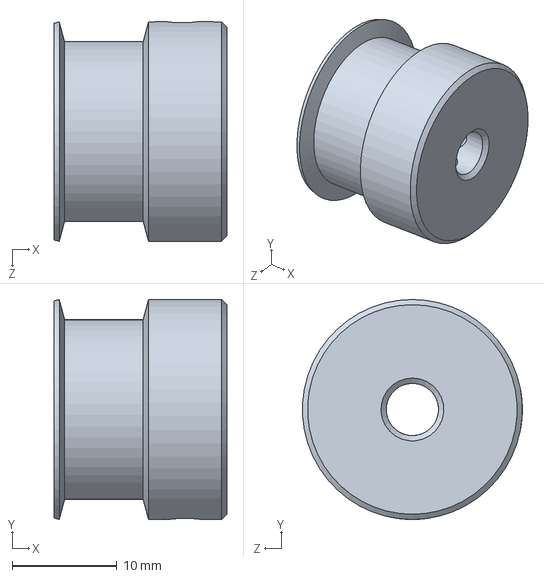
[picture p135: CAD file, 2015-07-27]
Stampante3D conversion/organized/Miscelenea parts/GT2 pulley 6mm.SLDPRT
16.5 x 21.0 x 21.0 mm
