wifasoi/PrusaMendel/STEP/bar-clamp.stp

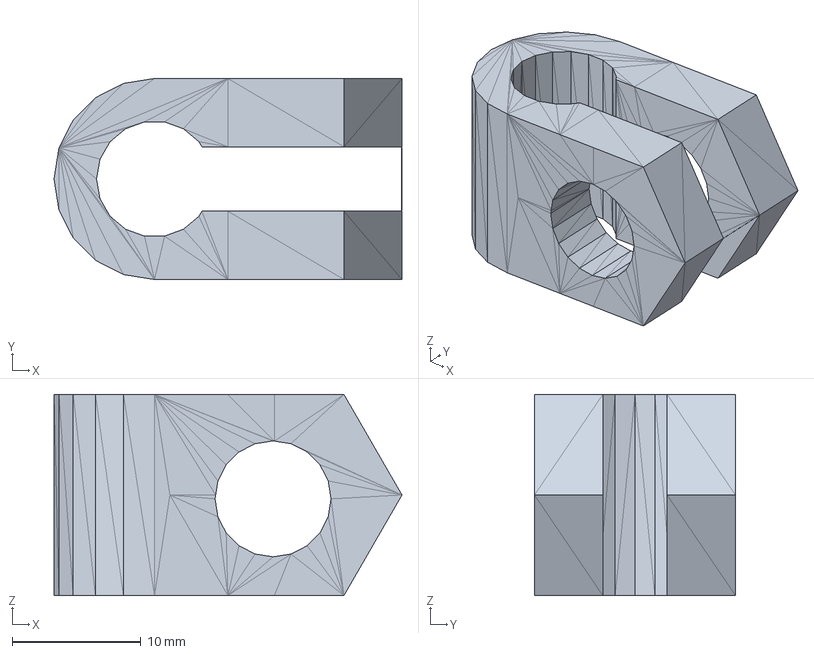
[picture p136: CAD file, 2011-11-22]
STEP/bar-clamp.stp
27.0 x 15.6 x 15.6 mm
