wifasoi/PrusaMendel/(list of files, cad)

Other CAD files:
Stampante3D conversion/organized/Miscelenea parts/extruder/E3D_1.sldasm
SolidWorks/Prusa 2 Y Carriage - Bushings.SLDASM
Stampante3D conversion/organized/Miscelenea parts/extruder/E3D Heat Block_1.sldprt
STEP/rod-clamp.stp
Stampante3D conversion/organized/Frame/Frame-feet.SLDPRT
Stampante3D conversion/organized/Miscelenea parts/extruder/cartridge heater_1.sldprt
Stampante3D conversion/organized/Y axis/Belt mount/Belt mount/Belt_mount-Top.SLDPRT
STEP/sanguinololu-holder.stp
SolidWorks/Imported/bearing-guide.stl.SLDPRT
Stampante3D conversion/organized/Frame/Frame-vertex -feet.SLDPRT
Stampante3D conversion/organized/Miscelenea parts/extruder/E3D Nozzle_1.sldprt
Stampante3D conversion/organized/Miscelenea parts/threaded rod, Z frame horizontal.SLDPRT
Stampante3D conversion/organized/X axis/X-carriage/X-head_carriage-Hot_end-Clamp.SLDPRT
Stampante3D conversion/organized/Miscelenea plastic parts/Middle_clamp-Left.SLDPRT
STEP/frame-vertex-foot.stp
SolidWorks/Prusa 2 Skeleton.SLDPRT
Stampante3D conversion/Export/Steps/Belt_mount-Bottom.STEP
Stampante3D conversion/organized/Miscelenea parts/extruder/E3D Heatbreak_1.sldprt
STEP/belt-clamp.stp
metric-prusa-lm8uu/frame-vertex.stl
Stampante3D conversion/Export/Steps/X-head_carriage.STEP
SolidWorks/x-carriage lm8uu.SLDPRT
Stampante3D conversion/Export/Steps/Belt_tensioner-Base.STEP
metric-prusa/coupling.stl
Stampante3D conversion/Export/Steps/Frame-feet.STEP
SolidWorks/Imported/z-motor-mount.stl.SLDPRT
SolidWorks/x-end-motor lm8uu.SLDPRT
Stampante3D conversion/Export/Steps/Z-bar-clamp.STEP
SolidWorks/Imported/x-end-motor.stl.SLDPRT
Stampante3D conversion/Export/Steps/wifa_clamp.STEP
Stampante3D conversion/organized/Miscelenea parts/extruder/E3D Heatsink_1.75 Bowden.sldprt
metric-prusa-lm8uu/coupling.stl
SolidWorks/Imported/wade-big.stl.SLDPRT
Stampante3D conversion/Export/Steps/X-motor.STEP
STEP/endstop-holder.stp
SolidWorks/Imported/pulley.stl.SLDPRT
Stampante3D conversion/Export/Steps/Y-Motor-clamp.STEP
metric-prusa-lm8uu/rod-clamp.stl
metric-prusa/bar-clamp.stl
SolidWorks/Imported/x-carriage.stl.SLDPRT
Stampante3D conversion/Export/Steps/Middle_clamp-Left.STEP
STEP/coupling.stp
metric-prusa/ybrac-t.stl
SolidWorks/Imported/printable-bushing.stl.SLDPRT
source/configuration.scad
source/inc/parametric_involute_gear_v5.0.scad
source/x-end-motor.scad
source/z-motor-mount.scad
STEP/belt-clamp-nut-holder.stp
STEP/frame-vertex.stp
STEP/pulley.stp
STEP/y-bushing.stp
STEP/z-motor-mount.stp
SolidWorks/Imported/bar-clamp.stl.SLDPRT
SolidWorks/Imported/belt-clamp-nut-holder.stl.SLDPRT
SolidWorks/Imported/belt-clamp.stl.SLDPRT
SolidWorks/Imported/frame-vertex.stl.SLDPRT
SolidWorks/Imported/printable-bushing-lm8uu.stl.SLDPRT
SolidWorks/Imported/rod-clamp.stl.SLDPRT
SolidWorks/Imported/sanguinololu-holder.stl.SLDPRT
SolidWorks/Imported/side test.stl.SLDPRT
SolidWorks/Imported/wade idler.stl.SLDPRT
SolidWorks/Imported/wade-small.stl.SLDPRT
SolidWorks/Imported/x-carriage lm8uu.stl.SLDPRT
SolidWorks/Imported/x-end-idler lm8uu.stl.SLDPRT
SolidWorks/Imported/y-bushing lm8uu.stl.SLDPRT
SolidWorks/Imported/y-bushing.stl.SLDPRT
SolidWorks/Imported/ybrac-t.stl.SLDPRT
SolidWorks/Prusa 2 Z Screw.SLDASM
SolidWorks/Vitamins/set screw, cup point, M3x6.SLDPRT
SolidWorks/Vitamins/set screw, cup point, M4x6.SLDPRT
SolidWorks/bar-clamp.SLDPRT
SolidWorks/belt-clamp-nut-holder.SLDPRT
SolidWorks/belt-clamp.SLDPRT
SolidWorks/coupling.SLDPRT
SolidWorks/crowned bearing-guide 608.SLDPRT
SolidWorks/crowned bearing-guide 688.SLDPRT
SolidWorks/crowned bearing-guide.SLDDRW
SolidWorks/endstop-holder.SLDPRT
SolidWorks/frame-vertex-foot.SLDPRT
SolidWorks/frame-vertex.SLDPRT
SolidWorks/printable-bushing-lm8uu.SLDPRT
SolidWorks/printable-bushing.SLDPRT
SolidWorks/pulley.SLDPRT
SolidWorks/rod-clamp.SLDPRT
SolidWorks/sanguinololu-holder.SLDPRT
SolidWorks/side test.SLDPRT
SolidWorks/wade frame.SLDPRT
SolidWorks/wade idler.SLDPRT
SolidWorks/wade-small.SLDPRT
SolidWorks/x-carriage.SLDPRT
SolidWorks/x-end-idler lm8uu.SLDPRT
SolidWorks/x-end-idler.SLDPRT
SolidWorks/x-end-motor.SLDPRT
SolidWorks/y-bushing lm8uu.SLDPRT
SolidWorks/y-bushing.SLDPRT
SolidWorks/ybrac-t.SLDPRT
SolidWorks/z-motor-mount.SLDPRT
Stampante3D conversion/Export/STLs/Belt_mount-Bottom.STL
Stampante3D conversion/Export/STLs/Belt_mount-Top.STL
Stampante3D conversion/Export/STLs/Belt_tensioner-Base.STL
Stampante3D conversion/Export/STLs/Belt_tensioner-Slider-Bot.STL
Stampante3D conversion/Export/STLs/Belt_tensioner-Slider-Top.STL
Stampante3D conversion/Export/STLs/Frame-feet.STL
Stampante3D conversion/Export/STLs/Frame-vertex.STL
Stampante3D conversion/Export/STLs/Middle_clamp-Left.STL
Stampante3D conversion/Export/STLs/Middle_clamp-Right.STL
Stampante3D conversion/Export/STLs/X-head_carriage-Hot_end-Clamp.STL
Stampante3D conversion/Export/STLs/X-head_carriage.STL
Stampante3D conversion/Export/STLs/X-idle.STL
Stampante3D conversion/Export/STLs/X-motor.STL
Stampante3D conversion/Export/STLs/Y-Motor-clamp.STL
Stampante3D conversion/Export/STLs/Z-Motor-clamp.STL
Stampante3D conversion/Export/STLs/Z-bar-clamp.STL
Stampante3D conversion/Export/STLs/lm8uu-mount.STL
Stampante3D conversion/Export/STLs/wifa_clamp.STL
Stampante3D conversion/Export/Steps/Belt_tensioner-Slider-Bot.STEP
Stampante3D conversion/Export/Steps/Belt_tensioner-Slider-Top.STEP
Stampante3D conversion/Export/Steps/Middle_clamp-Right.STEP
Stampante3D conversion/Export/Steps/X-idle.STEP
Stampante3D conversion/Export/Steps/lm8uu-mount.STEP
Stampante3D conversion/old part (only for reference)/Frame-feet-newtry.SLDPRT
Stampante3D conversion/old part (only for reference)/Frame-vertex -feet.SLDPRT
Stampante3D conversion/old part (only for reference)/Frame-vertex-newtry.SLDPRT
Stampante3D conversion/old part (only for reference)/Frame-vertex.SLDPRT
Stampante3D conversion/old part (only for reference)/Middle_clamp.SLDPRT
Stampante3D conversion/old part (only for reference)/X-rod_mount-Motor.SLDPRT
Stampante3D conversion/old part (only for reference)/Y-Motor mount.DWG
Stampante3D conversion/old part (only for reference)/Y-Motor-clamp.SLDPRT
Stampante3D conversion/old part (only for reference)/Z-Motor-clamp.SLDPRT
Stampante3D conversion/old part (only for reference)/Z-bar-clamp.SLDPRT
Stampante3D conversion/old part (only for reference)/frame-vertex.DXF
Stampante3D conversion/old part (only for reference)/lm8uu-bearing_mount.SLDPRT
Stampante3D conversion/old part (only for reference)/wifa_clamp.SLDPRT
Stampante3D conversion/old part (only for reference)/x-lm8uu-clamp/x-lm8uu-clamp.SLDPRT
Stampante3D conversion/old part (only for reference)/x-lm8uu-clamp/ziptie-ring.SLDPRT
Stampante3D conversion/organized/Frame/Old/Frame-vertex -feet.SLDPRT
Stampante3D conversion/organized/Frame/Old/Frame-vertex.SLDPRT
Stampante3D conversion/organized/Miscelenea parts/Bearing, 608-2RS.SLDPRT
Stampante3D conversion/organized/Miscelenea parts/Bearing, 688-2RS.SLDPRT
Stampante3D conversion/organized/Miscelenea parts/Linear Bearing, LM8UU.SLDPRT
Stampante3D conversion/organized/Miscelenea parts/M8 fender washer.SLDPRT
Stampante3D conversion/organized/Miscelenea parts/Socket Head Cap Screw DIN 912, ISO 4762.SLDPRT
Stampante3D conversion/organized/Miscelenea parts/Spring.SLDPRT
Stampante3D conversion/organized/Miscelenea parts/Y Carriage Plate.SLDPRT
Stampante3D conversion/organized/Miscelenea parts/barra prova.SLDPRT
Stampante3D conversion/organized/Miscelenea parts/extruder/E3D.IGS
Stampante3D conversion/organized/Miscelenea parts/extruder/E3D.SLDASM
Stampante3D conversion/organized/Miscelenea parts/extruder/E3D.STL
Stampante3D conversion/organized/Miscelenea parts/flat washer, DIN 125.SLDPRT
Stampante3D conversion/organized/Miscelenea parts/hex nut, DIN 934.SLDPRT
Stampante3D conversion/organized/Miscelenea parts/hex nut, flat washer, DIN 125, 934.SLDASM
Stampante3D conversion/organized/Miscelenea parts/my_pulley.SLDPRT
Stampante3D conversion/organized/Miscelenea parts/stepper motor, NEMA 17.SLDPRT
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
