wifasoi/PrusaMendel/(commit log)

2011-11-20 Added STEP AP214
    [frame-vertex.SLDPRT, pulley.SLDPRT]
2011-11-20 Started Prusa assembly in SW
    [110607.00 Prusa.SLDASM, 110607.00 Skeleton.SLDPRT, Skeleton.SLDPRT, pulley T5 10.STL]
2011-11-21 Renamed folder
    [110607.00 Prusa.SLDASM, 110607.00 Skeleton.SLDPRT, Body1.sldprt, Body2.sldprt, Body3.sldprt, Skeleton.SLDPRT, Wade Gear.SLDPRT, Wade Idler.SLDPRT]
2011-11-22 Created STEP files and imported into SolidWorks 2012 part files from the recently merged felt branch.
    [110607.00 Prusa.SLDASM, 110607.00 Skeleton.SLDPRT, Wade Idler.STEP, bar-clamp.SLDPRT, bar-clamp.STEP, bar-clamp.stl.SLDPRT, bar-clamp.stp, bearing-guide.stl.SLDPRT]
2011-11-30 Added crowned pulley ("bearing guide") and exports from SolidWorks in stl, dwg, and pdf. Those wanting to recreate the design in some other CAD software can find the dimensions in the dwg or pdf.
    [bearing-guide.stl.SLDPRT, crowned bearing-guide 608.SLDPRT, crowned bearing-guide 608.STL, crowned bearing-guide 688.SLDPRT, crowned bearing-guide 688.STL, crowned bearing-guide.DWG, crowned bearing-guide.SLDDRW]
2012-01-01 -Began Assembly in SolidWorks -Frame done -Y axis nearly done -Z axis nearly done
    [110607.00 Prusa.SLDASM, 110607.00 Skeleton.SLDPRT, 110607.01 Frame.SLDASM, 110607.02 Y Axis.SLDASM, 110607.03 Idler pulley.sldasm, 110607.04 Pulley.sldasm, 110607.05 Z Axis.SLDASM, 110607.06 Z Screw.SLDASM]
2012-02-19 Renamed some files with "Prusa 2" prefix. Updated readme.
    [110607.00 Prusa.SLDASM, 110607.00 Skeleton.SLDPRT, 110607.01 Frame.SLDASM, 110607.02 Y Axis.SLDASM, 110607.03 Idler pulley.sldasm, 110607.04 Pulley.sldasm, 110607.05 Z Axis.SLDASM, 110607.06 Z Screw.SLDASM]
2015-07-08 polish model and modify the models
    [Bearing, 608-2RS.SLDPRT, Belt, Y Axis, T5.SLDPRT, Linear Bearing, LM8UU.SLDPRT, Prusa 2 Frame.SLDASM, Prusa 2 Idler pulley.sldasm, Prusa 2 Pulley.sldasm, Prusa 2 Skeleton.SLDPRT, Prusa 2 X Axis LM8UU.SLDASM]
2015-07-08 add a better rail clamp
    [wifa_clamp.SLDPRT]
2015-07-11 added a better clamp
2015-07-13 total conversion in Solidworks 2015
    [Bearing, 608-2RS.SLDPRT, Bearing, 688-2RS.SLDPRT, Frame-vertex -feet.SLDPRT, Frame-vertex.SLDPRT, Socket Head Cap Screw DIN 912, ISO 4762.SLDPRT, X-common.SLDPRT, X-hex-shaft.SLDPRT, X-idle.SLDPRT]
2015-07-15 fixed some aligment problem
    [Frame-feet-newtry.SLDPRT, Frame-feet.SLDPRT, Frame-vertex -feet.SLDPRT, Frame-vertex-newtry.SLDPRT, Frame-vertex.SLDPRT, Middle_clamp.SLDPRT, Y-Motor-clamp.SLDPRT]
2015-07-18 added assembled part
    [Prusa 2 assembled.SLDASM, Z-Motor-clamp.SLDPRT, wifa_clamp.SLDPRT, wifa_clamp.STL]
2015-07-19 made the model more 3d printer friendly
    [Frame-feet-newtry.SLDPRT, Frame-feet.STEP, Frame-feet.STL, Frame-vertex -feet.SLDPRT, Frame-vertex-newtry.SLDPRT, Frame-vertex.SLDPRT, Frame-vertex.STEP, Frame-vertex.STL]
2015-07-25 adjust the X axis parts
    [Coupling-hex_recess.SLDPRT, Coupling.SLDPRT, Prusa 2 assembled.SLDASM, Spring.SLDPRT, X-common.SLDPRT, X-idle.SLDPRT, X-motor.SLDPRT, x-lm8uu-clamp.SLDPRT]
2015-07-27 added a TODO list, corrected some part (x-carrige), changed the
    [608 SKF.SLDPRT, Coupling-hex_recess.STEP, Coupling-hex_recess.STL, Coupling.STEP, Coupling.STL, Frame-feet.STEP, Frame-feet.STL, Frame-vertex.STEP]
2015-07-27 added a TODO list, corrected some part (x-carrige), changed the ho clamp z axis bar
2015-07-28 added a BOM and updated the TODO file. Exported all the file to stl and step format
    [BOM.csv, BOM.xls, Coupling-hex_recess.STEP, Coupling-hex_recess.STL, Coupling.STEP, Coupling.STL, Frame-feet.STEP, Frame-vertex.STEP]
2015-08-06 beefed up the bearing mount
    [Prusa 2 assembled.SLDASM, X-idle.SLDPRT, X-idle.STEP, X-idle.STL, X-motor.SLDPRT, X-motor.STEP, X-motor.STL, lm8uu-mount.SLDPRT]
2015-08-07 added a sketch for a switch limiter holder
    [Z-axis-Microswitch_holder.SLDPRT]
2015-08-31 added the x extruder carriage
    [X-head_carriage.SLDPRT]
2015-09-01 modified the head carriedge
    [Prusa 2 assembled.SLDASM, X-head_carriage.SLDPRT]
2015-09-02 Added the Y axis belt tensioner
    [Belt-tensioner.SLDASM, Belt_mount-Bottom.SLDPRT, Belt_mount-Top.SLDPRT, Belt_mount-tensioner.SLDPRT, Belt_tensioner-Base.SLDPRT, Belt_tensioner-Slider-Bot.SLDPRT, Belt_tensioner-Slider-Top.SLDPRT, E3D Heat Block.SLDPRT]
2015-09-02 addet the belt mounts to the assembly
    [Belt_mount-Bottom.SLDPRT, Belt_mount-Top.SLDPRT, Belt_mount.SLDASM, Prusa 2 assembled.SLDASM]
2015-09-05 Change the X carriage and converted the mittelab logo
    [Belt-tensioner.SLDASM, Belt_tensioner-Slider-Top.SLDPRT, Frame-vertex.SLDPRT, Prusa 2 assembled.SLDASM, X-motor.SLDPRT, mittelab.dxf]
2015-09-06 added a clamp for the hot end
    [Prusa 2 assembled.SLDASM, Socket Head Cap Screw DIN 912, ISO 4762.SLDPRT, X-carriage.SLDASM, X-head_carriage-Hot_end-Clamp.SLDPRT, X-head_carriage.SLDPRT, X-idle.SLDPRT, x-lm8uu-clamp.SLDPRT]
2015-09-09 Added middle Z clamp and exported all the necessary file for printing
    [Bearing cover.SLDPRT, Bearing cover.STEP, Bearing cover.STL, Belt_mount-Bottom.STEP, Belt_mount-Bottom.STL, Belt_mount-Top.STEP, Belt_mount-Top.STL, Belt_tensioner-Base.STEP]
2015-09-10 added some forgotten nuts
    [Prusa 2 assembled.SLDASM]
2015-09-10 changed the dimension of all the rods
    [Prusa 2 assembled.SLDASM, smooth rod, X axis.sldprt, smooth rod, Y axis.sldprt, smooth rod, Z axis.sldprt, threaded rod, Z frame horizontal.SLDPRT, threaded rod, Z lower horizontal.SLDPRT, threaded rod, Z screw.SLDPRT, threaded rod, frame horizontal.SLDPRT]
2015-09-13 uptaded BOM and TODO list
    [BOM.csv, BOM.xls, Belt_mount-Top.SLDPRT, Belt_mount.SLDASM, Prusa 2 assembled.SLDASM, X-carriage.SLDASM, X-head_carriage.SLDPRT, Y-Motor-clamp.SLDPRT]
2015-09-14 added a cold end extrusor
    [BOM.xls, Cold-end-Base.SLDPRT, Cold-end-Tensioner.SLDPRT, Extruder.SLDASM, Prusa 2 assembled.SLDASM, X-carriage.SLDASM, X-head_carriage.SLDPRT]
2015-12-04 Added mounting image
    [BOM.xls]
2016-06-02 modified the x carriedge and exported all the files
    [Bearing cover.STEP, Bearing cover.STL, Belt_mount-Bottom.STEP, Belt_mount-Top.STEP, Belt_mount-Top.STL, Belt_tensioner-Base.STEP, Belt_tensioner-Slider-Bot.STEP, Belt_tensioner-Slider-Top.STEP]
